yco252444-blip/gamja/none.md

# 미해결 항목 (2026-10-29 기준)

## 결정 필요
- [ ] 로드셀 5kg 유지 vs 10kg 교체 — 총 4.5~5.5kg 추정. 5kg 받으면 실제 무게 재서 4kg 넘으면 교체
- [ ] 디스플레이: TFT 3.5"(THL-CD08) vs OLED 0.96" — CAD 기본은 TFT, CLAUDE.md는 OLED. 3.5" 주문 여부 확인, 4" 교체 안 함 권장
- [ ] TFT 터치 사용 여부 — 안 쓰면 4선(SCK·MOSI·CS·DC)
- [ ] 아크릴 두께 3 vs 5 — 3t는 바닥 접시머리 M4 약함 → 5t 또는 냄비머리
- [ ] 케이스 뚜껑 여는 방식 (M3 8개 vs 자석)

## 주최측 문의
- [ ] 사전 제작 허용 범위 (makedot.edu@gmail.com)
- [ ] 외주 아크릴 레이저 제작물 사용 가능 여부, 예산
- [ ] 공구 대여: 글루건·실리콘, 납땜 인두·납, 열수축·스트리퍼, 멀티미터, 3D 프린터

## 구매·주문
- [ ] 아크릴 업체 견적·주문 (DXF `cad/dxf/` 6장, 11/1~2 주문 권장). 바닥판 접시머리는 따로 가공 요청
- [ ] 다이소 3L 밀폐용기 1개 추가 (같은 제품), 단열판, 방수판 PET 0.5
- [ ] 파파모미 PPR-123 (10/30 주문 예정)
- [ ] 추가 주문 예산 초과분 조정

## 실측 (미검증 값)
- [ ] 3L 통 높이(99), 바닥(240×170), 벽(3), 뚜껑(10)
- [ ] 로드셀 크기 80×12.7, 볼트 M4·간격 15 — 데이터시트 없음, 온도 범위 모름
- [ ] TFT 화면 세로 위치(가운데 가정), 유리 두께, 헤더 깊이
- [ ] 매트 케이블 선 개수·저항 (⑦⑧)
- [ ] 리락쿠마 배터리가 돼지머리 안에 들어가는지

## CAD 남은 일
- [ ] 실측 후 파라미터 수정
- [ ] 로드셀 스페이서 길이(30, 1/4보다 김), 격자판 3mm 강성 확인
- [ ] 회로 고정 위치: HX711, 전원 기판(MOSFET·퓨즈·WAGO), 서모스탯
- [ ] v02(옛 분해도)를 2b 방식으로 정리할지

## 문서
- [ ] CLAUDE.md #3 보드 표시창 항목을 디스플레이 결정 후 수정
- [ ] 배선도 Artifact 링크 삭제됨 — 필요하면 새로 올리기 (PDF는 최신)
