yco252444-blip/gamja/progress1028.md

# Oink 진행 정리 (2026-10-28)

제14회 Creative Space G AI&IoT 메이커톤 (본선 11/6~7), 오잉크팀 미생물 음식물 처리기.
"미검증" 표시는 실측·실물 확인 전인 값.

---

## 1. 부품 목록 / 구매

- 최신 소자 목록: `카카오톡 받은 파일/Oink_사용소자_목록_v11.xlsx` (합계 148,196원)
  - 전력 측정 부품 제거, 전 항목 링크 첨부 (행 밀림 오류 수정함)
- 황화수소 센서 **MQ-136으로 확정**
  - MQ-135(복합가스라 개별 가스 구분 불가), MQ-137(시험 시 잘 안 됨) 제외
  - 보드 포함 저가 모듈은 해외 배송뿐. 네이버 DONG 22,800원(색상 옵션 기본)도 해외 배송 7~9일
  - 국내 디바이스마트/엘레파츠는 소자 단품 52,250원 (보드 없이 부하저항 달아 사용 가능)
- 추가 주문서: `메이커톤-물품구매신청서_오잉크팀_추가주문.xlsx`
  - 추가: HX711 2,200 / 퓨즈 3A 198×2 / MQ136(디바이스마트) 52,250
  - 합계 352,166원 → **예산 초과**
  - 단가 주의: MH-Z19E 24,300 표기 → VAT 포함 26,730 / ANEX 드라이버 31,400 → 34,540
  - 디바이스마트 66,000원 이상 무료배송
- **아직 목록에 없음: 패드 스위칭용 MOSFET 모듈 또는 릴레이 모듈**

## 2. 스킬

- `mitsuhiko/agent-stuff/skills/openscad` → `.claude/skills/openscad` 설치 (Windows 경로 패치, 미커밋)

## 3. 외관 CAD (`cad/oink_exterior.scad`)

- OpenSCAD, `view=` 번호로 부품별 보기
  - 1 전체조립, 2 분해도, 3 앞판, 4 뒤판, 5 왼쪽판, 6 오른쪽판, 7 바닥판, 8 뚜껑, 9 브래킷16
  - 10 돼지머리 조립, 11 머리몸통, 12 돼지 뒤판(센서판), 13 코+귀, 14 칸막이, 15 뒤판 뗀 모습
  - 16 평면 치수도, 17 측면 치수도, 18 이음판 13개
- 치수
  - 육묘패드 220×150 → 챔버(락앤락 통) 230×160×350 (여유 2 + 벽 3, 높이 30~40cm 중 35)
  - 패드는 통 바닥에 깔고 그 위에 흙 바로
  - 케이스 바깥 246×220×391, 벽 두께 4, 챔버~벽 간격 4
  - 앞쪽 전장칸 40mm (칸막이로 분리: 보조배터리·LCD·회로)
  - 바닥 25mm는 로드셀 층
- 출력: 뱀부 P1S(베드 256) 기준. 벽판 높이 383 > 256이라 위/아래 2조각 + 이음판(M3) 13개
  - `half=1/2`로 조각별 STL, 모서리는 L 브래킷(M3)
- 돼지머리: 마인크래프트풍 둥근 네모(100×90×80), 속 빔
  - 뒤판 = 센서판 (M3로 모서리 보스에 체결), 코·세모 귀는 따로 출력해서 본드
  - 심부온도 탐침 구멍은 머리 밑
- LCD(THL-CD08) 치수: PCB 96×55, 구멍 Ø3.2 간격 90×49.5 (표시영역은 추정 74×50)
- 결과물: `cad/previews/` 미리보기 19장, `cad/stl/` STL 17개 (왼쪽판_위 누락 문제 해결함)
- 시제품 개념도(초기안, 돼지머리 이전): https://claude.ai/artifact/GmqkkYFcXGFWjeHJrM2cas

## 4. 전원·배선

배선도 페이지 (팀 구상 + 권장안 + 피드백 + 핀표 + 전력 예산):
https://claude.ai/artifact/RuXnQ4B4q9YJevh5LUJhgb (비공개, 팀 공유는 Share 메뉴에서)

### 팀 구상
| 위치 | 내용 | 전원 |
|---|---|---|
| 돼지머리 | XIAO #1 + MQ-136 + MH-Z19E + DS18B20 | 리락쿠마 보조배터리 (10000mAh, 22W, 고리형 케이블) |
| 락앤락 통 | 육묘패드 + 로드셀, 선은 통 밖으로 | 외부전원, **전용 XIAO #2**가 제어 |
| 케이스 | XIAO #2(패드·로드셀), XIAO #3 + OLED | 외부전원 선 1개 → 벅컨버터 → XIAO 2개 |

### 전력 예산 (데이터시트 기반 추정, 미검증)
- 외부 어댑터 쪽: 패드 1.7A + XIAO 2개 0.3A + 디스플레이 0.09A + HX711 → 평균 약 2.1A, 최대 약 2.5A
- 돼지머리 배터리 쪽: 평균 약 0.37A, 최대 약 0.66A → 10000mAh 기준 약 17시간
- 보조배터리 하나로 4보드+패드 전부는 불가 (5V 3A 이하, 패드 포함 시 약 2.5시간)

### 피드백
- 필수
  - 패드는 MOSFET/릴레이 경유, 신호핀 100kΩ 풀다운으로 부팅 시 OFF, 센서 실패 시 구동 거부
  - 패드 선에만 퓨즈 3A
  - 서모스탯 MS-1-60N 패드 전원선 직렬 + 방수 처리 (미검증)
  - MQ-136 AO는 10k/15k 분압 후 D0 (5V 출력이 ESP32 3.3V 초과)
  - DS18B20 DQ–3V3 사이 4.7kΩ 풀업
  - 케이스 쪽 GND 공통 (어댑터, XIAO #2·#3, HX711, MOSFET)
- 권장
  - 5V 4A 어댑터(보유) 쓰면 벅컨버터 불필요 → 단자대 분배. 12V면 XL4015급 5A 벅
  - MH-Z19E VIN 5V, UART는 3.3V라 직결 (TX↔RX 교차)
  - 로드셀 인출 구멍 그로밋/실리콘 실링, HX711은 케이스 쪽
  - XIAO 5V 핀 급전 중 USB 동시 연결 주의 (미검증)
  - GPIO3(D2)은 부팅 스트래핑 핀이라 출력에 쓰지 않음

### 핀 배치 (권장안)
- XIAO #1: D0←MQ AO(분압), D1↔DS18B20, D6 TX→MH-Z19E RX, D7 RX←MH-Z19E TX, 5V→MQ·CO₂, 3V3→DS18B20
- XIAO #2: D1→MOSFET, D4←HX711 DT, D5→HX711 SCK, 3V3→HX711
- XIAO #3: D4 SDA, D5 SCL (OLED) / TFT면 SCK D8, MOSI D10, CS D1, DC D0, RST D3

## 5. 팀이 정해야 할 것

- [ ] 외부 어댑터 전압 (5V 4A 보유분 쓸지, 12V 쓸지)
- [ ] 디스플레이 OLED vs TFT(THL-CD08) → 앞판 화면 구멍 치수 영향
- [ ] 보드 3개 확정 여부 (기존 4개 중 게이트웨이 제외?)
- [ ] 리락쿠마 배터리 크기가 돼지머리 안쪽(약 95×85×75) 들어가는지
- [ ] MOSFET 모듈 / 릴레이 모듈 구매
- [ ] 추가 주문 예산 초과분 조정

---

## 심야 (10/29 새벽)

### 주요 쟁점
1. **로드셀 5kg vs 10kg**
   - 위 3L·돼지머리까지 전부 로드셀 하나가 받침. 총 무게 4.5~5.5kg 추정(미검증) → 5kg는 한계 근접, 넘으면 값 틀어짐·변형 위험
   - 10kg면 약 2배 여유, 모양 같음(치수 미검증), 정밀도는 낮아지나 HX711로 수 g 단위 가능
   - 현재: 5kg(주문함) 유지, 문의 후 결정. 받으면 실제 무게 재서 4kg 넘으면 교체
2. **3D 프린트 베드 초과 → 외부 케이스 아크릴**
   - 현재 CAD(아크릴 3t): 바깥 264×237×254.2. 앞뒤판 264×248.2, 바닥·뚜껑 264×237 → P1S 256보다 가로 8 초과 (옆판 231×248.2만 들어감)
   - 가로 264 = 통 250 + 틈 4×2 + 벽 3×2 → 줄이기 어려움. 출력해도 판마다 수 시간
   - 결정: 외부 케이스 6장은 아크릴 레이저 주문제작(DXF), 3D 출력은 L 브래킷·TFT 거치부·로드셀 받침·스토퍼·격자판·돼지머리만
   - 확인: 아크릴 두께(3/5), 업체 견적·납기(11/1~2 주문 권장), 예산, 외주 제작물 허용 여부

### 챔버 구조 확정 (다이소 3L ×2, 바닥 25×18cm, 같은 제품)
- 아래부터: 케이스 바닥 → 로드셀(받침 포함) → 격자 거치판 → 단열판 5 → 육묘패드 → 방수판 PET 0.5 → 아래 3L(흙만) → 3L 뚜껑(가운데 탐침 구멍) → 돼지머리 → 위 3L 뒤집어 덮개 → 케이스 뚜껑
- 돼지머리는 위 3L 안에 들어감 (100×80, 높이 70, 귀 포함 93 — 높이 2cm 줄임)
- 4L 통·선반 안 씀. 패드 위에 방수판, 그 위에 통 바로 얹음 (트레이 벽·천장 없음)
- 물 빼는 구멍 없음: 톱밥·코코피트 혼합 + 패드 가열 + 뚜껑 환기, 로드셀 무게가 계속 늘면 펌웨어 경고
- 구멍: 뚜껑 가장자리 Ø3~5 ×6~10, 위 3L 옆면 Ø5, 아래 통 바닥·옆 아래쪽은 금지 (손 드릴/인두)

### 로드셀
- 디바이스마트 no=1360976, 5kg 4선식 알루미늄 막대, (주)우정하이텍, 최대 10V, 1000±10Ω. 데이터시트 없음, 온도 범위·구멍 크기 미검증
- 패드 열 차단 위해 단열판 필수 (보통 보상 온도 -10~40℃, 일반값 미검증). 열 받는 출력물은 PETG
- 구조: 로드셀 하나가 전체를 받침 (주방 저울 방식). 기둥은 없애고 아래 받침 3mm를 바닥판에 볼트, 위 받침 3mm는 반대쪽 끝에 격자판 고정. 로드셀 가운데는 위아래 3mm 이상 비움. 볼트 M4 (미검증)
- 격자판 가운데 = 로드셀 가운데. 바닥 네 구석에 기울어짐 스토퍼(판과 1.5mm 띄움)
- 받침 층 목표 약 30mm (받침 3 + 로드셀 12.7 + 받침 3 + 격자판 3 + 단열 5 + 패드 3 + 방수 0.5)
- **용량 문제:** 총 무게 4.5~5.5kg 추정 → 5kg는 한계 근접. 지금은 5kg 유지, 10kg 교체는 문의 후 결정

### 케이스
- 위 여유 30 → 10mm. 예상 높이 약 256mm (P1S 베드와 비슷, 미검증)
- 판이 베드(256) 초과 → **외부 케이스는 아크릴 레이저 주문제작** (판 6장 DXF, 두께 3 or 5 미정)
- 3D 출력은 모서리 L 브래킷(M3), TFT 거치부, 로드셀 받침, 격자판, 돼지머리만
- 주문 제작은 3~5일 걸릴 수 있어 11/1~2 주문 권장. 예산·외주 제작물 허용 여부 주최측 확인 필요

### 디스플레이: TFT THL-CD08 (디바이스마트 no=15454171, 판매처 도면 기준)
- PCB 55.1×96.18, 화면 48.96×73.44 (위아래 위치는 가운데로 가정, 미검증), 고정 구멍 Ø3.2 ×4 간격 49.5×90
- ILI9488 SPI, VCC 3.3~5V(보드에 3.3V 레귤레이터), 로직 3.3V, 90mA. 백라이트는 트랜지스터 경유라 PWM 가능. 터치 ADS7843(SPI 공유)
- XIAO #3 핀 (권장안, 미검증): SCK D8, MOSI D10, MISO D9, CS D1, DC D0, RST D3, LED D6, T_CS D7, T_IRQ D4 → GPIO 11개 중 9개
- 선이 많아서 **터치 빼고 SCK·MOSI·CS·DC 4선**(RST·LED는 3V3) 권장. OLED 대신 TFT 쓸지는 팀 확정 필요

### 재료표 PDF (`Oink_패드전원배선_재료표.pdf`)
- 순서: 배선도 → 번호별 부품 설명 → 전원 배선에 필요한 부품(+물 빼는 구멍 메모) → 3L+3L 적층 구조 → Oink 전체 재료. 부분마다 새 페이지
- 추가: 단열판, 방수판 PET 0.5mm, 로드셀 아래 틀 + 거치판(PETG), 다이소 3L 1개 추가 구매
- 신설 "주최측 문의": 글루건/실리콘, 납땜 인두·납, 열수축·스트리퍼, 멀티미터, 3D 프린터 사용
- 배선도 Artifact 링크는 삭제됨 (PDF만 최신)

### 작업 방식
- CAD는 `.claude/skills/openscad` 스킬로, 인수인계는 `cad/HANDOFF.md`
- 서브에이전트는 compact 불가 → 짧게 끊고 HANDOFF 파일로 새 에이전트에 넘김 (`.claude/skills/agent-handoff`)
- 배선도 도구 추천: WireViz + schemdraw. Context7는 펌웨어 단계에서. 토큰 절약: 작업 사이 /clear, 작은 수정은 가벼운 모델

### 질문·답 정리 (심야)
- **XIAO 핀이 9개?** → 아님. XIAO GPIO는 D0~D10 11개, TFT+터치를 다 쓰면 그중 9개 사용. 남는 핀 D2(스트래핑, 출력 금지)·D5
- **TFT 배선이 너무 많지 않나?** → 터치 빼면 6선, RST·LED를 3V3에 묶으면 4선(SCK·MOSI·CS·DC), OLED는 2선. 4선 권장
- **격자판·바닥 사이에 뭐 필요?** → 로드셀 양 끝 받침(볼트 고정) + 구석 기울어짐 스토퍼 4개 필요
- **로드셀 하나로 균형 잡히나?** → 잡힘. 주방 저울 구조(평행 빔이라 쏠림 보정). 조건: 판 가운데 = 로드셀 가운데, 받침은 막대 폭 전체. 좌우 비틀림에 약해 스토퍼 권장
- **로드셀 원래 비대칭?** → 맞음. Z자 고정: 한쪽 끝은 바닥, 반대쪽 끝은 판. 가운데(휘는 부분)는 위아래 비움. CAD에서 아래 받침이 가운데 쪽에 있어 수정 지시
- **무게 많이 나갈 텐데?** → 총 4.5~5.5kg 추정, 5kg 한계 근접. 10kg면 2배 여유. 일단 5kg 유지, 문의 후 결정
- **받침이 왜 더 높아짐(40.2→45.2)?** → 양 끝 받침 추가하면서 기존 기둥을 남겨서. 기둥 없애고 바닥판에 바로 볼트 → 약 30mm
- **베드 초과?** → 바닥·벽판 모두 256 초과. 케이스는 아크릴 주문제작, 3D 출력은 작은 부품만
- **디스플레이가 이리 작다고?** → 실제 크기(3.5", 화면 49×73). XIAO로 쉬운 건 4"(ST7796S)까지, 커지는 폭 작음. 더 큰 것 사지 말고 웹 대시보드(휴대폰·노트북) 병행 권장. 3.5" 미주문이면 4" 고려
- **CAD 문제 지적:** 뒤판 프리뷰(v04)가 작게 찍힘 → 화면 맞춤 재렌더 지시 / TFT가 앞판이 아니라 케이스 안에 떠 있음 → 앞판 구멍 뒤로 / 분해도에 부품명 없음 → v02b(번호+이름표) 추가 지시

### 남은 일
- [ ] CAD: 받침 낮추기·위 여유 10 반영 후 아크릴 판 DXF + TFT 거치부 (에이전트 진행 중)
- [ ] 로드셀 5kg/10kg 결정, 실물 치수·볼트 크기 재기
- [ ] 아크릴 두께 결정, 업체 견적·주문
- [ ] TFT vs OLED, 터치 사용 여부, 3.5"/4" 확정 (3.5" 주문 여부 확인)
- [ ] 주최측 문의: 사전 제작 허용 범위, 외주 아크릴, 공구
- [ ] 3L 통 높이 실측 (지금 99mm는 미검증)
