yco252444-blip/gamja/설계_1031/HANDOFF.md

# cad 인수인계 (oink_exterior.scad, 10/31 재설계)
## 10/31 변경 (렌더 미실행 = 미검증. 수치는 식으로 계산)
- 챔버: 3L 락앤락 → **12x12x12 통 2개** (chamber 120x120, box_bot 120x120 곧은 벽 가정, lock3_h 120, 뚜껑 10 유지)
- 받침: 단열판·육묘 패드(150x220) → **히팅패드 Ø90 (3) → 방열판 Ø90 (5)** → 방수 0.5. 층 높이 유지 → 받침층 **30.2** 그대로
  - 순서(패드 아래, 방열판 위)는 가정. 반대로 하려면 pad_z/hs_z 두 줄만 바꿈
- 격자판 250x180 → **120x120**. 멈춤 기둥 4개: 모서리 → **네 변 가운데** (바닥 L 브래킷과 겹침 방지)
- 돼지 머리 변경 없음 (100x80x70, 귀 93). 통 B 안 114x114x117 → 귀 여유 **24**
- 결과: 바깥 **134 x 160 x 296.2** (가로 x 깊이 x 높이), 여유 top_gap 10, 탐침 102, 흙 최대 117
- 이 폴더(`설계_1031/`)가 10/31 설계 전부. 이전(10/29) 설계·DXF·STL·previews 는 `cad/` 에 그대로 (아크릴 주문에 쓰지 말 것)
- DXF·격자판 STL·previews 는 이 폴더에서 `render_1031.bat` 실행해 생성 (dxf/, stl/, previews/ 로 나옴)
- `stl/` 7개(브래킷·TFT마운트·스페이서·멈춤기둥·돼지 3종)는 10/29 파일 복사본, 치수 변화 없음

## (이하 10/29 기록. 치수는 위 10/31 값이 우선)
## 구조 (아래→위) · 숫자는 ECHO 기준
바닥판(아크릴) → 아래 스페이서 3 → 로드셀 5kg 12.7 → 위 스페이서 3 → 격자 받침판 3 → 단열 5 → 패드 3 → 방수 0.5 (받침층 **30.2**)
→ 3L A(흙) 99 → 3L 뚜껑 10 → 돼지 머리(70, 귀 포함 93, 변경 금지) + 뒤집은 3L B 99 → top_gap **10** → 뚜껑
- 바깥 **264 x 220 x 254.2** / 흙 깊이 최대 96 (가정 50) / 귀 여유 **3** / 탐침 81
- 로드셀 Z 마운트: 아래 스페이서 = 한쪽 끝(바닥판 밑에서 접시머리 M4), 위 스페이서 = 반대 끝 → 격자판 고정부(칸 통째 채움, 접시는 윗면). 가운데(휨부) 위·아래 3/3. 격자판 중심 = 로드셀 중심
- 격자판 250x180 틈: 옆 4·앞판 30·뒤 4·로드셀 끝 3. 멈춤 기둥 4개(높이 17.2, 틈 1.5). 지지대·칸막이·방수 트레이 삭제
- 케이스 = 레이저 아크릴 6판(acryl_t 3) + 출력 L 브래킷 24개(세로 8·바닥 8·뚜껑 8, M3). 앞·뒤 264x248.2, 옆 214x248.2, 바닥·뚜껑 264x220. 분할 없음
- 앞판: TFT 마운트 구멍 57.36x81.84 + M3 4(간격 70.96x95.44) 하나뿐. 마운트(출력): 턱이 구멍에 끼워 앞면과 평평, 날개 80.96x105.44x3, TFT 보스 M3 4, 창 50.96x75.44
- 케이블: 왼쪽 판 Ø10(앞쪽, 로드셀~패드 높이). 오른쪽 판 USB-C+통풍. elec_gap 30 (최소 18.6 = 마운트 깊이 15.6+3)
## 주요 파라미터
lock3_h, box_bot, lid_t, soil_h, top_gap, elec_gap, acryl_t, kerf, loadcell_kg(5), lc_l/lc_w/lc_bolt/lc_pitch/lc_end, lc_sp, gp*, stop_gap, display("tft"/"oled"), tft_pcb/tft_screen/tft_hole/tft_win_dy/tft_glass_t (4.0" 교체 시 이 값만)
## view / 파일
1 조립 · 2 분해 · "2b" 층 분해(이름표 없음) · 3~8 아크릴 판(앞·뒤·왼·오른·바닥·뚜껑) · 9 L 브래킷 · 10~13,15 돼지 · 16 평면 · 17 측면 · 19 받침 조립 · 20 스페이서 · 21 격자판 · 22 멈춤 기둥 · 23 TFT 마운트 · 24 마운트 조립 · 25 로드셀 근접 옆 · 30~35 DXF (14 칸막이·18 이음판 없음)
- previews/ (v01~v25, v21b 고정부 근접), previews/hires/v02_분해도_hi.png · v02b_분해도_hi.png (3200x2560) · v02b_parts.txt (부품별 픽셀 중심, 카메라 투영·표식 렌더로 확인)
- dxf/ 6판 (관통 구멍만). stl/ 출력 부품 8개: TFT마운트, L브래킷_24개, 스페이서2개, 격자받침판_PETG, 멈춤기둥4개, 돼지 3종 (모두 25초 이내)
## 확정 (판매처 도면 기준)
TFT THL-CD08: 기판 55.1x96.18x1.6, 화면 48.96x73.44, 구멍 Ø3.2 49.5x90, 헤더 14핀(10.99부터 33.02)·4핀(24.48부터 7.62)
## 미검증
- 3L 통 높이 99·바닥 240x170·벽 3, 뚜껑 10, 흙 50, 패드 3, 단열 5, 방수 0.5
- 로드셀 80x12.7, 구멍 M4·간격 15·끝 7.5. **10kg 교체 검토 중 (총 4.5~5.5kg 추정, 미검증)**
- acryl_t 3 (두께 미정, 3 or 5), kerf 0.2, cut_max 600, M3 셀프탭 2.8
- TFT 유리 2.5, 화면 세로 위치(tft_win_dy=0 가운데 가정), 헤더 깊이 8.5
- OLED(선택) 값 전부: 기판 27.3x27.8, 유리 26x15(윗변 4.5), 보이는 영역 22x11, Ø2 23x23, 두께 4
## 남은 일
- 실측(통·뚜껑·로드셀·아크릴·TFT 유리) 후 파라미터 수정
- CLAUDE.md는 #3 표시를 OLED 0.96"로 적음 ↔ 지금 기본 display="tft" → 팀 확정 필요
- 3t 아크릴 바닥 접시머리 M4(깊이 2) 약함 → 5t 또는 냄비머리 검토. 접시 가공은 DXF 밖에서
- 스페이서 30(구멍 2개 덮느라 1/4보다 김), 격자판 3mm 강성, HX711·전원 기판 고정, 서모스탯 자리, 뚜껑 열기(M3 8개→자석?) 미정
- v02(view 2)는 예전 방식(벽 70 벌림, 브래킷 제자리). 필요하면 2b 방식으로 정리
