yco252444-blip/gamja/md_files/00_Oink_개선계획.md

# Oink 개선 계획 (조사·평가 통합본)

작성: 2026-09-21. 대상: 미생물 음식물 처리기 제어 솔루션 → 제14회 Creative Space G(2026-11-06~07, 신청 마감 10/16 17:00) 출품용 Oink.
팀: 5인(반도체과 3 = 원작자, 전자과 2 합류).
근거 문서는 같은 폴더 `01~07`. **표기: ✔ 직접 확인·재현 / △ 뒷받침 못 찾음 / ✘ 반증 / 가정 = 근거 없는 전제(확인 필요).** 이 문서에 시크릿 값은 쓰지 않는다.

## 0. 문서 지도
| 파일 | 내용 |
|---|---|
| `01_프로젝트_설명_최신.md` | ZIP 실물 기준 프로젝트 설명(정정 반영) |
| `02_적대적검증_종합.md` | 데이터·AI·제어코드·구조·현실성·부품·종합 판정 |
| `03_부품_속도_신뢰성.md` | 센서·INA219·릴레이·Modem-sleep 데이터시트 검증(에이전트) |
| `04_보드_전원_안전.md` | 보드 비교·Pi 신뢰성·전원 예산·히터 안전·열 시상수(에이전트) |
| `05_발표자료_전사_및_코드대조.md` | 슬라이드 14장 전사 + 주장별 코드 대조 |
| `06_대회적합성_보완계획.md` | 심사항목 자체평가·규정 리스크·P0~P3 일정·스위치 |
| `07_선행제품_조사.md` | 린클·스마트카라 등 선행제품·통계 |
| `재현검증/verify_model_baseline.py` | 모델 기준선 비교 재현 스크립트 |

## 1. Oink의 목표 재정의
- **MK1(발표자료)**: "온디바이스 AI가 히터를 예측 제어해 월 1,500원대 절전".
- **Oink**: "**측정으로 입증된 히터 듀티 감축 + 안전 3중 방어 + 냄새(가스) 기반 경보**". AI는 *기준선을 이겼을 때만* 전면에 내세운다. 못 이기면 "규칙 제어 + 급변(투입물) 감지"로 서사를 정직하게 낮춘다.
- 승부 지점(차별 후보, 07 조사): ①가스 센서 기반 폐루프 ②**실측 전력 A/B 비교** ③투입물 급변 대응. 상용품(린클 등)이 앱·활성도·에러알림은 이미 표방하므로 "센서+앱"으로는 창의성 방어가 안 된다.

## 2. 문제 → 개선 통합표

우선순위: **P0**(안 하면 신청·심사에서 탈락 사유) / **P1**(승부 요소) / **P2**(완성도) / **P3**(여유 시).

### 2-1. 신뢰·정직성 (발표·신청서)
| ID | 문제(근거) | 개선 | 우선 | 검증 기준 |
|---|---|---|---|---|
| T1 | "3개월 실측 75% 절감" — 실제 데이터는 07-30 약 7시간, 전력 데이터 0 (05, 02 ✔) | 문장 삭제. 실측 후 실제 수치로 대체 | P0 | 발표에 나오는 모든 수치에 로그 파일 근거 |
| T2 | 180→35mA "75%"는 산수 오류(80.6%), 180mA는 공식 근거 없음, 슬라이드 간 수치 불일치 (03 ✔) | 자체 전류 실측(전력계)으로 단일 수치 | P0 | 측정 절차·장비를 슬라이드에 명시 |
| T3 | "월 1,500원대 vs 월 5~8만 원" — 칩과 히터 포함 기기를 비교 (05, 03 ✔). 절감분 0.48W는 히터 100W의 0.48% | 비교 대상 정정: "히터 듀티 감축 Wh"만 절전 주장 | P0 | A/B 실험 결과(T-A/B) |
| T4 | "0.1초 Fail-Safe" — 센서 변환 ≥0.09초+MQTT 지연, 코드 상수는 15~20초 (03, 05 ✔) | "하드웨어 서모스탯 즉시 차단(측정 응답 시간 표기)"로 교체 | P0 | 서모스탯 동작 온도·응답 실측 |
| T5 | "온디바이스 AI" — 추론이 Pi에서 실행(01 ✔) | ESP32 로컬 실행으로 이전(A2)하거나 "엣지(Pi)"로 정정 | P0 | 실행 위치 코드로 확인 |
| T6 | 5개 모드 분류(CLASS 0~4), VOC·챔버 습도·모터 전류 — 코드·센서에 없음 (05 ✔) | 구현 전까지 삭제, 구현하면 실험으로 입증 | P0 | 라벨 데이터와 혼동행렬 |
| T7 | 시장 1조 원 차트 — 출처 불명 AI 이미지 (05 △) | 공식 통계로 교체(07의 정책브리핑 29% 등, 연도 명시) | P1 | 출처 URL |
| T8 | 원 대회 발표물 재활용 → 재출품·사전 제작물 규정 (06 ✔ 미확인) | 운영사 문의 메일(§6) + 신청서에 사전 준비물/현장 제작 표 분리 | P0 | 운영사 서면 답변 |

### 2-2. AI·데이터
| ID | 문제(근거) | 개선 | 우선 | 검증 기준 |
|---|---|---|---|---|
| D1 | 245샘플이 연속 구간 2개에서만, 검증 49개는 한 구간·정답 전부 25.5℃ (02 ✔ 재현) | 실운전 데이터 재수집: 목표 온도대·히터 ON/OFF·**뜨거운/찬 물 투입** 이벤트, 6시간+, 여러 날 | P1 | 훈련/검증을 **다른 날**로 분리 |
| D2 | 기준선(지금값 유지)이 RF보다 좋음 — 검증 0.000 vs 0.032, 구간 교차 0.00~0.18 vs 0.30~0.44 (02 ✔ 재현) | 기준선 3종(지금값, 선형 외삽, 히스테리시스만)과 RF·단순 ARX/뉴턴 냉각 모델 비교 | P1 | 기준선 대비 MAE·오버슈트·Wh 개선폭 표 |
| D3 | 예측 31℃ 클립, 목표 37℃ → 조기 OFF 분기 발동 불가 (01, 02 ✔) | 클립 제거·재학습, 목표 대역 데이터 포함 | P1 | 예측이 목표 −0.2℃에 실제 도달하는 로그 |
| D4 | DS18B20 9-bit → 0.5℃ 단위 (CSV ✔), 기울기 0.3K/분이 양자화에 묻힘 (04) | 12-bit + 비동기 읽기(750ms 변환), 변환 전 읽기 시 85.0 필터 유지 | P1 | 값 분포가 0.0625℃ 단위로 관측 |
| D5 | 열 시상수가 수십 분 단위일 가능성 → 60초 창/120초 예측은 정보량 적음 (04 근거 참조) | 창·예측 지평을 열 응답 실험으로 재설정(스텝 응답 측정 후 결정) | P1 | 스텝 응답 시상수 실측 |
| D6 | DHT11 유효 54%, 추론 성립 프레임 적음 | 추론 유효 조건에서 DHT11/MQ 의존 완화 또는 센서 교체(SHT3x 등, 미검증) | P2 | 유효 프레임 비율 ≥95% |

### 2-3. 센서·부품 (03)
| ID | 문제 | 개선 | 우선 | 검증 기준 |
|---|---|---|---|---|
| S1 | MQ-138은 톨루엔·아세톤·알코올·수소용, H2S·NH3·머캅탄 아님 → "VOC 폭증=혐기성" 근거 없음 | 가스 주장을 MQ-137(NH3) 추세 경보로 축소, 여력 있으면 MQ-136(H2S) 또는 전기화학 센서 | P1 | 실제 가스 노출 시험(암모니아수 증기 등, 안전 수칙 준수) |
| S2 | MQ 예열 매뉴얼 "Over 48 hours" | 발표 2일 전부터 상시 통전, 캘리브레이션 곡선은 사전 기록 | P1 | 통전 시간 로그 |
| S3 | 5V AO → ESP32 ADC (유효 0~2.9V, 입력 최대 3.6V) | 분압 저항 또는 레벨 조정 확인 후 사용(모듈 분압 여부는 **부품 모델 필요**) | P0 | 최대 출력 시 ADC 입력 ≤2.9V 측정 |
| S4 | DHT11 2초 주기 스펙 위반(1Hz 폴링), 고습·부식 환경 부적합 | 폴링 2초 이상, 챔버 내부 대신 외부 설치 또는 교체 | P2 | — |
| S5 | INA219는 DC 26V·3.2A 한도, AC 220V 직결 불가·위험 | **히터를 12V/24V DC 실리콘 패드로**, INA219 유지 | P0 | 12V 히터 전류·전력 실측값 vs 외부 전력계 오차 |
| S6 | 릴레이 전기 수명 10^5회: 30초 주기면 ~35일. 부팅 순간 ON 글리치 | 히터는 MOSFET/SSR, 최소 유지시간 수 분 이상, 부팅 시 게이트 풀다운 | P1 | 부팅 시 히터 출력 오실로/전력계로 무글리치 확인 |
| S7 | MQ 히터 각 150~180mA, 5V 최악 합계 ≈960mA | 5V 2A 이상 전원, 센서용 별도 레일 검토 | P1 | 부하 시 5V 전압 강하 측정 |

### 2-4. 안전 (04, 02)
| ID | 문제 | 개선 | 우선 | 검증 기준 |
|---|---|---|---|---|
| F1 | 독립 하드웨어 차단 없음, 과열 판정이 센서 1개에만 의존 | **12V 라인에 퓨즈 + KSD301 서모스탯 + 열퓨즈 직렬**(SW와 무관하게 차단) | P0 | 서모스탯 설정 온도에서 실제 차단(가열 시험, 사용자 승인 하에) |
| F2 | 하드웨어 워치독 없음(`esp_task_wdt` 미사용) | 워치독 추가, 행 시 히터 출력 OFF로 귀결 | P1 | 강제 행 시험에서 히터 OFF |
| F3 | 릴레이 융착 감지 없음 | INA219로 "OFF 명령인데 전류 있음" 감지 → 알람·차단 | P1 | 모의 융착 시 경보 |
| F4 | 명령 유효 20초 vs 추론 주기 10초: 2번 유실이면 OFF | 히터 결정을 ESP32 로컬로 이전(A2)해 서버 의존 제거 | P1 | Wi-Fi 차단 시에도 안전 제어 유지 |
| F5 | 연속 가열 300초 상한에 근거 없음 | 열 시상수 실험 후 상한 재설정(D5) | P2 | — |
| F6 | MQTT 익명 접속 + 0.0.0.0 (02 ✔) | 전용 AP·비밀번호 또는 인증 설정, 시연장 공용 Wi-Fi 금지 | P1 | 외부 단말 발행 시 거부 |
| F7 | 220V 전열기구를 시연장에서 쓸 수 있는지 미확인 | DC 히터로 우회(S5) + 운영사 문의에 포함 | P0 | 운영사 답변 |

### 2-5. 구조·구현
| ID | 문제 | 개선 | 우선 |
|---|---|---|---|
| A1 | 두 파이프라인 분리(센서↔앱 mock), 앱 소스 없음 | 앱은 mock 제거·게이트웨이 실데이터 연동, 앱 소스 저장소 편입 | P2 |
| A2 | 제어·추론이 Pi 서버 의존 (04: ESP32 단독으로 충분) | **v2: ESP32 로컬 제어(히스테리시스+급변 감지+안전 게이트), Pi/노트북은 로그·대시보드만** | P1 |
| A3 | 최신 설정에서 MQ·릴레이·INA219 비활성(07-31 복구 모드) | 복구 모드 해제 절차 문서화 후 하나씩 재활성 검증 | P1 |
| A4 | 인수인계 문서 3종 모순(COM6/COM8, D4/D5 vs D6/D7) | 실물 배선 사진 기준으로 단일 문서(`md_files/` 핀맵) 작성 | P1 |
| A5 | `predict_service.py` 수동 실행, 게이트웨이 상태 인메모리 | ESP32 로컬화로 필요성 감소. 로그는 파일 저장 | P2 |
| A6 | 시연 안정성 | 전용 소형 공유기(2.4GHz 고정), 백업 영상, 예비 XIAO 2개 이상(이전 GPIO5/6 손상 이력) | P1 |

## 3. 목표 아키텍처 (Oink v2, 제안)
```
[12/24V DC 어댑터] ─ 퓨즈 ─ 서모스탯(KSD301) ─ 열퓨즈 ─ [히터 패드] ─ INA219(션트) ─ MOSFET/SSR ─ GND
                                              ▲ 독립 하드웨어 차단(SW 무관)
[5V ≥2A] ─ XIAO ESP32S3 ─ DS18B20(12bit) / DHT11(외부) / MQ-137(분압) / (선택)MQ-136
   ESP32: 히스테리시스+급변 감지+안전 게이트(과열·센서무효·워치독) → 히터 출력  ← 서버 없이 동작
   ESP32 → MQTT(전용 AP) → 노트북/Pi 대시보드(로그·시각화·A/B 표시) [제어 경로 아님]
```
※ 부품 모델·전원 규격은 확인 전 **가정**. 실제 부품 정보를 받으면 핀맵·배선도를 이 구조에 맞춰 확정한다.

## 4. 실험 계획 (신청 후~11/5 사전 검증, 이 결과가 발표 수치가 된다)
| 실험 | 절차 | 산출 |
|---|---|---|
| E1 스텝 응답 | 챔버 모형(단열 용기+발열체+교반)에서 히터 ON/OFF 스텝, 온도 로깅(12-bit) | 열 시상수 → 창·지평·연속 가열 상한 결정 |
| E2 투입물 이벤트 | 뜨거운/찬 물 투입 5회+ 반복 | 급변 감지 규칙의 재현율·오탐 |
| E3 A/B 전력 | 동일 조건에서 (a)히스테리시스만 (b)AI/예측 보조 — 각 6시간+, 다른 날 반복 | Wh, 오버슈트, 목표대역 체류 시간 표 |
| E4 가스 | 안전 조건에서 암모니아 증기 노출·MQ 응답(예열 48h 후) | 응답 곡선, 경보 임계 |
| E5 안전 | 서모스탯·열퓨즈 동작, 센서 탈락·Wi-Fi 차단·행 시험 (사용자 승인 후) | 차단 시간 측정값 |

## 5. 역할 배분(제안)
| 그룹 | 담당 |
|---|---|
| 원작자 3(반도체) | 코드 소유자: 데이터 재수집·기준선 비교(D1~D3), ESP32 로컬 제어 이전(A2), 대시보드·발표·통계 |
| 전자 2 | 12V DC 히터·MOSFET·안전 3종(F1), 전원·분압·배선(S3, S5, S7), INA219 실측·융착 감지(F3), 챔버 모형 |
| 공통 | 인터뷰 1건, 신청서, 백업 영상, 운영사 문의, 핀맵 단일화(A4) |

## 6. 일정·스위치 (06과 동일 기준)
| 날짜 | 할 일 | 미충족 시 |
|---|---|---|
| 9/21~9/24 | 운영사 문의(사전 제작물·재출품·**전열기구·DC 전원 사용**·부품 제공·예선 여부), 민감정보 정리(키 재발급, 시크릿 폴더 분리), 부품 모델·히터 사양 확정 | — |
| 10/2 | 운영사 답변 확보 | 이 프로젝트 제외, 06 Top3로 |
| 10/9 | 선행제품 대비 차별 한 줄 + 인터뷰 1건 + 신청서 초안(사전 준비물/현장 제작 표) | Top3 신청서로 전환 |
| 10/12 | 신청서 문장이 모두 사실로 뒷받침(T1~T6 반영) | "AI"·"절전" 표현 축소 |
| 10/13~10/15 | 팀원 5명 전원 개별 신청·제출 확인 캡처 | — |
| 10/16 17:00 | 신청 마감 | — |
| 10/17~11/5 | E1~E5 사전 검증, 부품 발주(국내 재고 우선), 백업 영상 | — |
| 11/6~7 | 현장 20h: 통합·A/B 시연·발표 | — |

## 7. 아직 모르는 것 (사용자 입력 필요)
1. 릴레이·MQ·INA219 **부품 모델/판매 링크**(보드별 회로가 다름)
2. 히터 종류(AC/DC), 정격 W, 어댑터 규격
3. **실물 배선 사진**(문서 3종 모순 해소)
4. 운영사 답변(사전 제작물·전열기구·예선)
5. 시크릿 정리 방식(ZIP 사본에 API 키·Wi-Fi 정보 포함 → 재발급 후 폴더 분리)

## 8. 이 계획의 한계
- 열 시상수·서모스탯 사양 등 일부는 에이전트 조사의 2차 출처·가정이며 실험 전 수치로 쓰면 안 된다.
- 12V 히터·MOSFET·서모스탯 조합의 구체 부품 번호는 미확정(부품 정보 수령 후 제안).
- 예측 AI가 기준선을 이길지는 **미지**(현재 근거로는 못 이김). 실험 E3 결과에 따라 서사를 바꾼다.
- 대회 심사 배점·14회 예선 여부는 미확인.
