yco252444-blip/gamja/md_files/01_프로젝트_설명_최신.md

# AI 절전형 스마트홈 / 온디바이스 AI 기반 미생물 음식물 처리기 제어 솔루션 (AI Energy Smarthome)

> **문서 기준일: 2026-09-21 (최신화).** 근거 = `AI_energy_smarthome.zip` 스냅샷을 직접 열람·계산한 결과(마지막 커밋 2026-07-30, 인수인계 문서 2026-07-31).
> 상태 표기: **[구현 완료]** 코드+실측 확인 · **[부분구현/테스트중]** 코드는 있으나 검증 미완/일부 비활성 · **[설계 완료, 구현 예정]** 코드 없음 · **[제외 결정]** 검토 후 사용 안 함 · **[미확인]** ZIP에서 확인 못 함.
> 표기 규칙: "직접 확인" = ZIP 안 코드·CSV·문서를 읽거나 계산 / "문서 기재" = 프로젝트 문서의 주장(실기 재검증 안 함).

## 0. 이번 최신화에서 바뀐 것 (정정 목록)

| 항목 | 이전 문서 | 최신(ZIP 직접 확인) |
|---|---|---|
| AI 추론 | Dummy 엔진뿐, 학습 모델 없음 | **RandomForest 모델이 학습·내보내기 되어 있음**(`ai-training/`). 추론은 ESP32가 아니라 **Pi(`predict_service.py`)에서 실행**하도록 이전됨. 단 §9.4의 한계 있음 |
| 히터 제어 | 제어 로직 없음 | **Pi의 제어 판정 함수 + ESP32의 안전 재검증·릴레이 구동 코드가 존재**. 단 최신 `SensorConfig.h`에서 `ENABLE_RELAY_CONTROL=false` |
| 슬라이딩 윈도우 | 자료구조만 있고 미연결 | ESP32 쪽 윈도우·추론 엔진은 제거되고 Pi 서비스가 60프레임 윈도우를 자체 유지 |
| DS18B20 핀 | GPIO27 | 인수인계 문서 기준 **D2/GPIO3** (기존 GPIO27 기재는 구버전) |
| INA219 | 설계만 | 문서 간 모순(§6). 최신 설정은 `ENABLE_INA219=false` |
| 프로젝트명 | AI 절전형 스마트홈 | 발표자료 제목: "온디바이스 AI 기반 미생물 음식물 처리기 제어 솔루션". 단 "온디바이스"는 현재 구조(Pi 서버측 추론)와 어긋남 → §9.4 |
| 앱 | `C:\Users\eunsu\Documents\microbe-app` | **앱 소스는 ZIP에 없음**(`microbe-server/server.py` mock 서버만 포함). 앱 상태는 문서 기재 |

## 1. 한 줄 소개

XIAO ESP32S3 센서 노드가 온도·습도·가스 데이터를 MQTT로 보내고, 라즈베리파이가 이를 중계·저장하면서 **RandomForest 회귀 모델로 120초 뒤 심부온도를 예측**해 미생물 처리기의 히터 제어 판정(정상/저전력 모드)을 내리고, ESP32가 안전 조건을 다시 검증한 뒤 릴레이를 구동하는 구조를 목표로 한 프로젝트. 사용자 앱(microbe-app)은 상태를 미생물 캐릭터의 건강도로 시각화한다.

## 2. 문제 정의 — 기존 방식의 한계

가정용 스마트 플러그/온습도계 대부분은 "지금 값이 기준선을 넘었는가"만 보는 임계값 방식이다.
- 기준을 넘은 **뒤**에야 반응한다(이미 과열·낭비 시작).
- 순간값만 봐서 서서히 오르는 추세와 튀는 노이즈를 구분하지 못한다.
- 여러 센서(온도·습도·가스·전력) 간 관계를 종합하지 못한다.

## 3. 핵심 아이디어 — 예측형 제어

- 입력: 최근 60초(1Hz)의 센서 시계열에서 뽑은 특징(현재값·표준편차·기울기).
- 출력: **120초 뒤 심부온도**(회귀).
- 활용: 예측이 목표온도에 도달할 것 같으면 히터를 **미리 끄는** "저전력 모드"(예측 조기 OFF), 투입물로 인한 급변(뜨거운/찬 물체 투입) 감지.
- **현재 상태(중요)**: 모델·판정 코드·단위 테스트는 있으나 §9.4의 한계로 "AI가 절전에 기여한다"는 주장은 **아직 실측으로 뒷받침되지 않음**.

## 4. 시스템 구조 개요

```
[A. 실제 하드웨어 경로]
XIAO ESP32S3 --MQTT sensors(1Hz)--> Raspberry Pi
                                      ├─ mosquitto 브로커
                                      ├─ gateway(Node.js, Express+Socket.IO): 대시보드·REST API·inference 토픽 수신 표시
                                      ├─ training-data-logger: hardware 프레임만 CSV 저장
                                      └─ predict_service.py (수동 실행): 60프레임 윈도우 → RF 예측 → 히터 판정
                                           └─ smarthome/<id>/inference (heater_command 등) ──> ESP32
ESP32: heater_command 수신 → 자체 안전 재검증(과열·연속가열·명령 stale·MQTT 재연결·센서 무효) → 릴레이

[B. 앱 경로, 부분구현]
microbe-app (Expo/React Native, 소스 ZIP 미포함) --HTTP--> microbe-server (FastAPI, 하드코딩 mock)
```

- **A와 B는 여전히 연결되지 않음**. `microbe-server/server.py`는 온도 24.5, 습도 52.0, CO2 730, NH3 1.2, 목표온도 24.0 등 **고정 상수**를 반환한다(직접 확인).
- `predict_service.py`는 Pi 배포 자동화(`bootstrap.sh`, systemd 유닛 2개: gateway·data-logger)에 **포함되어 있지 않음**(직접 확인: 배포 스크립트에 predict 언급 없음) → 수동 실행.

## 5. 센서·액추에이터 구성 (ESP32S3 노드)

| 대상 | 핀 | 상태 |
|---|---|---|
| DS18B20 (심부온도) | D2/GPIO3 (OneWire), 9-bit | **[구현 완료]** 운영 코드 통합, 실측. 학습 CSV에서 07-30 기준 유효 |
| DHT11 (공기온도/습도) | D3/GPIO4 | **[구현 완료, 유효율 낮음]** 학습 CSV 기준 유효 1,049/1,947행(54%). 2초 주기라 프레임마다 유효/무효 교차(설계상 정상이라고 문서화) |
| MQ-137 / MQ-138 (가스, ADC raw) | D0/GPIO1, D1/GPIO2 (5V 전원) | **[부분구현]** 운영 코드에 통합·실측됐으나 **최신 `SensorConfig.h`는 `ENABLE_MQ137=false`, `ENABLE_MQ138=false`**("새 보드 발표 복구 모드"). ppm 환산 미확정, MQ-138은 재배선 후 원값 10~18로 낮아 open circuit 의심(문서 기재) |
| CM1106 (CO2) | — | **[제외 결정]** 센서 물리적 제거, `ENABLE_CO2_SENSOR=false`. `co2_ppm:null` 고정 |
| INA219 (전압/전류/전력) | I2C 0x40 (D4/D5 또는 D6/D7) | **[미확정]** §6 |
| 릴레이 (히터) | D8/GPIO7, active-high 가정 | **[부분구현]** 부팅 시 강제 OFF는 로그로 확인. **ON 극성(클릭)은 실기 미검증**. 최신 설정 `ENABLE_RELAY_CONTROL=false` |
| 터치(T1/T2)+LED | — | **[구현 완료]** 별도 데모 스케치 |

**주의**: 최신 설정에서 MQ-137이 꺼져 있는데 Pi 서비스의 윈도우 유효 판정(`required_valid`)은 **core_temperature·dht11·mq137이 모두 유효**해야 하므로, 이 설정 그대로면 추론이 `inferable=false`로 남을 가능성이 높다(코드 판독 기반 추정, 실기 재현은 안 함).

## 6. 전력 측정 — INA219

- 목적: 실제 소비전력 실측 → 절감 효과 검증 기준값.
- **문서 간 모순**(ZIP 내 3개 인수인계 문서):
  - `센서_하드웨어_인수인계`: 보드 교체 후 D4/D5에서 I2C 0x40 ACK 정상(주소 응답만 확인, 전압·전류 실측은 안 함).
  - `펌웨어_INA219_릴레이_통합_인수인계`: 다른 보드에서 D4/D5, D6/D7 모두 무응답, 통합 코드는 작성했으나 값은 null.
  - 최신 `SensorConfig.h`: `ENABLE_INA219=false`.
- **결론**: 소비전력 실측 데이터는 **0건**. "절전형"의 정량 근거가 없음.

## 7. 통신 구조 — ESP32 → MQTT → 게이트웨이

### 7.1 기본 흐름 **[구현 완료]**
- `smarthome/<device_id>/sensors` 1Hz JSON: `device_id`, `sequence`, `data_source`(hardware/mock), `sensors`, `valid`, `actuators`.
- 신규: `smarthome/<id>/inference` 토픽(예측 온도·제어 권고·`heater_command`·`control_mode`·`model_version`)을 게이트웨이가 수신·표시(직접 확인: `server.js`가 inference 필드를 파싱).

### 7.2 MQTT 헬스체크 / 좀비 연결 복구 **[구현 완료 — 센서 노드 측]**
- 5초 간격 nonce publish/echo로 RTT 확인, 15초 무응답 시 stale 판정 → 강제 재연결. keepAlive 10초, 소켓 타임아웃 2초.
- 게이트웨이의 30초 오프라인 감지는 별개 로직. 게이트웨이 쪽 healthcheck RTT 처리 코드는 이 문서 작성 시 재확인하지 않음([미확인]).
- 실측 로그(07-31 문서 기재): 7분 캡처, 순단 1회 후 68ms 재연결, 재부팅·Guru Meditation 0건.

## 8. 게이트웨이 서버 (Raspberry Pi) **[구현 완료]**
- Node.js(Express+Socket.IO). REST: `GET /api/devices`, `/api/devices/:id`. Socket.IO: `devices:init`, `device:update`, `led:set`.
- 상태는 인메모리(재시작 시 소실). 학습 CSV는 `training-data-logger.js`가 hardware 프레임만 저장.
- 배포: `bootstrap.sh`(mosquitto·Node·systemd 유닛), `smarthome-gateway.service`, `smarthome-data-logger.service`(`Restart=on-failure`).

## 9. AI 추론·제어 구조

### 9.1 학습 (`ai-training/build_dataset_and_train.py`) — 직접 확인
- 입력 특징 13개: {심부온도·공기온도·습도·MQ-137} × {현재값, 60초 표준편차, 60초 기울기} + (심부−공기 온도차).
- 타깃: **120초 뒤 심부온도**. 60초 윈도우, 2초 stride.
- 모델: 초기 Ridge는 검증 MAE 약 15억 ℃로 폭주해 폐기(`extrapolation blowup`), **RandomForest 채택**. 트리를 C 배열(`CoreTempModel.h`)과 JSON(`core_temp_model.json`)으로 내보냄.
- `model_version = mvp-temp-regression-1.0`.

### 9.2 학습 데이터 — 직접 확인 (`ai-training/raw-csv/`, CSV 3개)
| 항목 | 값 |
|---|---|
| 수집 | 2026-07-30 하루 약 7시간(UTC 03~10시), 원본 1,947행 → 정제 1,750행 |
| 샘플 | 245개(학습 196 / 검증 49), 연속 구간 209개 |
| 심부온도 | 중앙값 25.5℃, 범위 23.5~25.5℃(1행 85℃ 잡음). **실온** |
| 히터/팬/모터 | `heater_pwm_percent`·`fan_pwm_percent`·`motor_state` **전 행 NaN**, `heater_valid` 전 행 False |
| CO2 | `co2_valid` 전 행 False |
| DHT11 유효 | 1,049 / 1,947 (54%) |
| 소비전력 | 없음(INA219 제외) |

### 9.3 제어 판정 (`predict_service.py`) — 직접 확인
- 상수: 목표 **37.0℃**, 정상모드 ON 1.0℃ 아래·OFF 목표 도달, 저전력 모드 예측 조기 OFF 마진 0.2℃, 안전한계 42℃, 센서 stale 15초.
- 모드: `normal`(히스테리시스) / `low_power`(예측이 목표−0.2℃에 닿으면 조기 OFF, 예측 미준비 시 normal로 폴백).
- 급변 감지: 10초 창에서 ±2℃ 변화가 2회 확인되면 뜨거운/찬 투입으로 판정(쿨다운 20초). **dry-run 전용**, 릴레이에 적용 안 함.
- 안전 우선순위: 센서 무효/NaN·stale·과열이 항상 최우선.
- ESP32 측 재검증 상수: `MAX_SAFE_TEMPERATURE_C=42`, `MAX_CONTINUOUS_HEATING_SEC=300`, `MIN_RELAY_HOLD_SEC=10`, `COMMAND_STALE_SEC=20`. Pi 값과 수동 동기화 필요(코드 주석).
- 단위 테스트 3종(`test_heater_control.py`, `test_predict_service.py`, `test_rapid_change.py`): 예측값을 손으로 넣은 로직 테스트이며 **실제 하드웨어·모델 성능 검증이 아님**.

### 9.4 검증된 한계 (이 문서에서 가장 중요한 부분) — 2026-09-21 검증
1. **학습 분포와 제어 목표 불일치**: 학습은 실온(약 25℃), 제어 목표는 37℃. 히터 ON 데이터·음식물·미생물 투입 데이터가 0.
2. **예측 상한 31℃ 클립**: `pred_clip_high = 31.0`(학습 최대+2℃)이 `predict_service.py:181`에서 적용되어 **예측이 목표 37℃ −0.2℃에 도달할 수 없음** → 저전력 모드의 "예측 조기 OFF" 분기가 구조적으로 발동 불가.
3. **검증 수치의 의미(2026-09-21 재실행 검증)**: 검증 MAE 0.032℃는 재현되지만, 245개 샘플이 연속 구간 2개에서만 나왔고 검증 49개는 한 구간·정답 전부 25.5℃(표준편차 0)였다. "2분 뒤 = 지금 값" 기준선 MAE가 검증셋에서 0.000으로 **RF보다 좋다.** 구간 교차검증에서도 RF 0.30~0.44℃ vs 기준선 0.00~0.18℃로 **기준선이 항상 우세**. DS18B20이 9-bit라 0.5℃ 단위 출력(정답이 25.5·26.0 두 값뿐). **현 모델은 지금값 유지보다 나은 예측력이 없다.**
4. **레거시 권고 경로**: `control_recommendation`의 기준은 학습 데이터 중앙값(25.5℃)이라 실제 처리기와 무관한 데모 임계값.
5. **"온디바이스"와 구조 불일치**: 추론이 Pi에서 실행된다(ESP32 아님). 정확한 표현은 "엣지(Pi) 추론".
6. 최신 스냅샷 설정(MQ-137·릴레이 비활성)에서는 추론·제어 체인이 실제로 돌지 않을 가능성이 있음(§5 주의).

## 10. 모바일 앱 — microbe-app (Expo / React Native)  [소스 ZIP 미포함 — 아래는 이전 문서 기재, 재검증 안 함]

| 화면 | 상태 |
|---|---|
| 홈 | **[구현 완료]** mock 서버 5초 폴링. 캐릭터 카드·센서 카드·목표온도/절전모드 |
| 센서 상세 | **[부분구현]** 막대그래프, "LLM 진단" 카드 |
| 성과 | **[설계 완료 UI]** `SAVED_WH = 14200` 등 **하드코딩 상수** — 실제 절감 실적 아님 |
| 마이 | **[부분구현]** "TODO: 서버 fetch" 주석, 로컬 상태만 |
| 알림 | **[설계 완료]** placeholder |

- 캐릭터 4단계(happy/normal/sick/dead)는 센서별 구간 등급의 최악값을 쓰는 **규칙 기반**이며 AI와 미연결.
- 앱의 CO2·암모니아 수치는 **목업**(CO2는 하드웨어 제외, MQ는 raw ADC).
- 목표온도 설정 범위: mock 서버 기준 10~35℃ → 제어 목표 37℃와도 어긋남(직접 확인: `microbe-server/server.py`의 `ge=10, le=35`).

## 11. 시연 흐름 (현재 실제로 보여줄 수 있는 것)

1. ESP32 전원 → Wi-Fi → MQTT 1초 발행. 게이트웨이 대시보드 실시간 갱신·온라인/오프라인.
2. MQTT 단절 시 헬스체크 로그(nonce RTT, stale 감지, 재연결).
3. Pi에서 `predict_service.py`를 **수동 실행**하면 inference 토픽으로 예측·`heater_command`(dry-run) 확인 가능 — 단 §9.4 한계 명시 필수.
4. 앱은 별도 트랙(mock). 두 트랙 미연결.

## 12. 기대 효과
- **정량적 절감률은 실측되지 않았다.** 앱의 "이달 절감 14,200Wh"는 상수. 실측 전력 데이터 0건.
- 정성적: 추세를 읽어 과열·낭비를 사전 예방하는 구조, 비전문가용 캐릭터 UI.

## 13. 향후 계획 (우선순위 재정렬)
1. **실운전 데이터 수집**: 실제 목표 온도 대역(약 37℃)에서 히터 ON/OFF·뜨거운/찬 투입 데이터 6시간+, **다른 날 검증셋 분리**.
2. **기준선 비교**: 지금값 유지 / 히스테리시스만 / RF — 오버슈트와 소비전력 기준.
3. `pred_clip_high` 제거·재학습 후 예측이 목표 온도에 닿는지 확인.
4. **소비전력 실측**: INA219 정리 또는 USB/스마트플러그형 전력계로 대체, Wh 기록.
5. 릴레이 ON 극성 검증, 챔버(단열 용기+발열체+교반) 제작(`3d-model/` 폴더는 비어 있음).
6. MQ-137/138 재활성화·ppm 환산 또는 추세 경고로 한정, DHT11 유효율 개선.
7. `predict_service`를 systemd 유닛으로 배포에 편입, 게이트웨이 healthcheck 처리.
8. 앱 소스를 저장소에 포함하고 mock 서버를 게이트웨이 데이터로 교체, 성과·마이·알림 화면 서버 연동.
9. 민감정보 정리(`.env`의 Edge Impulse API 키 재발급, `secrets.h`).

## 14. 관련 문서
- 검증·보완 계획: `../08_project_adversarial.md`
- 선행제품 조사: `../08_prior_art_food_waste.md`
