yco252444-blip/gamja/md_files/03_부품_속도_신뢰성.md

# 검증: 부품 속도·신뢰성 (적대적 검토)

작성일 2026-09-21 / 대상: 미생물 음식물 처리기 센서 노드 (XIAO ESP32S3 + DS18B20 + DHT11 + MQ-137/138 + INA219 + 5V 릴레이 + Wi-Fi modem sleep)

## 0. 읽는 법

- **[직접]** = 원문 PDF/HTML을 내려받아 텍스트를 직접 추출해 확인한 값. 파일 열람 후 인용.
- **[2차]** = 검색결과 요약, 미러 사이트, 커뮤니티 글로만 확인. 원문 미열람.
- **[계산]** = 위 값으로 내가 계산한 값 (제조사 값 아님).
- **[미확인]** = 이번 조사에서 근거를 못 찾음.
- Reddit/X 커뮤니티: 크롤러 차단 이력이 있어 이번에는 조사하지 못함 [미확인]. 대신 Random Nerd Tutorials, Adafruit/Arduino 포럼, GitHub 이슈 등 검색요약만 [2차]로 사용.
- 검색 횟수: WebSearch 약 20회 + 원문 열람(WebFetch/curl) 약 20회. 검색은 25회 이내였고, 열람까지 합치면 초과. 소요 약 15분.

## 1. 발표 주장 4개 — 한눈에 판정

| 주장 | 판정 | 핵심 근거 |
|---|---|---|
| 히터 전류 수집 (INA219) | **DC 저전력 히터일 때만 성립. 히터가 AC 220V면 불가·위험** | INA219 핀 허용 -0.3~26V, 션트 ±320mV(0.1Ω → 3.2A) [직접] |
| VOC로 혐기성 부패 감지 (MQ-138) | **근거 부족** | MQ-138 대상가스는 톨루엔·아세톤·알코올·수소 [직접]. 부패 대표가스(H2S, 메틸머캅탄, NH3)는 대상 아님 |
| 0.1초 Fail-Safe | **센서 경로로는 성립 불가** | DS18B20 9bit 변환만 93.75 ms, DHT11 2초 주기, MQ는 초~분 단위 응답 [직접/일부 미확인]. Wi-Fi 경로는 DTIM 지연 |
| Modem-Sleep으로 180→35mA (75%) | **35mA 수준은 공식 표와 근접, 180mA는 근거 없음, 75%는 산수 오류** | Espressif 표: Modem-sleep 38~40 mA [직접]. (180-35)/180 = 80.6% [계산] |

## 2. DS18B20 (핵심온도)

출처 [직접]: Maxim/ADI DS18B20 데이터시트 REV 042208 (Adafruit 미러) https://cdn-shop.adafruit.com/datasheets/DS18B20.pdf (ADI 원본 URL은 다운로드 실패)

| 분해능 | 최대 변환시간 | 온도 단위 |
|---|---|---|
| 9-bit | 93.75 ms | 0.5 °C |
| 10-bit | 187.5 ms | 0.25 °C |
| 11-bit | 375 ms | 0.125 °C |
| 12-bit (전원 투입 기본값) | 750 ms | 0.0625 °C |

| 항목 | 내용 | 근거 |
|---|---|---|
| 동작속도 | Table 2 위 표. 변환 명령 후 최대시간 대기 필요. 외부전원 모드는 읽기 슬롯으로 완료 확인 가능, 기생전원은 불가(강한 풀업 필요) | [직접] |
| 정확도 | tERR ±0.5 °C(-10~+85 °C), ±2 °C(-55~+125 °C). 분해능별 정확도 구분은 표에 없음 | [직접] Electrical Char. |
| 9-bit 사용의 문제 | 9-bit면 온도 레지스터 bit 2,1,0이 "undefined" -> 0.5 °C 계단. 정확도 ±0.5 °C 스펙 위에 계단 양자화 최대 0.5 °C가 겹치므로 최악 편차 약 1 °C까지 가능 [계산/해석]. 히스테리시스 제어 폭을 0.5 °C 이하로 잡으면 의미 없음 | [직접]+[계산] |
| 85 °C 함정 | 온도 레지스터 전원 투입값이 +85 °C. 변환 완료 전에 읽으면 85.0이 나옴 -> 가열 제어에서 오검출(과열 오판/제어 오동작) | [직접] "power-on reset value ... +85°C" |
| 수명·열화 | 데이터시트 드리프트 각주: 125 °C, 5.5 V로 1000시간 스트레스 시험 기준 [직접]. 수치는 표 본문에서 확인 못 함 [미확인]. 절대최대 핀전압 -0.5~+6 V |
| 방수 프로브 신뢰성 | 데이터시트는 칩 기준. 프로브 케이블/실링(에폭시·수축튜브) 수명과 장기 습열·부패가스 내구성은 제조사별 상이 [미확인]. 위조/저가 칩 이슈 [미확인] |
| 이 프로젝트 문제점 | (1) 1 Hz 폴링 + 동기식(setWaitForConversion true) 시 9-bit도 93.75 ms, 12-bit면 750 ms를 루프가 막음(12-bit는 1초의 75%). DallasTemperature 라이브러리는 setWaitForConversion(false)로 비동기 가능하나 대기시간은 개발자 몫 [2차] https://github.com/Gbertaz/NonBlockingDallas 등. (2) 0.1초 Fail-Safe를 온도 읽기로 구현하는 것은 변환시간만으로도 사실상 불가(9-bit 93.75 ms는 이미 0.1초 근처). (3) 프로브 열 시정수(초~수십 초)는 미확인이나 핵심온도 응답이 0.1초 단위일 수 없음 |

## 3. DHT11 (공기 온습도)

출처 [직접]: Aosong DHT11 영문 데이터시트 (미러) https://www.electronicoscaldas.com/datasheet/DHT11_Aosong.pdf, components101 미러 https://components101.com/sites/default/files/component_datasheet/DHT11-Temperature-Sensor.pdf. Mouser 번역본은 접근 차단으로 미열람. Aosong 중문본은 텍스트가 깨져 일부만 확인.

| 항목 | 내용 | 근거 |
|---|---|---|
| 동작 범위 | 습도 20~90 %RH, 온도 0~50 °C | [직접] |
| 정확도 | 습도 ±5 %RH, 온도 ±2 °C. 분해능 1 %RH/1 °C. 반복성 ±2 %RH/±1 °C. 이력 ±1 %RH | [직접] |
| 최소 샘플 주기 | 영문본: 수집 주기 2초, "전체 과정 간격은 2초 초과". 즉 1 Hz 폴링은 스펙 위반. (일부 판본/판매처는 1 Hz라 적음 - 원문 확인 안 됨) | [직접] 영문본 |
| 응답시간 | components101 판본 습도 1/e(63%) 6~15 s (25 °C, 1 m/s), 판본에 따라 6~10 s | [직접, 판본차 있음] |
| 장기 안정성 | 영문본 ±1 %RH/년. components101 판본은 <±0.5 %RH/년 (판본 불일치) | [직접] |
| 수명·열화 | 범위 밖 사용 후 회복 가능하나 노화 가속. 화학물질 증기가 감도 저하. 결로(dew) 사용 회피. 부식성·산·알칼리 공기에 의한 손상은 보증 제외. 회복 절차: 50~60 °C, <10 %RH 2시간 후 20~30 °C, >70 %RH 5시간 | [직접] |
| ESP32 read 실패 | 흔한 원인: 2초 미만 폴링, 풀업 부재, 안테나 근처 배선의 RF 노이즈로 체크섬 오류, 핀 선택, 타이밍 위반 (NaN/timeout) | [2차] https://randomnerdtutorials.com/solved-dht11-dht22-failed-to-read-from-dht-sensor/ 및 https://zbotic.in/arduino-dht11-troubleshooting-fix-nan-and-timeout-errors/ |
| 이 프로젝트 문제점 | (1) 처리기 내부는 가열 + 고습 + 결로 + 암모니아(알칼리)/황화물 환경 -> 0~50 °C, 20~90 %RH, 결로·부식성 공기 회피 조건 모두와 충돌. (2) 1 Hz 폴링은 스펙(2 s) 위반이라 실패율 상승. (3) 정확도 ±5 %RH는 90 %RH 근처 포화 영역에서 의미 약함. (4) 응답 6~15 s라 "0.1초" 계열과 무관 |

## 4. MQ-137 / MQ-138 (그리고 대안)

출처 [직접] Winsen 매뉴얼:
- MQ-137 v1.6 https://www.winsen-sensor.com/d/files/mq137-(ver1_6)---manual.pdf
- MQ-138 v1.4 https://www.winsen-sensor.com/d/files/PDF/Semiconductor%20Gas%20Sensor/MQ138%20(Ver1.4)%20-%20Manual.pdf
- MQ-136 v1.6 https://www.winsen-sensor.com/d/files/mq136-(ver1_6)---manual.pdf

| 항목 | MQ-137 | MQ-138 | MQ-136 (참고) |
|---|---|---|---|
| 감지 대상 | NH3 (유기아민 트리메틸아민·콜라민도 감지 가능 명시) | 톨루엔, 아세톤, 알코올, 수소 (메탄올 및 기타 유기증기도 "감시 가능"). 벤젠·포름알데히드는 대상가스 목록에 없음(이 판본 기준) | H2S (황 유기증기도 "감시 가능") |
| 감지 범위 | 5~500 ppm | 5~500 ppm | 1~200 ppm |
| 히터 전압 | 5.0±0.1 V (AC/DC) | 5.0±0.1 V | 5.0±0.1 V |
| 히터 저항 / 소비전력 | 30±3 Ω / <=950 mW (약 190 mA @5V [계산]) | 29±3 Ω / <=900 mW (약 180 mA @5V [계산]) | 30±3 Ω / <=950 mW |
| 예열(Preheat) | **"Over 48 hours"** (표준 시험조건 행에 명시) | **"Over 48 hours"** | Over 48 hours |
| 장기 보관 후 재에이징 | 보관 <1개월 >=48 h, 1~6개월 >=72 h, >6개월 >=168 h (Caution 2.3) | 동일 | 동일 |
| 표준 시험조건 | 20 °C, 55 %RH, Vc 5 V, VH 5 V | 동일 | 동일 |
| 온습도 영향 | Fig.4에 온도(-10~50 °C)·습도(20~85 %RH)별 Rs/Rs0 곡선. 축 눈금상 0.6~1.8배 스윙(그래프 눈금 기반 근사) [직접, 근사] | Fig.4 동일 성격 | 동일 |
| 교차감도 | 정량 표 없음 [미확인] | 정량 표 없음. 그림상 알코올·아세톤·톨루엔 곡선만 | 정량 표 없음 |
| 응답/회복 시간 | Fig.6 곡선만, 수치 표기 없음 [미확인] | 동일 | 동일 |
| 수명 | "long lifespan"이라 하나 수치 없음 [미확인] | 동일 | 동일 |
| 금지 조건 | 유기실리콘 증기(영구 감도 상실), 고농도 부식성 가스(**H2S, SOx, Cl2, HCl**)로 부식·감도저하, 알칼리·염분·할로겐, 물 접촉·결로, 결빙, 고농도 장기 노출 | 동일 | 동일 |

MQ 예열 결론:
- 제조사 문서는 **48시간 이상**을 요구. 커뮤니티의 "24시간"은 제조사 기준이 아님.
- 신품 또는 장기 보관 모듈은 최대 168시간 에이징 권고.
- 시제품 발표 전 시간 확보 없이 켜자마자 ppm 판독은 근거 없음.
- 매뉴얼은 Rs/R0 상대 판독 구조. 절대 ppm 보증 없음.
- 일반 MQ 계열의 선택성 부족·온습도·노화 민감성은 2차 자료도 동일 [2차] (요약 검색 결과, 원문 미열람).

### '혐기성 부패 = VOC 급증' 성립 여부 (MQ-138)

- 음식물 혐기 부패의 대표 악취: NH3, H2S, 메틸머캅탄, 디메틸설파이드/디설파이드 등 [2차]. 검색요약 출처 https://www.tandfonline.com/doi/full/10.1080/10962247.2013.807318 (직접 접근 403). 보조: https://www.sciencedirect.com/science/article/abs/pii/S0959652624009715
- MQ-138의 대상은 톨루엔·아세톤·알코올·수소. **H2S·머캅탄·NH3는 대상 아님.** 에탄올·아세톤 같은 발효 부산물에는 반응하겠지만 "혐기 vs 호기" 구분 능력 근거는 없음. 세척제·알코올·조리 증기에도 교차반응.
- 따라서 "MQ-138 VOC 급증 = 혐기성 부패"는 **직접 근거 없음.** 표현을 "휘발성 유기증기 상대지표(비특이적)" 수준으로 낮추는 것이 안전.
- 더 논리적인 조합: NH3는 MQ-137(또는 전기화학 NH3), 황화물은 MQ-136(또는 전기화학 H2S). 단, MQ-137/136도 교차감도 정량 자료가 없음.

### 대안 센서 비교

| 센서 | 대상 | 범위 | 분해능 | T90 | 수명 | 근거 |
|---|---|---|---|---|---|---|
| ME3-NH3 (전기화학) | NH3 | 0~100 ppm (최대 200) | 0.5 ppm | <=60 s | 2년 (2 ppm NH3 기준) | [직접] https://www.winsen-sensor.com/d/files/me3-nh3-0-100ppm(ver1_3)-manual.pdf |
| ME3-H2S (전기화학) | H2S | 0~100 ppm (최대 500) | 0.1 ppm | <30 s | 2년 (공기 중) | [직접] https://www.winsen-sensor.com/d/files/PDF/Electrochemical%20Gas%20Sensor/4-series%20Electrochemical/ME3-H2S%200-100ppm(ver1.2)%20Manual.pdf |

- ME3-NH3는 H2S 50 ppm에 NH3 환산 25 ppm 반응(교차) [직접]. ME3-H2S는 NH3 50 ppm에 -0.3 ppm [직접].
- 보관 온도 -20~50 °C, 습도 15~90 %RH [직접]. 고온 배기에는 샘플링 배관/냉각 필요 [해석].
- 전기화학 센서는 MQ와 달리 히터 불필요(전력·예열 이점). 다만 출력이 nA~uA급이라 별도 TIA/전용 AFE 필요 [해석]. 표준 소형 AFE 부품 자료는 이번에 미조사 [미확인].

### 5V AO -> 3.3V ADC 직결 위험

- ESP32-S3 입력 High 최대 VDD+0.3 V (3.3 V 기준 3.6 V), 절대 최대 입력 전압 0.3~3.6 V [직접] ESP32-S3 Datasheet v2.2 Table 5-1, 5-4 https://www.espressif.com/sites/default/files/documentation/esp32-s3_datasheet_en.pdf
- MQ 모듈 AO는 Vc(5 V) 근처까지 상승 가능 [해석]. 직결 시 ESD 다이오드 통전 -> 핀·ADC 손상 위험. 분압(예: 상단 10k/하단 12k, 최대 약 2.7 V) + 100 nF 필터 권장 [계산].
- ADC 11 dB 감쇠의 유효 범위가 0~2.9 V이므로 (아래 5절) 분압비는 이 값 이하로.
- 히터 5 V 2개(MQ-137+MQ-138) 합계 최대 약 1.85 W, 370 mA [계산: 950+900 mW]. 아래 8절 비교 참고.

## 5. ESP32-S3 ADC / XIAO ESP32S3 핀

출처 [직접]: ESP32-S3 Datasheet v2.2 Table 5-5, 5-6; ESP-IDF ADC 문서 https://docs.espressif.com/projects/esp-idf/en/latest/esp32s3/api-reference/peripherals/adc/adc_oneshot.html ; 교정 문서 https://docs.espressif.com/projects/esp-idf/en/latest/esp32s3/api-reference/peripherals/adc/adc_calibration.html ; Seeed 위키 https://wiki.seeedstudio.com/xiao_esp32s3_getting_started/

| 항목 | 내용 | 근거 |
|---|---|---|
| 비선형 | DNL ±4 LSB, INL ±8 LSB (12-bit), 최대 100 kSPS. 측정조건: 100 nF 외장 커패시터, **Wi-Fi 비활성**, 25 °C. 각주: 다중 샘플 평균 권장 | [직접] |
| 감쇠별 유효 범위·교정 후 총오차 | ATTEN0 0~850 mV ±5 mV, ATTEN1 0~1100 mV ±6 mV, ATTEN2 0~1600 mV ±10 mV, **ATTEN3(11~12 dB) 0~2900 mV ±50 mV** | [직접] Table 5-6 |
| 기준전압 | 1100 mV (칩마다 1000~1200 mV) | [직접] ESP-IDF 교정 문서 |
| 노이즈 | Wi-Fi 동작 중 노이즈는 데이터시트 측정조건에서 제외됨. 정량 값 [미확인] | [직접, 부재 확인] |
| ADC2 + Wi-Fi | "ADC2 is also used by Wi-Fi", adc_oneshot_read()가 충돌을 보호(공유 시 대기/실패 가능) | [직접] ESP-IDF |
| XIAO 핀 매핑 | D0~D3 = GPIO1~4(아날로그), D4=GPIO5(SDA), D5=GPIO6(SCL), D6=GPIO43(TX), D7=GPIO44(RX), D8~D10=GPIO7~9(SPI). GPIO41/42는 A11/A12로 표기되나 ADC 미지원. 스트래핑 핀 GPIO0/45/46 주의. 3.3 V 로직 | [직접] Seeed 위키 |
| ADC1/ADC2 구분 | S3에서 GPIO1~10=ADC1, GPIO11~20=ADC2로 알고 있으나 이번에 원문 확인 못 함 [미확인, TRM 확인 필요]. 이 경우 D0~D5, D8~D10은 ADC1이라 Wi-Fi 충돌 없음(추정) | [미확인] |
| 이 프로젝트 문제점 | (1) 11 dB 구간 ±50 mV 오차는 MQ AO 상대지표엔 충분하나 ppm 절대판독엔 부족. (2) D4/D5는 I2C(INA219)로 쓰이므로 MQ 2개는 D0~D3에서 선택. (3) ADC2 핀(GPIO11~20)은 XIAO 헤더에 없어 Wi-Fi 충돌은 피하기 쉬움(단, 미확인 사항 위) |

## 6. INA219

출처 [직접]: TI INA219 SBOS448G https://www.ti.com/lit/ds/symlink/ina219.pdf ; Adafruit 브레이크아웃 설명 [2차] https://learn.adafruit.com/adafruit-ina219-current-sensor-breakout/overview

| 항목 | 내용 | 근거 |
|---|---|---|
| 버스 전압 | 핀 전압 -0.3~26 V 초과 금지. BRNG=1(32 V 범위)도 각주에 "In no event should more than 26 V be applied" | [직접] |
| 션트 풀스케일 | PGA /1 ±40, /2 ±80, /4 ±160, /8 ±320 mV | [직접] |
| 최대 전류 (0.1 Ω) | 320 mV / 0.1 Ω = **3.2 A** [계산]. 제조사 브레이크아웃도 ±3.2 A 표기 [2차]. 션트 발열 3.2² x 0.1 = 약 1.0 W [계산] | 일치 |
| 분해능 | 12-bit, 션트 10 uV/LSB, 버스 4 mV/LSB. 0.1 Ω 3.2 A 범위에서 약 0.8 mA/LSB [2차] | [직접]/[2차] |
| 정확도 | 전류 측정 오차 ±0.2 %(typ), ±0.5 %(max, 25 °C), 전 온도 ±1 %(INA219A) | [직접] Electrical Char. |
| 변환 시간 | 12-bit 532 us. 평균 128회 68.10 ms | [직접] Table 5 |
| AC 측정 | 핀 허용 -0.3~26 V, 단방향 DC 버스 전압 측정 구조 [해석]. **AC 220 V 라인(실효 220 V, 피크 약 311 V)에는 직접 연결 불가.** 절연도 없음 -> 감전·소손 위험 | [직접]+[해석] |
| 이 프로젝트 문제점 | (1) 히터가 AC 220 V면 INA219로 "히터 전류 수집" 주장 자체가 성립 안 함. (2) DC 히터라도 최대 3.2 A: 24 V이면 약 77 W, 12 V이면 약 38 W가 한계 [계산]. "수십~수백 W" 히터는 대부분 초과. (3) 1 Hz 샘플이 SSR 위상제어/PWM이면 앨리어싱 [해석] |

### AC 220 V 히터 전류/전력 측정 대안

| 방식 | 정확도·특성 | 안전·주의 | 근거 |
|---|---|---|---|
| PZEM-004T v3 | 전압 80~260 V, 전류 0~10 A(내장 션트) 또는 0~100 A(외부 CT), 전력 0~2.3 kW/23 kW, 정확도 0.5 %, 전류 분해능 1 mA, 시동 전류 10 mA(10A형)/20 mA(100A형) | UART(TTL)이나 모듈 출력 절연 여부 설명은 이번 문서에서 확인 못 함 [미확인]. 10A형은 라인에 직렬 결선 필요 | [직접] https://innovatorsguru.com/wp-content/uploads/2019/06/PZEM-004T-V3.0-Datasheet-User-Manual.pdf |
| HLW8012 / BL0937 | CF(전력) 0.2 %@1000:1, CF1(전류/전압 RMS) 0.5 %@500:1, 5 V 공급, <3 mA. 교정 필요 | Sonoff POW 등 일부 기기는 디지털 GND가 **메인 전위**라 GPIO에 감전 위험 | [2차] https://esphome.io/components/sensor/hlw8012/ , https://tinkerman.cat/post/hlw8012-ic-new-sonoff-pow/ |
| CSE7766 | HLW8012 후속(UART, 스마트플러그 S31/POW R2 사용) | 동일하게 비절연 구조 주의 | [2차] https://itead.cc/sonoff/product-tutorials/sonoff-s31-a-world-apart/ |
| ACS712 (Allegro) | 총 출력 오차 ±1.5 % (25 °C), 대역폭 80 kHz, 절연 2.4 kVrms, 5 V 공급, 감도 66~185 mV/A(5A형 185 mV/A). AC/DC 겸용 | 5A형 185 mV/A에서 ESP32 ATTEN3 오차 ±50 mV는 약 ±0.27 A에 해당 [계산]. 출력 중점 2.5 V로 5 A형 ±0.93 V 스윙 = 1.6~3.4 V이며 ADC 유효 2.9 V 초과 -> 분압 필요. 기본 절연 작동전압 297 Vrms | [직접] https://www.allegromicro.com/-/media/files/datasheets/acs712-datasheet.pdf |
| CT 센서(비침투) | 라인 무접촉, 절연 좋음 | 부담저항·바이어스 회로 필요. 이번에 정량 미조사 | [미확인] |

정리: AC 220 V 히터라면 **절연 + 인증품(PZEM 등 모듈 또는 CT)** 이 시제품 최소선. HLW8012/CSE7766를 스마트플러그 회로 그대로 쓰려면 비절연 구조를 이해해야 함.

## 7. 5V 릴레이 모듈 (SRD-05VDC-SL-C 계열)

출처 [직접]: Songle SRD 데이터시트 (circuitbasics 미러) https://www.circuitbasics.com/wp-content/uploads/2015/11/SRD-05VDC-SL-C-Datasheet.pdf

| 항목 | 내용 | 근거 |
|---|---|---|
| 코일 | 5 VDC 감도형: 71.4 mA, 70 Ω, 약 0.36 W. 풀인 <=75 %, 드롭아웃 >=10 % | [직접] |
| 동작/복귀 시간 | 동작 10 ms max, 복귀 5 ms max | [직접] |
| 접점 정격 | Form C 열: 7 A 28 VDC, 10 A 125 VAC, 7 A 240 VAC(저항성). 유도부하 Form C 3 A 120 VAC/28 VDC. 접점재 AgCdO. Form A 열은 10 A 240 VAC. 모듈 실크의 "10A 250VAC"는 Form A 값으로 보이므로 SL-C(Form C)는 더 낮게 볼 것 | [직접] |
| 수명 | 기계 10^7회(무부하), **전기 10^5회(정격부하)** | [직접] |
| 수명 계산 | 히터 온/오프를 30초마다 하면 하루 2880회 -> 10^5회까지 약 35일 [계산]. 5분마다 하면 약 347일 [계산] | [계산] |
| 3.3 V 로직 구동 | 옵토커플러 모듈은 3.3 V로 대부분 구동 가능하나, active-low 모듈은 **부팅 중 GPIO 글리치로 릴레이가 순간 ON** 되는 사례 다수. 스트래핑 핀 사용 회피, 모듈 VCC와 JD-VCC 분리 [2차] https://www.universal-solder.ca/troubleshooting-esp32-relay-problems/ , https://randomnerdtutorials.com/esp32-relay-module-ac-web-server/ | [2차] |
| 이 프로젝트 문제점 | (1) 부팅·리셋·Wi-Fi 끊김 시 히터가 ON으로 남거나 튀는 Fail-Safe 상태 미정의. (2) 히터 부하 유도성/램프 돌입전류·접점 용착(용착 시 릴레이가 OFF 안 됨) -> 소프트웨어 Fail-Safe로는 못 끔. (3) 릴레이 코일 71 mA x 5 V = 0.36 W를 5 V 레일에서 추가 소모 |

### 220 V 히터에는 SSR(영전압 스위칭) 권장 근거

- 영전압(zero-cross) SSR은 저항성 히터에서 돌입·EMI가 적고 접점 마모가 없음. 단, 오프 상태 누설(예: Omron G3NA 10 mA로 요약 보도) 및 방열판·디레이팅(30 %) 필요 [2차] https://assets.omron.com/m/453bbd7a38a218b5/original/G3NA-Series-Solid-State-Relay-Datasheet.pdf (원문 미열람, 검색요약).
- SSR 단락 고장(ON 고착)도 가능하므로 과열차단(바이메탈/써멀퓨즈)은 별도 독립 하드웨어로.

### 안전 규정 한 줄

- 전기용품 및 생활용품 안전관리법상 안전인증·안전확인·공급자적합성확인(KC)이 있으며 연구개발·시험용은 면제 근거가 있으나 판매·설치·전시 이외 사용 시 인증 검토 필요 [2차] https://www.kats.go.kr/content.do?cmsid=44 , https://www.kats.go.kr/content.do?cmsid=45 (검색요약, 면제 세부요건 원문 미열람).

## 8. ESP32 Wi-Fi modem sleep 전류 검증

출처 [직접]: ESP32-S3 Datasheet v2.2 Table 5-7, 5-9, 5-10; ESP-IDF 저전력 가이드 https://docs.espressif.com/projects/esp-idf/en/latest/esp32s3/api-guides/low-power-mode/low-power-mode-wifi.html (raw HTML의 표를 직접 확인; MIN/MAX_MODEM 설명 문장은 WebFetch 요약 [2차]); ESP-IDF esp_wifi 문서 https://docs.espressif.com/projects/esp-idf/en/latest/esp32s3/api-reference/network/esp_wifi.html ("Default power save type is WIFI_PS_MIN_MODEM")

### 공식 값

| 조건 | 전류 | 근거 |
|---|---|---|
| Wi-Fi 활성 TX (802.11b 1 Mbps @21 dBm) | 피크 340 mA | Table 5-7 [직접] |
| TX 802.11g 54 Mbps @19 dBm ~ n HT40 | 피크 283~291 mA | Table 5-7 [직접] |
| RX(수신 대기) 802.11b/g/n HT20 / HT40 | 88 / 91 mA | Table 5-7 [직접] |
| Modem-sleep, CPU 상태별 (40~240 MHz, 주변장치 클럭 끔/켬) | 13.2~107.9 mA (240 MHz 이중코어 128-bit 실행 최대) | Table 5-9 [직접] |
| 가이드 표 평균, Modem-sleep(DFS 없음) DTIM1/3/10 | 40.1 / 38.7 / 38.2 mA | 저전력 가이드 표 [직접] |
| Modem-sleep + DFS DTIM1/3/10 | 20.7 / 19.9 / 19.5 mA | 동일 [직접] |
| Auto Light-sleep DTIM1/3/10 | 2.45 / 1.33 / 0.93 mA | 동일 [직접] |
| Deep-sleep | 6.8 uA (가이드) / 7 uA (데이터시트) | 동일 [직접] |

가이드 표는 "평균 전류, 차폐 박스 측정". 해당 측정 개발보드/조건 상세는 미확인. 

### 발표 수치 대조

| 발표 수치 | 판정 |
|---|---|
| 180 -> 35 mA | 35 mA는 공식 Modem-sleep 평균(38~40 mA, DFS 없음)과 근접. **180 mA에 해당하는 공식 평균값은 없음**(RX 88 mA, TX 피크 283~340 mA). 180은 개발보드+주변장치 합 또는 ps 끈 실측일 수 있으나 근거 미확인. ESP-IDF는 **기본이 이미 WIFI_PS_MIN_MODEM** [직접]이라 "modem sleep을 켜서 개선"이라는 서술은 기본값 대비로는 성립하지 않을 수 있음(Arduino 기본값 미확인) |
| (75%) 절감 | (180-35)/180 = **80.6 %** [계산]. 35/180 = 19.4 %. 75 %는 산수 불일치. 75 %가 맞으려면 140 -> 35 mA |
| 100~240 -> 15~30 mA | 15~30 mA는 Modem-sleep(+DFS) 19.5~20.7, 저전력 CPU 상태 13~28 mA 대역과 부합. 100~240 mA "전"은 Wi-Fi 상시 활성 TX 피크 340/RX 88 사이이므로 조건 명시 필요. 절감률: 100->15 = 85 %, 240->30 = 87.5 % [계산] |
| 1 Hz MQTT 전송 시 | 초당 TX 버스트(수십 ms, 200~340 mA급) 때문에 평균은 idle modem-sleep 값보다 높음 [해석, 실측 필요] |

### DTIM과 MQTT 제어 명령 지연

- Modem-sleep은 비콘/DTIM 주기로 깨어나 수신 [2차, WebFetch 요약]. MIN_MODEM은 AP의 DTIM 주기를 따름, MAX_MODEM은 더 긴 listen interval 사용, 대가로 지연 증가 [2차]. "DTIM 10이면 대략 1초 지연" [2차, 비콘 100 TU 가정].
- 즉 서버 -> 노드 명령(MQTT 구독 수신)은 DTIM 주기만큼 큐잉될 수 있음. 히터 OFF 명령이 0.1초 안에 도달한다는 보장은 없음 [해석]. 0.1초 Fail-Safe는 **원격 명령 경로로 구현 불가**, 노드 내부 로컬 하드웨어/펌웨어 인터록(과열 임계 시 즉시 릴레이 OFF, 워치독, 통신 두절 시 OFF)로만 성립.
- 노드가 1 Hz로 MQTT publish(송신)하는 것은 지연이 문제되지 않으나, 수신 명령은 지연됨.

### 절감이 히터 대비 몇 %인가

가정: ESP32 0.5 W(발표 기준) 중 modem-sleep 절감분 = (180-35) mA x 3.3 V = 0.48 W [계산]. 

| 히터 전력 | 절감분 0.48 W / 히터 |
|---|---|
| 50 W | 0.96 % |
| 100 W | 0.48 % |
| 300 W | 0.16 % |
| 500 W | 0.10 % |

- 참고: MQ-137 + MQ-138 히터만 최대 약 1.85 W(950+900 mW)로 modem-sleep 절감(0.48 W)의 약 3.9배 [계산]. 릴레이 코일 0.36 W, 미터링·센서 별도. 노드 전체 소비전력 대비로도 Wi-Fi 절감의 비중은 작고, 전체 전력 최적화는 MQ 히터 듀티(예: 간헐 가열)가 훨씬 큼 [해석]. 단, MQ는 예열 48 h 요구와 상충하므로 듀티 사이클링 시 안정성 재검증 필요.
- 결론: "75 % 절감"은 ESP32 칩 단독 기준이고 처리기 시스템 전력으로는 1 % 미만. 발표에서 "배터리/저전력"이 아닌 "AC 전원 처리기"라면 이 절감을 강점으로 내세우기 어려움.

## 9. 상충·미확인 목록 (교차확인 필요)

1. DHT11 최소 주기: 영문 Aosong 본은 2 s [직접]. 일부 판본/판매처 1 Hz 표기 확인 못 함. Mouser 번역본은 접근 차단으로 미열람.
2. DHT11 장기 안정성 판본 불일치 (±1 vs <±0.5 %RH/년).
3. DS18B20 드리프트 수치, 방수 프로브 실링 신뢰성, 위조 칩 비율.
4. MQ 계열 응답/회복 시간(초·분), 교차감도 표, 수명 수치: 매뉴얼에 도표만 있고 수치 없음.
5. ESP32-S3 GPIO1~10 = ADC1 여부 (TRM 미열람).
6. Wi-Fi 동작 중 ADC 노이즈 정량값.
7. Arduino-ESP32의 기본 Wi-Fi 절전 설정, 180 mA의 측정 조건.
8. 릴레이 SL-C의 정확한 Form C 접점 정격 재확인 필요 (미러 PDF의 표 레이아웃이 뒤섞임).
9. HLW8012/CSE7766/Omron G3NA는 검색요약만, 원문 데이터시트 미열람.
10. KC 면제 요건 세부.
11. Reddit/X 커뮤니티 여론 [미확인].

## 10. 발표용 권고 문구 (수정안)

- "히터 전류 수집" -> "DC 라인 전류(INA219, 최대 3.2 A)를 측정. AC 히터는 절연형 계측 모듈로 대체 예정".
- "VOC로 혐기성 부패 감지" -> "MQ-138은 알코올·톨루엔·아세톤 등 비특이적 지표. NH3(MQ-137)와 함께 상대 변화만 사용. H2S 센서 추가 검토".
- "0.1초 Fail-Safe" -> "노드 내부 로컬 인터록으로 임계 초과 시 즉시 차단. 원격 명령은 DTIM 지연 있음".
- "Modem-Sleep 180->35mA(75%)" -> "modem-sleep 평균 약 40 mA(Espressif 표), ESP32 칩 기준. 처리기 히터 대비 1 % 미만".
