yco252444-blip/gamja/md_files/04_보드_전원_안전.md

# 검증: 보드 · 전원 · 안전 설계 (미생물 음식물 처리기 시제품)

작성 2026-09-21. 검색 25회 이내. git 금지 디렉터리.

**출처 표기 규칙**
- [직접] = 이 세션에서 원문(PDF/웹페이지)을 열어 텍스트로 확인
- [2차] = 검색 결과 요약/스니펫만 봄(원문 미열람). 숫자는 참고용, 발표 전 재확인 필요
- [코드] = 프로젝트 소스 직접 열람
- [가정] = 근거 없이 설계상 놓은 값
- 미확인 = 이번에 근거를 못 찾음

---

## 0. 핵심 결론 (먼저 읽기)

1. **Pi는 안전 제어에 필요 없다. ESP32 단독 온디바이스 제어로 충분하다.** 근거: (a) 이미 `CoreTempModel.h`(12 tree, 노드 약 17개/트리)와 `CoreTempRegressionEngine.cpp`가 ESP32 펌웨어 폴더에 있다 [코드]. (b) 13특징 RF 추론은 1Hz 데이터에서 10초마다 한 번 돌리는 수준이라 ESP32-S3에 부담이 없다 [코드: SLIDING_INFERENCE_STRIDE=10]. (c) ESP32는 이미 Pi 명령을 믿지 않고 자체 재검증한다 [코드]. Pi는 "대시보드/로그/설정값 제공자"로 격하시키고, 끊겨도 제어 판정은 ESP32가 계속하게 만드는 것을 권고한다.
2. **현재 구조의 실제 위험은 "네트워크 끊김 때 위험해짐"이 아니라 "네트워크 끊김 때 기능이 죽음 + MCU 자체가 멈출 때 릴레이가 켜진 채 남을 수 있음"이다.** 코드는 fail-safe 방향(끊기면 OFF)으로 잘 되어 있다. 대신 (i) 하드웨어 워치독이 없고(`esp_task_wdt` grep 0건) (ii) 독립 하드웨어 과온 차단이 없다. 이 둘이 안전 측면의 진짜 구멍이다.
3. **히터는 AC 220V 직결보다 12V DC 실리콘 히터 패드(수십 W) + 열퓨즈/바이메탈이 20시간 제작·전시장 반입 모두에 유리하다.** 전시장은 전열기구를 제한하고 사전 허가·안전 스위치를 요구하는 사례가 있다(KES 사례 [2차], GIST 규정은 미확인).
4. **RF 예측(60초 창 -> 120초 뒤)은 지금 학습 조건에서는 "제어에 기여한다"고 주장하기 어렵다.** 학습 데이터가 실온 7시간·245샘플이고 예측값을 22~31°C로 clip한다 [코드]. 히터를 켜는 실제 구간(목표 37°C)은 학습 분포 밖이라 RF는 외삽하지 못한다(트리는 학습 때 본 leaf 값만 낸다 — 코드 주석 자체가 이 점을 언급 [코드]). 발표에서는 "예측 기반 조기 OFF"를 데모 가능한 실온 시나리오(목표 25.5°C)로 한정하거나, 지속(persistence)/선형 외삽 기준선과의 비교를 같이 제시해야 방어된다.
5. **시연은 전용 공유기(2.4GHz 고정 채널, 오프라인 LAN) + ESP32 단독 제어 + 사전 녹화 영상 + 예비 보드**로 이중화한다. 프로젝트 코드 주석에 phone hotspot·modem-sleep에서 MQTT stale이 재현됐다고 이미 적혀 있다 [코드].

---

## 1. 보드 선택 비교

### 1-1. 워크로드 정의 (프로젝트 소스 근거) [코드]
센서 DS18B20 / DHT11 / MQ-137 / MQ-138 / INA219(운영 코드 미통합), 릴레이 1개(D8/GPIO7), 샘플 1Hz, 창 60 샘플, 추론 10초 간격, 13특징 RF(12 tree). CO2 센서는 제외됨. 모터/팬 제어는 헤더에 "implemented=false" 상태.

### 1-2. 비교표

| 후보 | 가격 (국내 가능하면) | 소비전력 | 실시간성 | 부팅·복구 | 개발 난이도 | 20h 제작 적합성 | 판정 |
|---|---|---|---|---|---|---|---|
| **XIAO ESP32S3 단독** | 해외 소매 약 EUR 7.96 [2차 eBay 스니펫]; 디바이스마트 상품 페이지 존재(가격 미확인) https://www.devicemart.co.kr/goods/view?no=14981265 | Wi-Fi TX 피크 340mA(802.11b 21dBm), 802.11n MCS7 283mA, RX 88~91mA [직접, 칩 단위 3.3V] https://documentation.espressif.com/esp32-s3_datasheet_en.pdf | 베어메탈 루프/FreeRTOS, 릴레이 판정 지연 ms 수준 [가정] | 전원 인가 후 수 초 내 setup() 진입, OS 없음, 파일시스템 손상 위험 낮음 [가정] | 이미 구현됨 [코드] | **최고**(이미 동작 코드 보유) | **채택 권고(제어 주체)** |
| ESP32-S3 + Pi 4 | Pi 4 가격 미확인 | Pi 4 정격 5V/3A [직접] https://www.raspberrypi.com/documentation/computers/raspberry-pi.html ; 유휴 약 275mA, 부하 약 1.3A(주변기기 포함) [2차] https://raspberry.tips/en/raspberrypi-tutorials/raspberry-pi-power-consumption-update-2026-all-models-compared | Linux 비실시간(제어에는 부적합, 관찰용) | SD카드 손상 위험, 부팅 30초~수 분 [가정] | 중(mosquitto+Node+Python 3개 서비스 운영) | 이미 만들어져 있어 "유지 비용"만 발생 | 게이트웨이/대시보드 용도로만 |
| ESP32-S3 + Pi 5 | 국내 4GB 스니펫 98,450~198,000원으로 상이 [2차] https://www.icbanq.com/P015956549 (가격은 직접 확인 필요) | 정격 5V/5A(25W) 또는 5V/3A + 주변기기 600mA 제한 [직접] 위 공식문서; 유휴 약 500mA, 부하 약 2.15A [2차] | 동일 | 동일 | 동일 | 과잉 사양. 전원 요건만 커짐 | **비권고**(이 워크로드엔 과잉) |
| ESP32-S3 + Pi Zero 2 W | 미확인 | 공식 12.5W 마이크로USB PSU 권장 [직접] https://www.raspberrypi.com/products/raspberry-pi-zero-2-w/ ; 소비전력 수치 미확인 | Linux 비실시간 | SD카드 | 중 | RAM 512MB로 mosquitto+Node는 가능하나 여유 적음 [가정] | Pi가 필요하다면 대체 후보 |
| **Arduino UNO Q** | 국내 4GB 92,000원 [2차] https://www.icbanq.com/P017086271 ; 유럽 EUR 39는 리뷰 언급(엔트리) [2차] https://www.tomshardware.com/raspberry-pi/arduino-uno-q-review | 미확인(공식 문서에 명시 없음 [직접]) https://docs.arduino.cc/hardware/uno-q | STM32U585 Cortex-M33 160MHz가 Zephyr로 실시간 처리 [직접] | MPU는 Debian Linux(eMMC 16GB [2차]); 공식 문서에 안전 종료 지침 없음 [직접] | 높음(App Lab, MPU-MCU Bridge 학습 필요) [가정] | 신규 플랫폼. 20시간 내 학습 비용 리스크 | 흥미로우나 **비권고**(위험 대비 이득 없음) |
| **Arduino UNO R4 WiFi** | 미확인 | VIN 6~24V, RA4M1 5V/ESP32-S3 3.3V [2차] https://docs.arduino.cc/resources/datasheets/ABX00087-datasheet.pdf | RA4M1 48MHz Cortex-M4 | Arduino 계열, OS 없음 | 낮음 | ESP32-S3가 Wi-Fi 전용이라 현 코드를 이식해야 함 | 이식 비용만 발생 |
| **Pico 2 W** | $7 [2차] https://www.raspberrypi.com/news/raspberry-pi-pico-2-w-on-sale-now/ | Wi-Fi 송신 시 150mA 초과 스파이크 [2차] | RP2350 듀얼코어 | OS 없음 | 낮음 | 현 코드(ESP32) 전체 이식 필요, ADC/센서 라이브러리 재검증 | 비권고 |
| **Jetson Orin Nano Super** | $249 [2차] https://jetsonhacks.com/2024/12/17/jetson-orin-nano-super-developer-kit/ | 15W/25W 모드 [2차]; 7W는 미확인 | Linux 비실시간 | 부팅 느림 | 높음 | 12 tree RF에는 과잉 | **명백히 부적합** |

메모: 국내 가격은 모두 검색 스니펫 수준이라 발표 전 실제 결제 페이지에서 재확인해야 한다. 디바이스마트 상품 페이지는 WebFetch로 가격이 추출되지 않았다(미확인).

### 1-3. "Pi가 필요한가?" 결론
- 필요하지 않다. 온디바이스로 옮기는 데 남은 작업은 (1) 추론 결과를 ESP32 내부에서 바로 `determineSafeHeaterOn()`에 연결하고 (2) 히스테리시스+예측 조기 OFF 규칙을 C++로 옮기는 것뿐이다. 판정 규칙은 임계값 비교 몇 개라서 소스 몇십 줄 수준이다 [가정].
- Pi를 남기는 정당한 이유는 "대시보드/로그/시각화/발표용 백엔드"뿐이다. 이 경우 Pi가 죽어도 ESP32는 자체 판정으로 계속 동작(또는 안전 OFF 유지)하도록 역할을 분리한다.
- 대안: 대시보드는 팀원 노트북에서 mosquitto+Node를 돌려도 된다(Pi의 SD 카드·전원·언더볼트 리스크 제거). 이 경우 Pi 섹션(2장)의 리스크가 통째로 사라진다.

### 1-4. 안전 제어를 네트워크 너머에 두는 구조의 위험 (현 구조 적대적 분석)

| # | 위험 | 현 코드 상태 [코드] | 평가 |
|---|---|---|---|
| a | Wi-Fi 끊김/AP 재시작 | `!mqttClient.connected() \|\| mqttRecoveryInProgress` -> OFF | fail-safe 방향 맞음. 대신 데모 중 히터가 꺼져 기능이 죽음 |
| b | 명령 stale | COMMAND_STALE_SEC=20, 추론 주기 10초 | 1개 손실은 견디나 연속 2개(QoS0에서 흔함) 손실이면 OFF. 히터 ON/OFF가 요동칠 수 있음 |
| c | 메시지 지연(신선도 오판) | `lastInferenceRxMs`로 수신 시각만 봄 | 메시지 내용의 생성 시각이 아니라 수신 시각이라, 브로커에 쌓였다가 몰려오는 옛 명령을 신선하다고 오판할 수 있음(확인 필요) |
| d | Pi 서비스 크래시 | 20초 stale로 OFF | 안전 OK |
| e | ESP32 자체 hang(무한루프/WDT 없음) | `esp_task_wdt` 0건 | **위험**: 릴레이가 마지막 상태를 유지하면 가열 지속 |
| f | 센서 탈락/오독 | `core_temperature_valid`, NaN 검사 | DS18B20의 전원 인가 직후 기본값 85°C, 오류값 -127°C 처리 여부는 코드에서 확인하지 못함(데이터시트 미열람이라 [가정]) |
| g | 릴레이 접점 융착 | 감지 수단 없음. INA219 운영 코드 미통합 [코드] | **위험**: SW OFF여도 히터 켜진 채 |
| h | 연속 가열 제한 | MAX_CONTINUOUS_HEATING_SEC=300 | 좋은 방어. 다만 5분 OFF 후 재기동이 또 5분이면 무한 반복되므로 "누적 에너지 한도"가 더 안전 |
| i | modem-sleep | `USE_WIFI_MODEM_SLEEP=1`, WIFI_PS_NONE는 부팅 크래시 이력 | 대회 프로필 자체가 MQTT stale 리스크와 맞물려 있음(코드 주석) |

원칙: **네트워크 쪽은 "가용성"의 문제이고, 안전은 로컬 하드웨어에서 닫혀야 한다.** SW 판정은 정상 동작 시의 제어, HW 차단은 SW가 틀렸을 때의 보험이다(4장).

---

## 2. Raspberry Pi 신뢰성 (Pi를 유지할 경우)

| 주제 | 사실 | 출처 |
|---|---|---|
| 전원 차단과 SD 손상 | 쓰는 중 전원이 끊기면 SD의 내부 컨트롤러가 매핑을 잃어 파일시스템 손상·부팅 불가가 발생한 사례 다수. UPS 권장 | https://forums.raspberrypi.com/viewtopic.php?t=219032 , https://forums.raspberrypi.com/viewtopic.php?t=240106 [2차] |
| 고내구 SD가 "crash-proof"는 아님 | 산업용 SD는 동작온도 범위(-40~+80°C 대 -25~+60°C) 차이와 pSLC 옵션이 있으나, 고내구 카드가 더 잘 견딘다는 보장은 없다는 지적 | 위 포럼 스레드 묶음 [2차] |
| read-only rootfs / overlayfs | `raspi-config` -> Performance Options -> Overlay File System. 루트를 읽기 전용으로 두고 쓰기를 RAM 오버레이로. 부트 파티션 보호 여부는 별도 선택 | https://forums.raspberrypi.com/viewtopic.php?t=173063 , https://ohyaan.github.io/tips/overlayfs_-_layer-based_filesystems_for_raspberry_pi/ [2차]. 공식 문서 configuration 페이지 원문 확인은 실패(WebFetch에서 해당 절 미노출) |
| 설정 변경 | overlay를 끄고 재부팅 -> 변경 -> 다시 켜고 재부팅(2회 재부팅) | 위 [2차] |
| 하드웨어 워치독 | bcm2835_wdt 최대 15초. `RuntimeWatchdogSec` 15 초과 시 조용히 무시됨(EINVAL). 커널이 주기적으로 갱신 | https://forums.raspberrypi.com/viewtopic.php?t=250022 , https://github.com/systemd/systemd/issues/27427 [2차] |
| 전원 요구 | Pi 4: 5V/3A. Pi 5: 5V/5A(25W) 또는 5V/3A + 주변기기 600mA 제한 | https://www.raspberrypi.com/documentation/computers/raspberry-pi.html [직접] |
| 언더볼티지 | 저전압 감지는 4.65V 미만 트랜지언트를 검출. 케이블 전압강하·전류 부족이 원인. 공식 PSU는 18AWG 케이블 사용 | https://forums.raspberrypi.com/viewtopic.php?t=357470 , https://community.element14.com/products/raspberry-pi/f/forum/11052/raspberry-pi-4-model-b---under-voltage-detection [2차, 스니펫과 개별 URL 대응이 불확실] |
| Pi 5 3A 어댑터 | 5A PD를 못 잡으면 USB 전류를 600mA로 제한 | 공식문서 [직접] |
| SSD 부팅 | 이번 세션에서 근거 못 찾음 | 미확인 |

권고(Pi를 남기는 경우, 근거가 [가정]인 부분 포함):
1. 공식 PSU 사용, ESP32 5V 레일과 절대 공유하지 않는다(MQ 히터 350mA가 언더볼트를 유발).
2. overlayfs 활성화(시연 전날 최종 이미지 고정) + mosquitto persistence/journald 로그를 tmpfs 또는 최소화. 시연 종료 후 셧다운 절차를 지킨다.
3. systemd watchdog 켜기(`RuntimeWatchdogSec=10`).
4. 부팅 시 3개 서비스가 자동 기동하도록 systemd unit 작성. 20시간 제작 중 가장 자주 잊히는 부분.
5. 예비 SD카드(복제본)를 부스에 둔다.
6. **Pi가 죽어도 ESP32가 안전하게 계속/정지하도록 이미 코드가 되어 있으므로, Pi는 "죽어도 되는 부품"으로 격하**하는 것이 가장 강력한 신뢰성 대책이다.

---

## 3. 전원 설계 (전력망)

### 3-1. 근거 있는 수치
| 부품 | 값 | 출처 |
|---|---|---|
| ESP32-S3 Wi-Fi TX 피크 | 340mA (802.11b 1Mbps @21dBm), 283~286mA (802.11n) | https://documentation.espressif.com/esp32-s3_datasheet_en.pdf Table 5-7 [직접] |
| ESP32-S3 단일 전원 권장 | "recommended output current is 500 mA or more" | 위 datasheet 각주 4 [직접] |
| ESP32-S3 GPIO 입력 최대 | VIH max = VDD + 0.3V (5V 직결 금지) | 위 datasheet [직접] |
| MQ-137 히터 | VH 5.0V±0.1V, 히터 소비 900mW 이하 표기(표 열이 깨져 있어 재확인 권고), 검출 범위 5~500ppm NH3(표기 "5500ppm"은 5~500의 깨짐으로 추정) | https://cdn.sparkfun.com/assets/b/6/7/5/8/MQ137_datasheet.pdf [직접, 표 일부 판독 불확실] |
| MQ-135 히터 (참고) | VH 5V, RH 33Ω±5%, PH 800mW 미만 (5/33 = 약 152mA) | https://www.olimex.com/Products/Components/Sensors/Gas/SNS-MQ135/resources/SNS-MQ135.pdf [직접] |
| MQ-138 | 히터 사양 미확인. MQ-137과 동급으로 가정 | 미확인 |
| 사용자 가정 "각 수십~150mA" | MQ-135 기준 약 150mA, MQ-137은 900mW 이하 = 최대 180mA. **"수십 mA"는 맞지 않음** — 약 150~180mA로 잡을 것 | 위 두 datasheet |
| Pi 4 / Pi 5 | 5V 3A / 5V 5A | 공식문서 [직접] |
| INA219 | 버스 전압 0~26V, 션트 최대 320mV | https://www.ti.com/lit/ds/symlink/ina219.pdf [2차] |

부가 사실: MQ-137 datasheet는 실리콘 계열(silicone 접착제/퍼티 등) 증기에 노출되면 감도가 영구히 회복되지 않는다고 경고한다 [직접]. 제작 현장에서 실리콘 실란트로 센서 근처를 밀봉하면 안 된다. 물이 튀면 감도가 떨어지고(1.4), H2S/SOx/Cl2 등 부식성 가스에서는 구조 손상과 감도 감쇠(1.2)가 있다고 되어 있다 [직접].

### 3-2. 예산 계산표

레일 구분 권고: **(A) 5V 로직·센서 레일**(ESP32+MQ 히터 2개+릴레이 코일+저전류 센서) / **(B) 모터·팬·히터 레일**(별도 어댑터 또는 별도 DC-DC) / **(C) Pi 전용 PSU**.

| 레일 | 부품 | 값(mA) | 근거 구분 |
|---|---|---|---|
| A | XIAO ESP32S3 (Wi-Fi TX 피크, 3.3V 측 340~500mA를 LDO 경유 가정하여 5V측 동일 전류로 계산) | 500 | 340은 [직접], 500은 권장 용량 [직접]. 온보드 레귤레이터 정격은 미확인 |
| A | MQ-137 히터 | 180 | 900mW/5V [직접, 표기 불확실] |
| A | MQ-138 히터 | 180 | [가정] MQ-137과 동급 |
| A | 릴레이 모듈 코일+LED (5V 소형 모듈 통상) | 90 | [가정] |
| A | DS18B20 + DHT11 + INA219 | 10 | [가정] 각 수 mA 이하 |
| **A 합계(최악)** | | **960** | |
| A | 어댑터 5V 2A 사용 시 부하율 | 48% (여유 52%) | 계산 |
| A | 여유율 30% 기준 필요 용량 | 960 x 1.3 = 약 1250 | 계산 -> **5V 2A 이상 권고** |
| B | 12V 실리콘 히터 패드 30W | 2,500 | 30W/12V 계산. 패드 선정에 따라 변동 |
| B | 교반 모터 | 미확인 | [가정] 기동 시 정격의 3~5배 |
| B | 탈취 팬 | 미확인 | [가정] |
| C | Pi 4 | 정격 3A PSU, 부하 실측 약 1.3A(주변기기 포함) [2차] | https://raspberry.tips/en/raspberrypi-tutorials/raspberry-pi-power-consumption-update-2026-all-models-compared |
| C | Pi 5 | 정격 5A, 부하 실측 약 2.15A [2차] | 위와 동일 |

히터 패드 참고 계산(전부 [가정]): 24V 30W = 1.25A, 12V 30W = 2.5A. INA219 션트 0.1Ω 기준 12V/2.5A에서 션트 손실 = 2.5^2 x 0.1 = 0.625W, 측정 한계 3.2A(320mV/0.1Ω). 24V 계열은 무부하 전압이 26V 한계에 가까워질 수 있으므로 **12V를 권고**한다.

### 3-3. 브라운아웃·노이즈·접지·디커플링
- ESP32는 Wi-Fi 송신 순간 피크가 크다. 어댑터 용량 부족·긴 배선 전압강하가 브라운아웃 리셋의 주된 원인이다. 벌크 캐패시터를 5V 입력 근처에 두고(예: 470~1000uF, [가정]), 0.1uF를 각 모듈 전원 핀 옆에 둔다. Espressif 하드웨어 가이드는 전원 핀 근처 0.1uF 디커플링을 권고한다 [2차] https://docs.espressif.com/projects/esp-hardware-design-guidelines/en/latest/esp32s3/esp-hardware-design-guidelines-en-master-esp32s3.pdf
- ESP32-S3 datasheet에서 브라운아웃 임계값 수치는 텍스트 검색으로 찾지 못했다(미확인).
- **MQ 센서 아날로그 출력**: 5V 모듈의 AO가 3.3V ADC 핀에 그대로 들어가면 VIH max(VDD+0.3V)와 절대최대(입력 전원핀 3.6V)를 위반할 수 있다 [직접]. 분압(예: 10k/20k [가정]) 또는 모듈 AO 출력 범위 실측 필요. 코드 인수인계 문서는 "5V VCC, median-of-21"만 언급하고 분압 여부는 확인되지 않았다 [코드].
- **ADC 노이즈**: 릴레이 코일·모터·히터 스위칭이 5V 레일에 리플을 만든다. 릴레이 코일 전원을 ESP32 전원과 분리하거나 각각 벌크 캐패시터 추가. 모터는 별도 레일 + 플라이백 다이오드 + 0.1uF 세라믹 [일반 설계 원칙, 미인용].
- **공통 접지**: 모든 레일의 GND를 한 점(스타)으로 묶되, 히터/모터 대전류 복귀선은 센서 GND와 분리한 굵은 별도 경로로 한 점에서 합류. MQ 히터 전류(약 360mA)가 ADC 기준선에 IR 강하를 만들지 않도록 MQ GND 복귀를 ADC 기준에 가깝게 [일반 설계 원칙, 미인용].
- MQ 예열: 제품 문서상 예열 시간이 필요 [MQ-135 검색 스니펫 30초~수 분, 2차]. 시연 시작 최소 수 분 전에 전원 인가.
- 프로젝트 이력: 이전 보드 GPIO5/6 핀 자체가 손상된 사례가 있었다 [코드]. **예비 XIAO 보드 2개 이상 지참**.

---

## 4. 히터 전력 · 안전

### 4-1. AC 220V 히터 + 릴레이의 위험
- 감전·화재·접점 융착·접지 누락. 학생 시제품은 절연 거리(creepage/clearance), 접지 연속성, 퓨즈, 커버가 갖춰지기 어렵다 [일반 원칙, 미인용].
- 국내 법적 프레임: 전기용품 및 생활용품 안전관리법(KC 인증 대상 판단) https://elaw.klri.re.kr/kor_service/lawView.do?hseq=37548&lang=KOR [2차]. 시제품이 판매/공중 사용 대상이 아니면 적용이 다르겠지만 판단은 미확인.
- 전시장: 전시회 운영규정 예시(KES)는 전기·전열기기 사용을 제한하고 "위험물 반입 허가 신청서"로 주최 측 승인을 받아야 하며 안전 스위치가 있는 제품만 가능하다고 안내한다 [2차] https://www.kes.org/bbs/down.asp?id=kor_etc&no=1889 (KES 2025). **GIST 메이커톤 현장 규정은 미확인 — 사전 문의 필요.**

### 4-2. 권고 대안: 12V DC 실리콘 히터 패드(수십 W) + MOSFET 또는 DC SSR
- 12V 30W(2.5A)면 전선/커넥터/퓨즈가 감전 위험 없는 저전압. INA219(26V) 그대로 사용 가능 [3장 계산].
- 스위칭: 로직레벨 N-MOSFET 로우사이드(게이트 풀다운 저항 필수, 부팅 중 플로팅 방지) 또는 DC 출력 SSR. AC용 SSR을 DC 부하에 쓰면 OFF가 안 될 수 있으니 부하 종류를 반드시 확인 [일반 원칙, 미인용].
- 기계식 릴레이를 유지하려면 DC 12V 3A 이상의 접점 정격 확인 + 접점 융착 감지(INA219로 OFF 명령 중 전류 0 확인)를 추가.
- 가격/판매처 미확인(이번 세션에서 확인 못 함).

### 4-3. 소프트웨어와 독립인 하드웨어 안전장치 (필수)
SW가 "정상일 때"의 제어이고 HW가 "SW가 틀렸을 때"의 보험이다.

| 계층 | 부품 예 | 특성 | 출처 |
|---|---|---|---|
| 1차 제어 | ESP32 + MOSFET/릴레이 | 히스테리시스+예측 조기 OFF | [코드] |
| 2차: 자동 복귀 과온 차단 | KSD301 바이메탈 서모스탯 (NC, 250V 10A, 40~130°C 등 온도 옵션, 자동/수동 복귀 선택) | 히터 전원선에 직렬. 설정값을 42°C보다 조금 높게(예: 50~60°C 옵션, [가정]) | https://www.calcoelectric.com/images/pdfs_thermostats/calco_ksd301series.pdf [2차], Amazon 상품 다수 [2차] |
| 3차: 1회성 열퓨즈(Thermal cutoff) | MICROTEMP 등 열퓨즈. 회복 불가라 서모스탯이 융착돼도 차단 | 서모스탯 뒤에 직렬 | https://www.sensience.com/wp-content/uploads/2022/12/Microtemp_Catalog.pdf [2차] |
| 표준 관점 | 열퓨즈는 IEC/UL 60691, 바이메탈 서모스탯은 IEC/UL 60730 범주로 서로 다른 표준. 자동복귀 서모스탯 + 뒤쪽 1회성 퓨즈의 조합이 흔한 최후 방어선이라는 설명 | https://thermalsensorcable.com/blog/thermal-cutoff-cable-vs-thermal-fuse-vs-bimetallic-thermostat.html [2차] |
| MCU hang 대비 | ESP32 태스크 워치독 + (권고) 하드웨어 dead-man: 릴레이/MOSFET 구동 전원을 "MCU가 주기적으로 토글하는 신호로만 유지되는" 회로(RC + 정류 또는 외부 워치독 IC)로 만들기 | [가정, 일반 설계 패턴, 미인용] |
| 전류 검증 | INA219로 "ON 명령 시 예상 전류 범위 / OFF 명령 시 ~0" 감시. 벗어나면 즉시 OFF + 알림 | INA219 운영 코드 미통합 [코드] |

- 서모스탯/열퓨즈 장착 위치: 히터 패드 표면 또는 챔버 내 열이 가장 높은 지점에 열적으로 접촉시킨다. 센서 위치와 다르므로 검출 온도 오프셋을 실측해야 한다 [가정].
- 퓨즈: 12V 라인에 정격 3~5A 자동차용 블레이드/글라스 퓨즈 [가정]. AC 220V 유지 시 접지 연결, 절연 트랜스/커버, 누전차단기 필요 [일반 원칙].

---

## 5. 미생물 처리기 공학 근거

### 5-1. 열 시상수 대비 60초 창·120초 예측의 의미
아래는 **모두 [가정]** 값을 두고 한 자릿수 크기 추정이다. 실제 챔버로 실측해야 한다.
- 챔버 내용물 3kg, 비열 3kJ/kgK, 용기 1kg x 0.5kJ/kgK -> 열용량 C 약 10kJ/K.
- 히터 50W면 승온 속도 = 50/10,000 = 0.005K/s = **0.3K/분**. 10K 올리려면 약 33분.
- 열손실 계수 1~2W/K를 가정하면 시상수 tau = C/G = 약 1.5~3시간.
- 결론: 순수 열용량 관점에서 120초 뒤 온도는 현재 온도에서 최대 약 0.6K 벗어날 뿐이다. **"120초 예측"이 의미 있게 작동하는 유일한 물리는 히터 표면과 온도센서 사이의 열 전달 지연(overshoot 보정)**이다. 이 지연은 배치에 따라 수십 초~분 단위일 수 있다 [가정]. 60초 창은 그 지연을 보기엔 너무 짧지 않지만, 센서 분해능이 문제다.
- 센서 분해능 문제: 프로젝트는 DS18B20을 9-bit로 사용한다 [코드]. DS18B20 9-bit 분해능은 0.5°C 단계다(데이터시트 미열람, 일반 지식 [가정]). 60초 창에서 기울기를 0.3K/분으로 추정하려면 0.5°C 단계보다 작은 신호를 다뤄야 해서, 기울기 특징이 양자화 잡음에 묻힌다. 12-bit(0.0625°C, 변환 750ms [가정])로 올리는 것이 1Hz 샘플링과도 맞다.
- 학습 데이터 한계 [코드]: 원본 1947행/422분, 유효 샘플 245(train 196/val 49), RF val MAE 0.032°C, 예측 clip 22~31°C, 데모 목표 25.5°C, 안전 28.5°C. 실온 유지 상태의 데이터라 target 변화가 거의 없다. MAE 0.032°C는 (i) 시계열 인접 샘플이 훈련/검증에 섞였을 가능성, (ii) 정지 상태에서는 "현재 온도 = 미래 온도"가 거의 정답이라는 점 때문에 **낙관적일 가능성이 높다**. 방어하려면 (1) 시간 순서로 분할한 검증, (2) 지속 예측(T(t+120)=T(t)) 및 선형 외삽 기준선과의 MAE 비교를 제시해야 한다.
- Python 판정 서비스의 목표 37°C, 최대 안전 42°C [코드]는 데모 학습 범위(22~31°C)와 다르다. RF 예측은 학습 때 본 값 범위 안에서만 나오므로 37°C 근처 조기 OFF 규칙은 사실상 작동하지 않는다(트리 leaf 값이 그 범위로 제한).

### 5-2. 미생물 운전 온도 범위
- 퇴비화 문헌: 열발생(thermogenic) 단계 50~80°C에서 고온성 미생물이 관여 [2차] https://link.springer.com/article/10.1186/s40538-023-00381-z (원문 열람은 리다이렉트로 실패, 검색 스니펫만).
- 첨가 균주 예: Bacillus coagulans(고온성) 40~60°C, Bacillus subtilis(중온성) 30~50°C에서 생존 [2차] 특허 https://image-ppubs.uspto.gov/dirsearch-public/print/downloadPdf/10017730
- **린클 등 상용 제품의 목표 온도는 공식 문서에서 확인하지 못했다(미확인).** 프로젝트가 잡은 37°C 목표의 근거는 이번 검증에서 확인되지 않았으므로 "가정"으로 명시하거나 사용 균제 제조사 사양을 확인해야 한다.

### 5-3. 상용 제품 스펙 (린클)
| 항목 | 값 | 출처 |
|---|---|---|
| 린클 프라임 소비전력 | 평균 52W, 최대 130W (120V/60Hz 미국판 페이지) | https://reencle.co/pages/reencle-prime-kr [직접] |
| 용량 / 일 처리량 | 14L, 최적 약 0.7kg, 최대 약 1kg | 위와 동일 [직접] |
| 히터 W / 모터 W 별도 | **공식 페이지에 미기재** | 위와 동일 [직접, 미확인] |
| 그래비티W | 최대 90W, 평균 47W | https://cookpick.kr/reencle-food-waste-disposer-recommendation-top3/ [2차, 블로그성] |
- 시사점: 제품 전체 최대 130W이므로 히터는 그 이하다. 시제품의 12V 30W 히터는 상용 대비 규모가 작지만 데모용으로 타당하다 [가정].

### 5-4. 교반 모터 전류 감지로 과부하 판단
- 방식: INA219(또는 별도 전류센서)를 모터 전원선에 삽입하고 (1) 정상 교반 전류 기준선을 실측, (2) 기동 돌입 구간(약 0.5~1초)은 무시, (3) 기준선의 1.5~2배를 일정 시간(수 초) 초과하면 정지 후 역회전 시도, 재실패 시 알림 [가정, 일반 설계 원칙, 미인용].
- 현 코드에서 INA219는 운영 코드에 통합되지 않았고 `ina219_valid=false` 하드코딩이다 [코드]. 히터 전류 검증까지 같은 채널이 필요하다면 INA219를 2개(I2C 주소 변경)로 분리하는 것을 고려.
- 모터 노이즈가 5V 로직 레일과 I2C에 유입되므로 모터 전원 분리(3장)가 선행되어야 한다.

### 5-5. 부식성 환경 (암모니아, 습기)
- 암모니아는 구리 및 구리합금에 부식성이며, 침투량·수분량·온도 변화가 심할수록 심하다. 대책으로 컨포멀 코팅, 금/주석 도금 커넥터 [2차] https://www.eng-tips.com/threads/amonia-gas-corrosion-on-electronics.260029/ , https://resources.altium.com/p/circuit-design-tips-pcb-moisture-protection-humid-environments
- 센서 자체: MQ-137 datasheet는 물 튐과 고농도 부식성 가스에서 감도 저하를 경고 [직접] https://cdn.sparkfun.com/assets/b/6/7/5/8/MQ137_datasheet.pdf
- 설계 권고: 전자부는 챔버 밖 격벽 뒤에 두고 센서 프로브만 챔버 내 통기 구멍에 위치. 컨포멀 코팅 시 MQ 센서 개구부는 마스킹. 실리콘 계열 코팅/실란트는 MQ 센서에 금지 [직접, 위 datasheet 1.1]. 릴레이 접점은 밀폐형 사용 권고 [가정].
- DHT11은 상대습도 최대 95% 근처 응결 환경에 취약할 것으로 예상되나 이번에 datasheet를 열람하지 않아 미확인.

---

## 6. 시연 신뢰성

1. **스마트폰 핫스팟 -> 전용 공유기**: 핫스팟은 유휴 타이머, 재연결 실패("UNSPECIFIED"), 앱 절전 등 문제 사례가 다수 보고됨 [2차] https://www.esp32.com/viewtopic.php?t=8769 , https://github.com/espressif/arduino-esp32/issues/2110 . 프로젝트 코드에도 stale 재현 이력이 있다 [코드].
   - 전용 공유기: 2.4GHz 고정 채널(1/6/11 중 주변 AP가 가장 적은 채널) [가정], SSID 숨김/암호 고정, 인터넷 불필요(오프라인 LAN), DHCP 예약 또는 고정 IP. ESP32-S3는 2.4GHz 전용이므로 5GHz 전용 SSID는 사용 불가 [직접: 데이터시트 제목 "2.4 GHz Wi-Fi + Bluetooth LE"].
   - 현장(대회장)의 2.4GHz 혼잡은 [가정]. 공유기를 부스 안에 두고 안테나가 가까운 거리에 있게 한다.
2. **MQTT QoS/재연결**:
   - PubSubClient는 QoS 0 발행만 가능, 구독은 QoS 0/1, 기본 최대 메시지 256B, keepalive 기본 15초 [직접] https://raw.githubusercontent.com/knolleary/pubsubclient/master/README.md . 따라서 "QoS1로 안전 명령 전달"은 이 라이브러리에서는 불가. 명령 손실은 20초 stale 규칙으로 흡수해야 한다.
   - LWT: 브로커가 keepalive 내 통신 실패·비정상 종료 시 미리 등록된 메시지를 발행. LWT QoS는 일반 메시지와 독립 [직접] https://www.hivemq.com/blog/mqtt-essentials-part-9-last-will-and-testament/ . ESP32 노드 상태를 LWT로 표시하면 대시보드가 "노드 오프라인"을 즉시 표시할 수 있다.
   - 권고: 추론 주기(10초)와 stale 한도(20초)의 비율을 완화(예: 5초 발행/20초 stale) + retained 메시지 + 메시지에 생성 시각/시퀀스 번호를 넣어 오래된 명령 배제 [가정].
3. **발표 중 실패 대비**:
   - ESP32 단독 제어 모드 스위치(Pi/Wi-Fi 없이도 시연 가능): `USE_MOCK_SENSOR_PROVIDER` 같은 시뮬레이션 경로가 이미 존재 [코드].
   - 사전 녹화 영상(핵심 동작 60~90초), 예비 XIAO 보드 2개, 예비 어댑터/케이블, 대시보드 스크린샷 백업, 로컬 CSV 로그(ESP32 시리얼 또는 노트북).
   - 시연 순서: 부팅 -> 센서 예열(수 분 전 미리) -> 정상 -> 고온 주입(과온 차단 시연: 안전 규칙 발동 화면) -> 통신 끊기 시연(Wi-Fi 차단해서 히터 OFF 유지 확인 = "fail-safe" 자랑 포인트).
   - 큰 시연 실패 요인 3개: Wi-Fi, 전원(어댑터/케이블), 센서 예열. 이 3개를 체크리스트로 관리.

---

## 7. 20시간 제작 우선순위 (권고)

| 순위 | 작업 | 사유 |
|---|---|---|
| 1 | 히터를 12V 패드 + MOSFET으로 교체, 12V 라인에 퓨즈 + KSD301 + 열퓨즈 직렬 | 가장 큰 리스크 제거 |
| 2 | ESP32 태스크 워치독 + MOSFET 게이트 풀다운 | MCU hang 대비 |
| 3 | 5V 2A 로직 레일 분리, 벌크 캐패시터, MQ AO 분압 확인 | 브라운아웃/ADC 손상 방지 |
| 4 | INA219를 히터 채널에 통합(융착/미가열 감지) | HW 검증 |
| 5 | 판정 로직을 ESP32 내부로 이식(Pi 없이도 동작) | 네트워크 독립 |
| 6 | 전용 공유기 + 녹화 영상 + 예비 보드 | 시연 신뢰성 |
| 7 | (선택) 교반 모터 전류 감시 | 여유 있으면 |

---

## 8. 미확인 / 후속 확인 필요 목록
- GIST 메이커톤 현장 전열기구 규정, 전원 콘센트 종류/용량
- 국내 실제 결제가 (Pi 4/5/Zero 2 W, XIAO ESP32S3, UNO R4 WiFi, 히터 패드, 열퓨즈, KSD301)
- MQ-138 히터 사양, MQ-137 히터 소비전력 표 수치(표 깨짐)
- DS18B20/DHT11/INA219 데이터시트 수치(전류, 분해능, 변환시간, 습도 한계)
- XIAO ESP32S3 온보드 레귤레이터 정격, ESP32-S3 브라운아웃 임계값
- UNO Q 소비전력, Pi Zero 2 W 소비전력, Jetson 7W 모드
- 린클 히터 W/모터 W 및 운전 목표 온도, 사용 균제의 최적 온도
- Pi SSD 부팅 지원 근거
- 프로젝트 코드에서 DS18B20 85°C/-127°C 처리 여부, MQTT 메시지 내 생성시각 사용 여부

---

## 9. 출처 정리

**직접 열람(원문 텍스트 추출/페이지 열람)**
- ESP32-S3 datasheet v2.2 https://documentation.espressif.com/esp32-s3_datasheet_en.pdf
- MQ-135 datasheet (Olimex) https://www.olimex.com/Products/Components/Sensors/Gas/SNS-MQ135/resources/SNS-MQ135.pdf
- MQ-137 datasheet v1.4 (Winsen, SparkFun 호스팅) https://cdn.sparkfun.com/assets/b/6/7/5/8/MQ137_datasheet.pdf
- Raspberry Pi 공식 문서 https://www.raspberrypi.com/documentation/computers/raspberry-pi.html
- Raspberry Pi Zero 2 W 제품 페이지 https://www.raspberrypi.com/products/raspberry-pi-zero-2-w/
- Arduino UNO Q 문서 https://docs.arduino.cc/hardware/uno-q
- 린클 프라임 https://reencle.co/pages/reencle-prime-kr
- PubSubClient README https://raw.githubusercontent.com/knolleary/pubsubclient/master/README.md
- HiveMQ LWT https://www.hivemq.com/blog/mqtt-essentials-part-9-last-will-and-testament/
- 프로젝트 소스: `AI_energy_smarthome/communication-module/sensor-node-esp32s3/ai-sensor-node/{SensorConfig.h, ai-sensor-node.ino, CoreTempModel.h}`, `ai-training/{predict_service.py, training_report.json}`, `communication-module/docs/센서_하드웨어_인수인계.md`

**2차(검색 스니펫)**
- Pi 전원/언더볼트: https://forums.raspberrypi.com/viewtopic.php?t=357470 , https://community.element14.com/products/raspberry-pi/f/forum/11052/raspberry-pi-4-model-b---under-voltage-detection , https://support.thepihut.com/hc/en-us/articles/13852538984221-Which-power-supply-do-I-need-for-my-Raspberry-Pi-5
- Pi SD/overlay/watchdog: https://forums.raspberrypi.com/viewtopic.php?t=219032 , https://forums.raspberrypi.com/viewtopic.php?t=173063 , https://forums.raspberrypi.com/viewtopic.php?t=250022 , https://github.com/systemd/systemd/issues/27427
- 전력 실측: https://raspberry.tips/en/raspberrypi-tutorials/raspberry-pi-power-consumption-update-2026-all-models-compared
- 보드/가격: https://www.icbanq.com/P017086271 , https://www.icbanq.com/P015956549 , https://www.tomshardware.com/raspberry-pi/arduino-uno-q-review , https://www.raspberrypi.com/news/raspberry-pi-pico-2-w-on-sale-now/ , https://docs.arduino.cc/resources/datasheets/ABX00087-datasheet.pdf , https://jetsonhacks.com/2024/12/17/jetson-orin-nano-super-developer-kit/ , https://www.devicemart.co.kr/goods/view?no=14981265
- 히터 안전: https://www.calcoelectric.com/images/pdfs_thermostats/calco_ksd301series.pdf , https://www.sensience.com/wp-content/uploads/2022/12/Microtemp_Catalog.pdf , https://thermalsensorcable.com/blog/thermal-cutoff-cable-vs-thermal-fuse-vs-bimetallic-thermostat.html , https://www.ti.com/lit/ds/symlink/ina219.pdf
- 전시/법규: https://www.kes.org/bbs/down.asp?id=kor_etc&no=1889 , https://elaw.klri.re.kr/kor_service/lawView.do?hseq=37548&lang=KOR
- 미생물/부식: https://link.springer.com/article/10.1186/s40538-023-00381-z , https://image-ppubs.uspto.gov/dirsearch-public/print/downloadPdf/10017730 , https://www.eng-tips.com/threads/amonia-gas-corrosion-on-electronics.260029/ , https://resources.altium.com/p/circuit-design-tips-pcb-moisture-protection-humid-environments
- 핫스팟: https://www.esp32.com/viewtopic.php?t=8769 , https://github.com/espressif/arduino-esp32/issues/2110
- 린클 그래비티W: https://cookpick.kr/reencle-food-waste-disposer-recommendation-top3/
