yco252444-blip/gamja/md_files/05_발표자료_전사_및_코드대조.md

# 발표자료(14슬라이드) 전사 + 코드·데이터 대조

작성: 2026-09-21. 원본: `AI_energy_smarthome_발표자료.html` (슬라이드 14장 전부 JPEG 이미지, 텍스트 레이어 없음 → 이미지를 `발표자료_슬라이드/slide_01~14.jpg`로 추출해 직접 열람).
대조 근거: ZIP 안 코드·CSV·인수인계 문서(`../08_project_adversarial.md`, 설명 md §9.4 참고). **✔ = 코드/데이터로 뒷받침됨, ✘ = 반대 증거, △ = 뒷받침 못 찾음.**

## 1. 슬라이드 전사

| # | 제목 | 내용 요약 |
|---|---|---|
| 1 | 표지 | "혁신 기술 / AI 미생물 처리기" |
| 2 | $10 ESP32-S3와 AI의 월 1,500원대 처리기 | 음식물 처리기 시장 약 1조 원(차트 출처 "시장조사기관 리포트(2024)"), 기기값 150만~300만 원·전기세 월 5만~8만 원이 진입장벽. 당근마켓 "린클 미생물이 다 망가져서 구해봅니다" 글 캡처. 우리 솔루션: ESP32-S3(약 $10)+온디바이스 AI로 **월 1,500원대 운영비**, 'Zero-Care' |
| 3 | 숨어있는 문제: 기존 단순 제어의 비효율 | 타이머·단순 릴레이·1차 함수 제어의 한계 / 에너지 낭비(월 5만~8만 원 청구서 이미지) / 과열로 미생물 손상 |
| 4 | 해결책: AI 머신러닝 기반 적응형 제어 | ①온도·히터 전류·가스 다변량 시계열 상관 분석 ②심부온도 기울기(d/dt)+가스 패턴으로 미생물 활동 진단 ③**0.1초 Fail-Safe** 즉시 차단 |
| 5 | 뜨거운 음식물 감지 → 저전력 모드 | 심부온도 급상승+가스 정상 → '외부 열원 투입'으로 인식 → 히터 차단, Modem-Sleep으로 **180mA→35mA(75% 절감)**, 앱 알림 |
| 6 | 차가운 음식물 감지 → 저전력 모드 해제 | 온도 완만 하강 → 저전력 해제·히터 정상 가동 (본문 박스가 검게 렌더링된 상태) |
| 6′ | (제목 중복) BEFOER/AFTER | 단순 타이머/서모스탯 vs **AI 복합 센서 선제 제어**. CLASS 3(혐기성) 감지 시 히터 즉시 0%, 교반 정/역방향 정밀 교반, 탈취 팬 최대. "악취 유출 0%" |
| 7 | AI 추론 접목 (표) | **5개 모드**: CLASS 0 예열 / 1 분해 완료 / 2 자가발열(오버슈트) / 3 혐기성 부패 / 4 모터 과부하. 입력: 심부-공기 온도차 ΔT, VOCs, 습도(90%↑·85%↑), 모터 전류. 출력: 히터(PID 70~80%/0%), 배기 팬(20/0/100/50%), 교반 모터(정상/정·역방향/역회전 3초 후 정회전) |
| 8 | 미생물 부패 감지 및 사용자 알림 | 가스·온습도 다변량 패턴 → 부패 의심 즉시 알림 → 관리 가이드 자동 표시 (앱 목업 이미지) |
| 9 | 저전력 모드와 일반 모드 전력 비교 | 일반 180mA / 저전력 35mA / **"3개월 이상 실제 가정 환경에서 운영한 데이터로 75% 절감 확인"** / 월 운영비 1,500원대 / 가구당 연 6만~8만 원 절감 |
| 10 | AI 추론 기반 사용자 행동 유도 및 대시보드 연동 | 1Hz 수집(심부온도·**히터 전류**·가스) → 60초 원형 버퍼 → ML 다변량 분석 → 0.1초 이내 Fail-Safe 차단·앱 알림 |
| 11 | B2B2C 및 B2B 비즈니스 모델 | B2C/크라우드펀딩: 울트라 얼리버드 279,000원, 슈퍼 얼리버드 309,000원(1년 풀케어), B2B 평가용 개발자 Kit 150,000원, 목표 1,000만 원. B2B: AI 모듈 OEM/ODM, IP 라이선싱, OTA SaaS |
| 12 | 지속 가능성: ESG | 1,000가구 기준 연 6,000만~8,000만 원 전기료 절감·**약 200톤 탄소 감축** / 소모품 정기구독 / B2B 모듈 / 지자체 보조금 |
| 13 | MODEM Sleep | Wi-Fi 유지하며 ESP32-S3 소비 전력 **80% 이상 절감(평균 100~240mA → 15~30mA)**. Deep Sleep 대비 60초 링버퍼·슬라이딩 윈도우 유지, 대시보드 즉시 송신 |

※ 슬라이드 번호가 06·10이 두 번씩 나옴, "BEFOER" 오탈자, 슬라이드 6 본문 검은 박스, 슬라이드 6′ 표가 잘림 → 편집 미완성 상태의 자료.

## 2. 발표 주장 vs 코드·데이터 대조

| # | 발표 주장 | 대조 결과 | 판정 |
|---|---|---|---|
| 1 | **"3개월 이상 실제 가정 환경 운영 데이터로 75% 절감 확인"** (슬라이드 9) | 커밋 기간 2026-07-28~30, 학습 CSV는 07-30 하루 약 7시간. 소비전력 데이터 0건(INA219 미확정). 프로젝트 문서 스스로 "정량 절감 미실측" 명시 | ✘ **근거 없음 — 가장 위험한 문장.** 심사에서 질문 1개로 무너지고 신뢰 전체를 잃을 수 있음. 반드시 삭제 또는 실측으로 교체 |
| 2 | 저전력 180mA→35mA, 75%(슬라이드 5·9) vs 100~240→15~30mA, 80%+(슬라이드 13) | 두 슬라이드의 숫자가 서로 다름. 코드는 `WIFI_PS_MIN_MODEM` 설정(커밋 07-29 확인)만 있고 전류 측정 로그 없음. 또 이것은 **ESP32 칩 전류**이지 처리기 히터 전력이 아님 | △ 미측정 + 내부 불일치 |
| 3 | "월 1,500원대 운영비"를 기존 처리기 월 5~8만 원 전기세와 비교(슬라이드 2·3·9) | 1,500원은 ESP32 칩 수준의 값. 5~8만 원은 히터 포함 기기 전체. **비교 대상이 다름**. 히터 절감량은 측정 없음. 조사 결과 린클 프라임 공식 평균 52W(월 약 37kWh 계산) — 5~8만 원 주장은 출처 미확인 | ✘ 논리 비약 |
| 4 | 1,000가구 연 6~8천만 원·200톤 탄소(슬라이드 12) | 위 3번의 가구당 6~8만 원을 곱한 값. 탄소 계수·산식 없음 | △ 파생 추정 |
| 5 | **5개 모드 분류(CLASS 0~4)**, VOCs·습도 90%·모터 전류 입력(슬라이드 7) | 코드에는 **회귀 모델 1개(120초 뒤 심부온도)**만 있음. 분류기 없음. 센서는 DS18B20·DHT11(공기 습도)·MQ-137/138(원값). VOC 센서·교반 모터 전류·챔버 내부 습도 센서 없음. 팬·모터 액추에이터 `null` | ✘ 미구현 |
| 6 | "히터 전류"를 수집(슬라이드 4·10) | INA219 실측 미확정, 최신 설정 `ENABLE_INA219=false`. 학습 CSV에 전류 컬럼 없음 | ✘ |
| 7 | **0.1초 Fail-Safe**(슬라이드 4·10) | 코드의 안전 상수: 센서 stale 15초, 명령 stale 20초, 최소 릴레이 유지 10초, 연속 가열 300초. 0.1초 근거 없음. MQTT 1Hz 구조라 0.1초 응답이 구조적으로 불가 | ✘ |
| 8 | 온디바이스 AI / "슬라이딩 윈도우 ESP32 백그라운드"(슬라이드 2·13) | 추론은 Pi 서버(`predict_service.py`)로 이전됨. ESP32의 슬라이딩 윈도우는 제거됨(코드 주석) | ✘ 표현 불일치 |
| 9 | 뜨거운/차가운 음식물 투입 감지→저전력 모드(슬라이드 5·6) | 급변 감지(±2℃/10초)는 있으나 **dry-run 전용, 릴레이 미적용**. 차가운 투입은 "완만한 하강"이라 급변 규칙과도 다름. 학습 데이터에 투입 이벤트 0건 | △ 코드 존재, 검증 0 |
| 10 | 미생물 부패 감지·알림·관리 가이드(슬라이드 8) | 앱 소스 ZIP 미포함. 앱 값은 mock. 부패 라벨 데이터 없음 | △ |
| 11 | 시장 약 1조 원(슬라이드 2) | 차트는 AI 생성 이미지로 보이며 출처 표기 "시장조사기관 리포트(2024)"만 있음 | △ 출처 확인 불가 |
| 12 | 크라우드펀딩 279,000원 등(슬라이드 11) | 시제품 BOM·양산 근거 없음. 처리기 본체(챔버·교반·히터) 설계 없음 | △ |
| 13 | 당근마켓 게시글 "린클 미생물이 다 망가져서 구해봅니다" | 실제 캡처로 보임(조회 130). 문제 근거로는 1건 | ✔ 약한 근거 |

## 3. 발표 자료를 그대로 재사용하면 안 되는 이유 (요약)
- 슬라이드 9의 "3개월 실측"은 코드·데이터와 정면 충돌하는 문장이라, 14회 심사·멘토링에서 **공정성·정직성 문제**로 번질 수 있다.
- 슬라이드 7의 5모드 분류·VOC·모터 전류는 현재 시스템에 없는 것을 있는 것처럼 보이게 한다.
- Oink(개선판)에서는 위 ✘ 항목을 (a) 삭제하거나 (b) 실측으로 채운 뒤에만 다시 넣는다.
