yco252444-blip/gamja/md_files/08_보유부품_목록.md

# SES팀 보유 부품 목록 (Oink 관점 정리)

작성: 2026-09-26. 출처: 팀이 공유한 소자 목록(원본 52행). 모델명만 확인했고 **실물 사양(정격 W, 모듈 회로)은 미검증**.

## 1. Oink에 직접 쓰는 것
| 역할 | 부품 | 수량 | 비고 |
|---|---|---|---|
| 메인 컨트롤러 | XIAO ESP32S3 | 4 | 예비 보드 확보 조건(A6) 충족 |
| 카메라(선택) | XIAO ESP32S3 Sense | 1 | 현재 계획에는 불필요 |
| 히터 | 캡톤 필름 히터 | 1 | 납땜됨. 판매처 표기 24V 14W, 41.1Ω(→ 약 0.58A), 권장 50℃·최대 180℃. 실측 저항 미검증 |
| 히터 전원 | 24V DC 어댑터 | 1 | 납땜됨. 판매처 표기 24V 1A(히터 0.58A 대비 여유 있음) |
| 히터 방열·균열 | 알루미늄 방열판 | 1 | |
| 히터 스위칭 | IRLZ44NPBF (N-MOSFET) | 1 | 로직레벨이지만 Rds(on)은 Vgs 4~5V 기준 규격. **3.3V 게이트 구동 시 발열 미검증** |
| 심부 온도 | DS18B20 | 2 | 1개 납땜됨. 2개면 이중화(과열 판정 1센서 의존 해소, F1) 가능 |
| 히터 전력 | INA219 | 1 | 26V·3.2A 한도. 히터 약 0.58A라서 한도 안(S5, 표기값 기준) |
| 암모니아 | MQ-137 | 1 | 5V AO → 분압 필요(S3) |
| 가스 | MQ-138 | 1 | ⚠ 목록에는 "황화수소"라고 적혀 있지만 MQ-138은 톨루엔·아세톤·알코올용이다(03, S1). 황화수소용은 MQ-136 |
| CO2 | CM1106S4 | 3 | 새로 확인된 부품. 미생물 활성도 지표 후보(미검증). 데이터시트 기준: 전원 5V(3.5~5.5V), UART 또는 I²C(R/T 핀으로 선택), PWM 출력도 있음. TX는 3.3V 레벨 |
| 온습도 | DHT11 / BME280 | 1 / 1 | BME280이 DHT11보다 정확하다(D6/S4 대안) |
| 상태 표시(선택) | OLED 0.96", 부저, WS2812B | 다수 | 현장 시연용 |
| AC 전력(선택) | PZEM-004T v3 | 1 | AC 히터 경로는 폐기했으므로 필요성 낮음 |
| 로그 허브(선택) | 라즈베리파이 4/5 | 각 1 | 제어 경로가 아닌 대시보드·로그 전용 |
| 챔버 제작 | 엔더3 V3 SE 3D 프린터 | 1 | 챔버·센서 마운트 출력 |

릴레이 1채널·4채널 모듈이 있지만 히터에는 쓰지 않는다(S6: 수명·부팅 글리치). 히터는 MOSFET으로 스위칭한다.

## 2. 없는 것 (구매 필요)
| 부품 | 이유 | 우선 |
|---|---|---|
| 퓨즈 + 홀더 (24V 라인) | 안전 3종(F1). 정격은 히터 전류와 INA219 3.2A 한도에 맞춰 결정 | P0 |
| KSD301 등 서모스탯 (NC) | 안전 3종(F1). SW와 무관한 하드웨어 차단 | P0 |
| 열퓨즈 | 안전 3종(F1) | P0 |
| MOSFET 게이트 풀다운 저항(10k)·게이트 저항 | 부팅 시 OFF 보장(S6) | P0 (기초 부품키트에 있을 수 있음) |
| MQ AO 분압 저항 | ADC 보호(S3) | P0 (위와 같음) |
| (선택) MQ-136 | 황화수소 경보를 주장하려면 필요 | P2 |
| (선택) 3.3V용 게이트 드라이버 또는 Vgs(th)가 낮은 MOSFET | IRLZ44N을 3.3V로 구동했을 때 발열이 크면 필요 | P1 (실측 후 판단) |

## 3. 확인해야 할 것
1. ~~캡톤 히터 정격~~ → 표기 14W/41.1Ω. 멀티미터로 저항만 실측하면 된다.
2. ~~24V 어댑터 정격 전류~~ → 표기 1A.
3. ~~CM1106S4 인터페이스와 공급 전압~~ → UART/I²C/PWM, 5V 전원(데이터시트 4쪽). 실물이 S4 변형과 같은지는 미검증.
4. MQ 모듈 보드의 분압 여부(모듈 사진 필요).

## 4. 데이터시트
`datasheets/` 폴더: IRLZ44N, INA219, BME280, DHT11, DS18B20, MQ-137, MQ-138, ESP32-S3, XIAO ESP32S3 회로도. CM1106S는 제조사 공개 PDF가 없어 directindustry 카탈로그 페이지 이미지(18쪽)를 합쳐 만들었다(텍스트 검색 불가).
