yco252444-blip/gamja/md_files/06_대회적합성_보완계획.md

# 08. 기존 프로젝트(미생물 음식물 처리기 제어 솔루션) 적대적 검증 + 보완 계획

작성: 2026-09-21. 대상: `AI_energy_smarthome.zip`(+ 설명 md, 발표자료 html). 목적: 이 프로젝트를 제14회 Creative Space G에 내는 것이 타당한지 검증하고, 낼 경우의 보완 계획 수립.
**확인 방법 구분**: ✔직접 열람/계산 = ZIP 내부 파일을 내가 직접 읽거나 CSV로 계산 / ◐문서 기재 = 프로젝트 문서의 주장(실기 재검증 안 함) / ✘미확인.
선행제품 조사는 별도 에이전트가 `08_prior_art_food_waste.md`에 저장(완료 시 §6에 요약 반영).

---

## 1. ZIP 실체 (✔직접 열람)

| 항목 | 내용 |
|---|---|
| 규모 | 6,605 엔트리. 이 중 실제 프로젝트 코드·문서·로그는 약 230개, 나머지는 `node_modules`(gateway 2벌), `.git`, Claude 스킬(`.agents/`, `.claude/skills` 각 131), 백업 2벌 |
| 타임라인 | 커밋 9개, 전부 작성자 1명(`eunsu`), 2026-07-28~30. 인수인계 문서에 "발표 하루 전"(07-31) 문구 → **이미 다른 대회(절전형 스마트홈 메이커톤 추정)를 위해 만든 것**. 이 추정은 카카오톡 폴더의 동의서 PDF 제목과 문서 문구에서 나온 것이고, 대회명·결과는 미확인 |
| 구성 | ESP32S3 펌웨어(센서 5종+릴레이+MQTT), Pi 게이트웨이(Node.js), 학습 데이터 로거, `ai-training/`(학습·예측 서비스), `microbe-server/server.py`(앱용 mock), 진단 스케치 다수 |
| **없는 것** | `3d-model/`, `docs/`, `esp32/` 폴더는 **비어 있음**. **Expo 앱 소스는 ZIP에 없음**(mock 서버만 있음). 실제 처리기 본체(챔버·교반 모터·히터)의 설계·사진 없음 |
| 민감정보 | `communication-module/.env`(Edge Impulse API 키), `secrets.h`(Wi-Fi 정보 포함 가능), `.mcp.json`(Supabase MCP URL)이 **ZIP에 그대로 들어 있음**. 커밋 `security: remove plaintext credentials`가 있어도 ZIP 사본에는 남아 있음 → **외부 공유 전 삭제·키 재발급 필요** |

## 2. 설명 md와 ZIP 실물의 불일치 (설명 md는 오래된 상태)

| 항목 | 설명 md(내가 앞서 읽은 것) | ZIP 실물 ✔ | 내 앞선 답변에 미친 영향 |
|---|---|---|---|
| 예측 AI | "Dummy 엔진뿐, 미구현" | **RandomForest 모델이 실제로 학습·내보내기 되어 있음**(`core_temp_model.json`, 펌웨어용 `CoreTempModel.h`, Pi용 `predict_service.py`). 모델명 `mvp-temp-regression-1.0` | **정정**: "핵심 AI 미구현"은 틀림. 다만 아래 §3처럼 검증이 없음 |
| 히터/릴레이 | "제어 로직 없음" | 릴레이 제어 코드 + Pi 측 제어 판정 함수(`decide_heater_command`)와 단위 테스트 있음 | 정정. 단 릴레이 ON 극성은 실기 미검증(07-31 문서) |
| **최신 펌웨어 설정** | (설명 md에 없음) | `SensorConfig.h`는 "새 보드 발표 복구 모드(07-31)"로 **MQ-137·MQ-138·INA219·릴레이 제어가 모두 false**. Pi의 추론은 mq137 유효를 요구하므로 이 설정에서는 추론·제어 체인이 안 돌 가능성(코드 판독 추정) | 발표 당시 시연 가능 범위는 센서(DS18B20·DHT11)+대시보드 수준이었을 가능성 |
| INA219 | 문서 간 모순 | 07-30 문서: 새 보드 D4/D5 정상. 07-31 문서: **다른 보드에서 D4/D5·D6/D7 모두 무응답** | 전력 실측은 **확정된 게 없음** |

## 3. 적대적 검증 (반박 → 근거 → 판정)

| # | 반박(심사위원·경쟁팀이 할 공격) | 근거 | 판정 |
|---|---|---|---|
| A1 | **"AI가 실제로 무엇을 하나?"** — 예측 대상이 실온의 핵심온도 | ✔ 학습 CSV 3개, 07-30 하루 약 7시간(1,947행, 정제 후 1,750행). 핵심온도 중앙값 25.5℃, 범위 23.5~25.5℃(잡음 1행 85℃). `heater_pwm_percent`·`fan_pwm_percent`·`motor_state` 전 행 NaN, `co2_valid` 전 행 False. **히터 ON 데이터·음식물·미생물 투입 데이터가 0** | **치명적**. 학습된 것은 "방 안 온도가 2분 뒤 얼마일까"이고 처리기 운전 데이터가 아님 |
| A2 | **"검증 수치가 믿을 만한가?"** | ✔ **직접 재실행으로 확인(2026-09-21)**: 학습 스크립트를 재실행해 검증 MAE 0.032℃ 재현. 그러나 ①245개 샘플이 **연속 구간 단 2개**(187개+58개, 각 약 10분 안팎)에서만 나옴 ②검증 49개는 **한 구간(07-30 09:06~09:08 UTC)** 이고 정답이 전부 25.5℃(표준편차 0) ③따라서 "2분 뒤=지금값" 기준선 MAE가 검증셋에서 **0.0000**, RF는 0.032(원 스크립트)~0.077(시드 변경) → **RF가 기준선보다 나쁨** ④구간 단위 교차검증(한 구간을 빼고 학습 후 그 구간 예측): RF MAE 0.30~0.44℃ vs 기준선 0.00~0.18℃ → **모든 경우에 기준선이 우세** ⑤DS18B20이 9-bit라 **0.5℃ 단위로만 출력**(학습 정답이 25.5·26.0 두 값뿐) ⑥Ridge는 검증 MAE 15억℃ 폭주로 폐기 | **치명적**. 검증 수치 0.032는 "정답이 안 변한 구간에서 안 변한다고 맞힘"일 뿐 학습 성과가 아님. 모델은 아직 지금값 유지보다 못함 |
| A3 | **"목표온도와 모델이 안 맞는다"** | ✔ `predict_service.py`의 제어 목표 `TARGET_TEMPERATURE_C = 37.0`, 안전한계 42℃. 그러나 모델 예측은 `pred_clip_high = 31.0`으로 잘림(`predict_service.py:181`, 학습 최대값+2℃). 예측이 31℃를 넘을 수 없으므로 "예측 온도가 목표 −0.2℃ 도달 → 조기 OFF"(`predicted_target_reached`) 분기가 **구조적으로 발동 불가** | **치명적 결함**. "AI 예측 기반 저전력 제어"의 핵심 분기가 죽어 있음. 테스트(`test_heater_control.py`)는 예측값을 손으로 넣어 통과시킨 것 |
| A4 | **"절전 효과는 얼마인가?"** | ✔ 문서가 스스로 "정량 절감률 미실측, 앱의 14,200Wh는 목업 상수"라고 명시. INA219 실측 미확정, 소비전력 데이터 0 | **치명적**. 프로젝트 이름이 "절전형"인데 절전량 근거가 0 |
| A5 | **"처리기 자체는 어디 있나?"** | ✔ 3d-model 폴더 비어 있음. 문서에도 챔버·교반·히터 설계 없음. 센서는 DS18B20(핵심온도)·DHT11·MQ-137/138(원값 ADC, ppm 환산 미확정)·릴레이 1개 | **심각**. 데모 가능한 것은 "센서+릴레이+대시보드"이고 음식물이 분해되는 장면은 없음. 미생물 분해는 시간 단위라 2분 발표에서 못 보임 |
| A6 | **"센서 품질"** | ✔ DHT11 유효 1,049/1,947(54%), MQ-138 원값이 재배선 뒤 10~18로 낮아 "open circuit 의심"(문서), CO2 센서 제거, 암모니아는 앱 목업 | **중간**. 20시간 안에 개선 가능하나 암모니아 정량 주장은 못 함 |
| A7 | **"두 파이프라인이 안 이어져 있다"** | ◐ 설명 md: 센서→MQTT→Pi 대시보드 트랙과 앱(mock) 트랙이 미연결. ✔ ZIP에 앱 소스 없음 | **중간**. 통합은 현장 20시간 과제로 적합 |
| A8 | **"이미 다른 대회에 낸 것 아닌가 / 현장 제작 대회에 완제품을 들고 오나"** | ✔ 07-31 발표 하루 전 문구, ✔ 14회는 "아이디어 시제품 제작 경진대회" + 현장 ~20h 제작 일정(00_brief). 사전 제작물 허용 여부는 **공고에 없음(미확인)** | **규정 리스크 최상위**. 운영사 서면 확인 전에는 진행 금물 |
| A9 | **"소유·저작"** | ✔ 커밋 작성자 1명. 사용자는 이 파일을 카카오톡으로 받음(경로상). 5인 팀과 이 프로젝트 팀의 관계 미확인 | **해소(2026-09-21 사용자 확인)**: 원작자 = 반도체과 3명, 여기에 전자과 2명이 합류해 5인 팀으로 이 아이디어를 살려 출품. 원작자가 팀원이므로 동의 문제 없음. 남은 것은 팀원 전원 개별 신청 |
| A10 | **"신규성"** | ✘ 선행제품 조사 진행 중(§6). 국내에 미생물 음식물 처리기 상용품이 다수 있을 가능성이 크다는 것은 가설 | 조사 결과로 확정 |
| A11 | **"공익성·서사"** | 과거 입상작은 접근성·돌봄(01·07 확인 8팀). 음식물쓰레기·악취·전력은 공익 소재이긴 하나 "당사자"가 약함 | 서사 보강 필요(§5) |

## 4. 5개 심사항목 자체평가 (주관, 각 5점 만점. 11회 항목명만 확인, 배점 미확인)

| 항목 | 현 상태(그대로 제출) | 보완 후 목표 | 이유 |
|---|---|---|---|
| 창의성 | 2 | 3 | 센서+제어 조합은 흔함. "온도 예측으로 히터 조기 차단 + 투입물 감지" 정도가 차별점 |
| 기술성 | 2 | 4 | 지금은 검증 없는 RF. 기준선 대비 이득·에너지 측정이 있으면 4 |
| 실용성 | 3 | 3~4 | 가정용 처리기는 실제 수요 있음. 단 상용품과의 차이가 조사 전이라 미정 |
| 공익성 | 2 | 3 | 음식물쓰레기 감량·악취·전력. 통계 인용으로 보강 가능 |
| 완성도 | 2 | 3~4 | 본체(챔버) 부재, 통합 미완. 20h 안에 "챔버 모형+실측 비교 실험"까지 가능하면 상승 |
| **합계(20 만점 환산)** | **약 11** | **약 16~18** | 06 Top3의 자체평가와 같은 척도가 아니므로 **직접 비교 금지**. 방향만 참고 |

**종합 판정**
- **그대로 제출: 비권장**. A1·A3·A4·A8이 각각 단독으로 탈락 사유가 될 수 있음.
- **보완 후 '재구성 제출': 조건부 가능**. 조건 = ①운영사 서면 허용 ②§5 P0·P1 완료 ③선행제품 대비 차별 문장 확보 (원작자 동의는 팀원이라 해소).
- **06 Top3 대비 우선순위**: 인터뷰 근거·사회적 서사 면에서는 06의 내소리·소리길·온마을이 앞섬. 이 프로젝트의 강점은 **하드웨어·MQTT·Pi 인프라가 이미 검증되어 있어 팀의 역량 증명이 쉽다**는 점 하나. 따라서 **"공통 코어로 재사용 + 본 아이디어 후보 중 하나"** 로 두는 것을 권고.

## 5. 보완 계획

### P0 — 다른 모든 것보다 먼저 (9/21~9/24)
1. **운영사 문의 메일**(makedot.edu@gmail.com, 070-4046-6253). 질문 4개: ①현장 제작 전 사전 제작·기존 프로젝트를 확장한 출품이 가능한가 ②가능하다면 사전 제작 부분의 공개·구분 방식 ③다른 메이커톤 출품 이력 제한이 있는가 ④부품·장비 제공 범위. **답변 전에는 이 프로젝트를 확정하지 않는다.**
2. ~~소유·동의 확인~~ **해소**(원작자 3명이 팀원). 다만 원 대회 주최 측의 재출품 제한이 있는지는 운영사 문의 ③으로 확인.
3. **민감정보 정리**: Edge Impulse API 키 재발급, `.env`·`secrets.h` 제외 후에만 팀 내 공유.

### P1 — 신청서 통과용 (9/24~10/9), 이 프로젝트를 쓴다면
1. **재프레이밍**: "절전형 스마트홈"(원 대회 주제)이 아니라 **"음식물 처리기의 악취·전력·관리 부담"** 의 공익 서사로. 통계는 `08_prior_art_food_waste.md`의 공식 출처만 사용.
2. **선행제품 대비 한 줄 차별점** 확보(§6 결과 반영). 없으면 이 프로젝트는 창의성에서 승부 불가 → Top3로 전환.
3. **당사자 근거 1건**: 미생물 처리기 실사용자 또는 아파트 관리 담당 1명 인터뷰(06의 10/12 스위치와 같은 방식).
4. 신청서에는 **"사전 준비물"과 "현장 제작 범위"를 표로 분리**해 적는다(A8 대응). 사전 준비물은 인프라(센서 노드·MQTT·Pi)로 한정하고 현장에서 만들 신규 가치를 명확히.

### P2 — 사전 검증 실험 (10/17 선발 후 ~ 11/5, 학습/연습 목적. 제출물이 아니라 현장 준비)
| 작업 | 통과 기준 | 실패 시 |
|---|---|---|
| 실제 목표 온도 대역(37℃ 부근)에서 **히터 ON/OFF·뜨거운/찬 물 투입** 데이터 6시간+ 수집, **다른 날** 별도 검증셋 | 검증셋이 학습과 다른 날 | 같은 날뿐이면 결과 주장 금지 |
| 기준선 3종 비교: 지금값 유지 / 히스테리시스만 / RF | RF가 **오버슈트·시간당 소비전력**에서 기준선보다 나음 | 못 이기면 "AI" 주장을 접고 물리모델(뉴턴 냉각)+규칙으로 서사 전환 |
| `pred_clip_high` 제거·재학습으로 A3 해소, 예측이 목표 온도에 닿는지 확인 | 조기 OFF 분기가 실제 발동 | 미발동이면 그 분기는 발표에서 빼기 |
| 소비전력 실측: INA219가 안 되면 **USB/스마트플러그형 전력계**로 대체(Wh 기록) | 규칙 제어 대비 절감률을 실측 숫자로 제시 | 절감이 없으면 "절전" 표현 삭제 |
| 챔버 모형(단열 용기+발열체+교반) 제작·측정 | 동일 조건 반복 3회 | — |

### P3 — 현장 20시간 (11/6~7)에 새로 만들 것(사전 완성분과 구분)
- 센서→Pi→앱을 **하나의 파이프라인으로 통합**(현재 분리)하고 앱 값의 mock 제거.
- 투입물 감지(급변) → 히터 조기 차단/팬·교반 제어 → 소비전력 실시간 표시.
- **A/B 시연**: 같은 조건에서 규칙 제어 vs AI 보조 제어의 Wh·오버슈트를 2분 안에 비교(사전 계측 결과는 백업 영상).
- 실패 대비: 암모니아는 "MQ 원값 추세 경고"로만, ppm 정량 주장 금지.

### 완료 판정 스위치
| 날짜 | 조건 | 미충족 시 |
|---|---|---|
| 10/2 | 운영사 답변(사전 제작물·재출품 허용) | 이 프로젝트 제외, 06 Top3로 |
| 10/9 | 선행제품 대비 차별 한 줄 + 인터뷰 1건 | 06 Top3 신청서로 전환 |
| 10/12 | 신청서 초안에서 A1·A3·A4 대응 문장이 사실로 뒷받침됨 | "AI"·"절전" 표현을 빼고 다른 서사로 |

### 팀 역할 배분안 (원작자 반도체 3 + 전자 2, 사용자 확인 2026-09-21)
| 사람 | 맡길 일 | 이유 |
|---|---|---|
| 원작자 3(반도체) | 기존 코드 소유자 → ①AI 재학습·기준선 비교(P2) ②Pi 서비스·앱 통합 ③발표·서사·통계 | 코드를 아는 사람이 데이터·통합을 맡아야 20h가 절약됨 |
| 전자 2 | ①**챔버 모형+히터·팬·교반 하드웨어**(빈 `3d-model` 대체) ②센서 결함(MQ-138 저값, DHT11 54%, INA219 무응답) 해결·**전력 실측 회로** ③릴레이 극성 검증·안전(과열 차단) | 하드웨어 결함이 A4·A5·A6의 근본 원인이므로 신규 인력의 강점과 일치 |
| 공통 | 인터뷰 1건, 신청서, 백업 영상 | — |
- 신규 2인이 **실제로 새로 만드는 것**(챔버·전력 측정·안전 회로)을 신청서의 "현장 제작 범위"로 적으면 A8(완제품 재출품 인상)에 대한 답이 된다.
- 반대 위험: 원작자 3 vs 신규 2의 정보 격차. 인수인계 문서(`docs/`)가 3종으로 서로 모순되므로(§2) **10/1까지 코드 1회 함께 빌드**해 보는 것을 권장.

## 6. 선행제품·통계 조사 결과 (요약, 상세·출처는 `08_prior_art_food_waste.md`)
※ 대부분 검색 요약·2차 출처. "못 찾음"은 "없음"이 아님.
| 항목 | 결과 |
|---|---|
| 신규성 판정 | **개념 신규성 낮음~중간**. 핵심 조합(앱 원격제어+무게+미생물 활성도+에러알림)이 **린클 그래비티W**에 이미 표방됨(2차 출처만, 공식 스펙·센서 종류 미확인) |
| 건조·분쇄식 AI 처리기 | 스마트카라 블레이드X AI, 풀무원, 헤이홈 등이 온도·무게·습도 센서+앱 보유(미생물식 아님) |
| 소비자 불만(클리앙 직접 열람) | 앱이 하루 뒤 오프라인, 월 약 50kWh 소비, 채소류 분해 불량, 교반봉 휘어짐, 미생물 기능 저하로 1~2주 사용 불가. 다나와·쿠팡·맘카페 후기는 못 봄 |
| 전력 | 린클 프라임 평균 52W·최대 130W(공식 영문몰). 52W 상시 30일 ≈ 37kWh/월(계산). 판매처 "월 몇천 원" 주장과 사용자 체감(약 50kWh)이 충돌 → **자체 실측이 곧 차별점 후보** |
| 운전 온도 | 우리 목표 37℃의 근거 못 찾음. 린클 블로그는 미생물 최적 40~50℃, 균주 특허는 생육 30~60℃·최적 45~50℃ → **37℃ 목표 재검토 필요** |
| 수상작·논문 | 미생물 처리기+IoT 수상작·국내 학생 논문·Creative Space G 역대 수상작 미확인. 해외에 센서+ML 퇴비 성숙도 예측 논문, 학생 IoT 퇴비 모니터링(온습도+SMS, 가스센서 없음) 존재 |
| 차별화 후보 4 | ①가스 센서 기반 폐루프 제어 ②투입물 기반 미생물 스트레스 경보 ③전력 최적화(실측 포함) ④오프라인에 강한 로컬 우선 UI. 상용품이 이미 하는지는 **미확정** |
| 공익성 통계 | 음식물쓰레기 ≈ 생활쓰레기 29%(정책브리핑 2022 인용). 하루 발생량·온실가스는 2010년 자료(오래됨). 악취민원 2017년 22,851건(음식물만의 수치 아님). **에너지 공식 통계 못 찾음** |
| 14회 예선 | 13회에는 예선(2025-10-25)이 있었음. 14회 여부 미확인 → 운영사 문의에 추가 |

**A10 판정 갱신**: 상용 미생물 처리기가 앱·에러알림·활성도까지 표방하므로, "센서+앱" 수준으로는 창의성 방어 불가. 방어 가능한 지점은 **①가스 폐루프(냄새) ②실측 전력·A/B 비교 ③투입물 급변 감지 후 조기 제어** 정도이며, 이 셋은 모두 P2의 실측 실험이 없으면 주장 못 함.

## 7. 이 문서의 한계
- ZIP의 `gateway-pi4`(Node.js) 소스, 펌웨어 `.ino` 전체, 발표자료 html은 슬라이드가 전부 이미지라 추출·열람 후 별도 문서(`SES_project/발표자료_전사_및_코드대조.md`)로 대조. 결론은 학습·예측·제어 코드와 CSV, 인수인계 문서 기준.
- 기준선 MAE 0.18℃는 내가 CSV로 단순 계산한 참고치(85℃ 잡음 1행 포함, 구간 정렬 방식 근사). RF의 0.032와 **동일 조건 비교가 아님**.
- 자체평가 점수는 주관.
- 07-31 "발표"의 대회명·결과, 팀 구성원은 ZIP에서 확인할 수 없음.
