yco252444-blip/gamja/md_files/07_선행제품_조사.md

# 08. 선행제품·선행사례 조사: 미생물 음식물처리기 + IoT/AI 온도·가스 제어 (최종본)

작성일 2026-09-21 / 목적: 제14회 Creative Space G AI&IoT 메이커톤(GIST, 2026-11-06~07) 출품 아이디어 차별성 적대적 검증
조사 범위: WebSearch 약 24회, WebFetch 다수. Reddit 제외. 시간 내 완료.

표기 규칙
- [직접] = WebFetch로 해당 페이지를 열어 확인(단, WebFetch는 소형 모델 요약을 거치므로 원문 그대로가 아닐 수 있음)
- [검색] = WebSearch 결과 요약만 확인, 페이지 미열람
- [광고성] = 블로그가 유료광고를 자인
- [미확인] = 못 찾음 / 차단(403) / 검색한도. "미확인"은 "없다"가 아니라 "이번 조사에서 확인 못 함"
- [계산] = 조사자가 출처 수치로 단순 계산한 값(별도 표기)
- [판단] = 조사자 의견(사실 아님)

---

## 0. 결론 요약 (먼저 읽기)

1. **핵심 조합 "미생물 처리기 + 앱/Wi-Fi + 미생물 상태 모니터링"은 이미 상용화됨.** 린클 그래비티W(RC-GT500W)가 Wi-Fi, 원격제어, 무게, 미생물 활성도, 에러 알림, 제습 기능을 표방(2차 출처). 심사위원이 검색 한 번으로 찾을 수 있는 수준.
2. "AI/IoT 음식물처리기"라는 마케팅은 스마트카라·풀무원·헤이홈이 2025년 이미 시행. 단 이들은 건조·분쇄식(미생물 아님).
3. 학술/학생 수준에서 "센서(온도·습도·NH3·CO2) + ML 퇴비 성숙도 예측"은 논문이 다수 존재(원문 열람 못 함). 학생 IoT 퇴비 모니터링(온습도+알림)도 흔함.
4. **못 찾은 것(공백 후보)**: (a) 미생물 처리기가 암모니아/가스 센서로 온도·교반·투입을 폐루프 제어한다는 상용/공개 자료, (b) 국내 대학생 대회 수상작. 둘 다 "미확인"이며 "부재의 증거 아님".
5. [판단] 개념 신규성은 낮음~중간. 차별화하려면 "앱 붙였다"가 아니라 상용품의 실제 불만(오프라인 끊김, 미생물 사망/저하, 전력, 냄새)을 정량 데이터로 해결하는 쪽이어야 함.

---

## 1. 국내 상용제품 IoT·앱·AI 현황

### 1-1. 미생물 발효 방식: 린클(한미프렉시블/비앤테크; 영문명 Reencle)이 사실상 대표
| 제품 | 스마트 기능 | 가격(출처 간 상이) | 출처 |
|---|---|---|---|
| 린클 프라임 RC-Prime300 | 공식 영문몰에 앱/Wi-Fi/온도센서 언급 없음. 평균 52W/최대 130W, 28dB, 1일 최적 약 0.7kg~최대 1kg(1.5~2.2lb), 14L, 3중 필터 | 약 568,000원(gola4u 2026) / 55~60만원대(cookpick) / 클리앙 사용자 약 55만원에 구매 | https://reencle.co/products/reencle-prime-kr [직접], https://gola4u.com/best-food-waste-disposer/ [직접], https://www.clien.net/service/board/use/18997145 [직접] |
| 린클 그래비티W RC-GT500W | Wi-Fi 스마트폰 제어(라인업 중 W만). 2차 출처 요약: 음식물 무게, 미생물 활성도, 에러 알림을 외부 확인, 작동 시작/종료 원격제어, 자동문 열림, 제습, 뚜껑열림/에러 알림, "미생물 사망 위험 사전 감지에 도움" | 80~85만원대, 보조금 후 50만원대라고 주장(보조금 조건 미검증). LG헬로렌탈 월 18,900원(36/48/60개월) | https://cookpick.kr/reencle-food-waste-disposer-recommendation-top3/ [직접], https://rental.lghellovision.net/product/detail?seq=4479 [직접, "와이파이 연결 가능"만 확인], https://itreview.kr/rinkle-gravityw-microbial-food-waste-review/ [직접, 광고성: 앱으로 원격 전원제어와 탄소절감 추적] |
| 바리미 GL-005LB, 이롭 더 그레블 | 앱/IoT 여부 미확인(nosearch 요약에 언급 없음) | 37~44만원 / 66~79만원 | https://nosearch.com/recommendation/pick/kitchen/garbage_disposer/%EB%AF%B8%EC%83%9D%EB%AC%BC%EB%B0%9C%ED%9A%A8 [직접] |
| 에코파 RFID 미생물발효식(2019) | IoT로 아파트/지자체 관리, A/S 원인 사전 파악. 온도·가스 센서 언급은 기사에 없음 | 미공개 | https://www.hankookilbo.com/news/article/201905021611072896 [직접] |

- 그래비티W 앱이 표시하는 항목의 **공식 스펙 원문(온도/가스 센서 유무 포함)은 못 봄**. 다나와 페이지(https://prod.danawa.com/info/?pcode=74005757)는 검색결과에만 있고 미열람 [미확인].
- 업소용 미생물 처리기/렌탈 제품군: [미확인(검색한도)].

### 1-2. 스마트카라·풀무원·헤이홈·루펜 (미생물이 아닌 방식)
- 스마트카라 블레이드X AI: 무게·온도·시간 분석, IoT 원격제어, 에너지 사용량 추적, 모터 10년 보증. 풀무원 그린더 자동 AI: 무게·온도 센서, 4모드. 헤이홈 스마트 AI: 무게·온도·습도, 전용 앱, UVC, 활성탄. 모두 분쇄·건조식. https://zdnet.co.kr/view/?no=20250714095045 [직접]
- 루펜 SLW-01: 열풍건조식(17~23만원대), 스마트카라 PCS-350: 분쇄건조(55~65만원대) https://nosearch.com/contents/encyclopedia/kitchen/garbage_disposer/59 [직접]. 스마트카라 최근 모델 가격 약 459,000원(400 Pro 2) https://gola4u.com/best-food-waste-disposer/ [직접]
- 스마트카라 공식몰(https://smartcara.com/) 및 다나와(https://prod.danawa.com/info/?pcode=11573513)는 검색결과에만 있고 미열람 [미확인].
- 온도+부하 감지 제어 특허(코웨이 KR101705132B1, 건조·분쇄식): https://patents.google.com/patent/KR101705132B1/ko [직접]

### 1-3. 소비자 불만
직접 읽은 것:
- **클리앙 "린클 약 2년 사용기"** [직접, 요약 경유] https://www.clien.net/service/board/use/18997145
  - 월 약 50kWh 소비(작성자 주장), 누진구간 가구엔 부담
  - 식물성/섬유질 분해 불량, 교반봉에 붙음("식물종류는 분해가 안됩니다")
  - 2년간 보증수리 2회(모두 교반봉 휨)
  - 미생물이 주기적으로 기능 저하되어 1~2주 사용 불가
  - 월 3~4만원 체감 유지비(전기+수리+미생물)
  - 장점: 탄수화물·살코기 분해 우수, A/S 우수, 초파리 문제 해결
- **클리앙 "린클 음쓰처리기 2주 사용기. 치명적 문제점 2개"** [직접, 요약 경유, 제품은 그래비티W] https://www.clien.net/service/board/park/19026450
  - 문제1: 필터 바구니 비우기 어려움(자동문이 계속 닫힘)
  - 문제2: **앱이 하루 지나면 오프라인으로 표시**, 재시작하면 잠시 복구. Wi-Fi 신호 약함
  - 댓글: 다수가 앱 문제를 확인했으나 "원격 기능은 안 쓴다"는 반응. 4개월 사용자는 연결 문제 없음
  - 미생물 배양 유지 미흡, 기름진 음식 시 모터 내구성 우려
- 벤더 공식 블로그(광고성 성격) [직접] https://reencle.co/blogs/news/reencle-troubleshooting-guide : 악취는 혐기 상태(과다 수분)에서 발생, 마늘·양파·고추 다량, 저온, 장기 무투입이 미생물 스트레스/휴면 유발. 
- 광고성 블로그 [직접] https://itreview.kr/rinkle-gravityw-microbial-food-waste-review/ : 2개월마다 처리물 비우기, 3일 초과 여행 시 전원 차단, 뚜껑 열 때 약한 흙냄새.

검색 요약으로만 본 것(원문 미열람) [검색]:
- 냄새는 식품 종류에 따라 다름, 기름진 음식 대량 투입 시 악취, 염분 높으면 분해 지연, 뼈·씨앗 제한, 처리 24시간 이상, 필터/미생물 관리 소홀 시 성능 저하. 출처 목록: https://lifenavi.co.kr/35 , https://www.ajd.co.kr/contents/basic-tip/detail/%EC%9D%8C%EC%8B%9D%EB%AC%BC_%EC%B2%98%EB%A6%AC%EA%B8%B0_%EC%B6%94%EC%B2%9C!_%EB%B6%84%EC%87%84%C2%B7%EA%B1%B4%EC%A1%B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
- 검색결과 문구: "월 전기세 약 2만원", "교반봉 모터·소음 유상 A/S"(출처 URL이 클리앙/블로그로 섞여 있어 개별 특정 못함).

못 본 것: 다나와/쿠팡 후기, 맘카페, 스마트카라 후기 = [미확인(미열람/검색한도)].

### 1-4. 전기요금·소비전력 (출처 간 상충, 사용 시 병기 필수)
- 린클 프라임: 평균 52W, 최대 130W [직접, 공식] https://reencle.co/products/reencle-prime-kr
- 미생물 방식 일반: 40~80W, 월 전기요금 4~8천원, 미생물 연 1회 교체 약 5만원 권장(1년 이상 사용도 가능) [직접] https://nosearch.com/contents/guide/kitchen/garbage_disposer
- 월 전기요금 주장이 출처마다 다름: 3,000~3,500원(cookpick, 프라임) / 1,800~2,200원(cookpick, 그래비티W) / 4~7천원(gola4u) / 사용자 체감 월 50kWh, 월 약 2만원(클리앙 및 검색 요약).
- [계산] 52W x 24h x 30일 = 약 37.4kWh/월. 사용자 "50kWh" 주장과 같은 자릿수이며, 월 3~8천원이라는 판매 사이트 수치와는 차이가 큼. 어느 쪽이 맞는지는 이번 조사로 판정 불가. 발표 시 반드시 자체 실측 필요.

---

## 2. 공모전·논문·특허 선행사례

### 2-1. 공모전/해커톤/메이커톤 수상작
- "미생물 음식물처리기 + IoT/AI 온도·가스" 수상작: **[미확인] 못 찾음** (WebSearch 3회 시도: 공모전 대상, 해커톤 수상, 캡스톤/RISS). 
- Creative Space G 역대 수상작 목록: **[미확인]**. 확인한 것은 13회 공지뿐: 예선 2025-10-25, 본선 2025-11-07~08(밤샘, 식사 제공), 3~5인 팀, 약 10팀 45명 https://www.gist.ac.kr/kr/html/sub06/060101.html?mode=V&no=219126&GotoPage=1 [직접]. 14회에도 예선이 있는지는 [미확인].
- 관련 대회 링크만 확인(내용 미열람): 제7회 GIST AI&IoT 해커톤 14팀 53명 https://m.etnews.com/20210623000092 [검색]

### 2-2. 학술 논문(해외) [검색; 원문은 ScienceDirect 403으로 미열람, 제목/요약만]
- Compost maturity prediction and gas emissions monitoring: sensor-based interpretable ML (2025) https://www.sciencedirect.com/science/article/abs/pii/S0045790625000588
- AI-driven and sensor-based composting in a connected bioreactor https://www.sciencedirect.com/science/article/pii/S2949750725000835
- Towards data-driven smart composting techniques and control systems (리뷰) https://www.sciencedirect.com/science/article/abs/pii/S0960852425014816
- Machine Learning-Based Compost Maturity Prediction Using Multisensor IoT Data (IJCIS) https://www.ijcis.net/index.php/ijcis/article/view/299
- 검색 요약: 프로토타입이 온도·상대습도·NH3·CO2를 15분 간격 측정, XGBoost/CatBoost R2 0.9912(어느 논문 수치인지 특정 못함), Arduino Mega + ESP32 무선 전송.
- **학생 프로젝트 수준** [직접] Smart Compost Guardian(Kangeyam Institute of Technology, 교수+학부생, IJERT 2025-06): DHT11 온습도 + Raspberry Pi + SMS 경보, 가스센서 없음, 목표 온도 35~65도, 습도 40~70% https://www.ijert.org/smart-compost-guardian-an-iot-based-real-time-compost-monitoring-and-alert-system
- Arduino 퇴비 모니터링 블로그 https://sustainablecatalyst.com/arduino-compost-monitoring-system/ [검색, 미열람]
- 국내 학생 논문/캡스톤(RISS 등): [미확인]

### 2-3. 특허(제어 방식 선행)
- 동명대 산학협력단 KR100848924B1(2006 출원, 2017 소멸): 배출 duct의 온습도, 악취가스 성분·농도 센싱 -> 냉동기 자동제어. 냉각·약품·소각식(미생물 아님) [직접] https://patents.google.com/patent/KR100848924B1/ko
- 코웨이 KR101705132B1: 건조로 온도+모터 부하로 회전속도 제어(건조·분쇄식) [직접] https://patents.google.com/patent/KR101705132B1/ko
- 미생물식에서 가스 센서로 제어하는 특허: [미확인](KR100861002B1, KR100893087B1 등은 열람 못 함).

---

## 3. 미생물 처리기 핵심 기술 근거 (출처 있는 수치만)

- **린클(벤더 공식 블로그)**: 미생물 최적 40~50도(104~122F), 실내온도 15도 미만이면 도달 곤란. 악취는 혐기 상태에서 황화수소 등 발생, 수분 과다/젖은 음식 과다가 원인, 교반으로 산소 재공급 [직접, 벤더 서술] https://reencle.co/blogs/news/reencle-troubleshooting-guide
- **"30~40도"라는 운전온도 가정은 근거를 못 찾음.** 상용품 공식 서술은 40~50도. 균주 특허 사례: Bacillus subtilis N0701-5(엔유씨전자, 2005) 생육 30~60도, **최적 45~50도**, 염분 최적 10% 이하(15%까지 생존), pH 최적 5.0~9.0 [직접] https://patents.google.com/patent/KR100503678B1/ko . (B. subtilis 일반 28~40도라는 검색 요약도 있으나 출처 불명 [검색]). 결론: 목표온도는 균주·제품별이며, 발표 시 "30~40도"를 쓰려면 별도 근거 필요.
- **퇴비화 일반 최적조건** [검색, 리뷰 요약]: 호열성기 45~55도, pH 5.0~7.0, 수분 50~60%, C/N 25~35 https://www.sciencedirect.com/science/article/abs/pii/S096085241731146X
- **암모니아** [검색, 원문 미열람]: 호열성(45도 초과)과 고pH(약 9)가 함께일 때 NH3 배출 시작, 질소 손실의 79~94%가 NH3(N2O 0.2~9.9%), NH3 배출은 온도 의존적(호열성 초기 지수적 증가, 중온기 선형 증가) https://www.sciencedirect.com/science/article/abs/pii/S0045653505008702 , 위 리뷰. 즉 "온도를 올리면 분해는 빨라지나 NH3 악취는 늘 수 있음"이라는 트레이드오프가 문헌에 있음(요약 수준).
- 냄새 저감(제품): 미생물 결합 -> UV 광촉매 -> 활성탄 3단(nosearch) [직접], 4중 스마트 탈취(그래비티W 블로그) [검색]. 구동 중 약간 시큼한 냄새, 종료 후 거의 없음(nosearch).
- 소비전력: 1-4절 참조(평균 52W/최대 130W, 월 37~50kWh 체감 vs 월 몇천원 주장).
- MQ-137 등 특정 센서의 암모니아 감도/교차민감 데이터: [미확인(조사 안 함)].

---

## 4. 결론

### 4-1. '새로움' 평가 ([판단]; 근거는 위 사실)
- 신규성 낮음 요소(이미 존재): 미생물식+Wi-Fi 앱+원격제어(그래비티W), 미생물 활성도/사망위험 알림 표방(2차 출처), 건조식 AI/IoT 처리기 다수, 퇴비 센서+ML 예측 논문, 학생 수준 IoT 퇴비 모니터링.
- 공백 후보(미확인이므로 "확인된 빈틈"이 아님): (a) 암모니아/가스 센서 기반 폐루프(온도·교반·환기) 제어, (b) 투입물 유형(염분/기름/마늘·양파) 기반 미생물 스트레스 예측·사전 경고, (c) 소비전력 최적화(월 37~50kWh 불만 대응), (d) 앱 오프라인/연결 불안정 대응(로컬 표시 우선). 이 중 상용품이 이미 하는지 여부는 공식 스펙 미열람이라 확정 못 함.
- 심사 관점 리스크: "온도·가스 센서 + 앱 + AI" 조합은 진부해 보일 수 있고, 20시간 안에 미생물 데이터를 쌓아 AI 효과를 입증하기 어려움(미생물 분해는 24시간 이상 소요, nosearch/검색 요약). 데모는 사전 수집 데이터 또는 시뮬레이션이 필요할 가능성 [판단].
- 종합: 개념 신규성 낮음~중간. 승부처는 "실제 소비자 불만 1~2개를 정량 해결"과 완성도.

### 4-2. 공익성 서사용 공식 통계 (최대 3개 + 참고)
1. 음식물쓰레기는 생활쓰레기 전체 발생량의 약 29%(환경부 자료 인용). 정책브리핑 국민기자 기사, 2022-12-12 [직접, 2차 인용] https://www.korea.kr/news/reporterView.do?newsId=148908913
2. 환경부 2010-12-02: 음식물쓰레기 하루 평균 1만 5000톤, 4인 가족 한 끼 온실가스 4.8kg, 4인 가구 연간 724kg, 가정 20% 감량 시 연 145kg 감축(소나무 30그루 흡수량 상응) [직접] https://www.korea.kr/news/issueQAView.do?newsId=148702729 (**2010년 자료: 최신이 아님을 명시할 것**)
3. 악취: 악취민원 2017년 22,851건, 제2차 악취방지종합시책(2019~2028)으로 2028년까지 57% 감축(약 9,825건 이하) 목표, 음식물쓰레기 RFID 종량제 의무화 포함. 환경부, 2019-01-08 [직접] https://www.korea.kr/briefing/policyBriefingView.do?newsId=148857172 (주 배출원은 축산이라는 검색 요약이 있음 [검색]; 음식물 악취만의 통계는 아님, 과장 금지)
- 참고(정책 서사): 환경부는 가정용 감량기 보급을 "한국형 순환경제 이행계획"(2021-12)에 포함, 음식물 감량·바이오가스 재활용 강화 [직접] https://www.korea.kr/news/actuallyView.do?newsId=148898147 (2022-01 환경부 설명)
- 참고(최신 수치 후보, 미검증): 2022년 음식물류 폐기물 약 500만 톤/년, 생활계 폐기물 2,304만 톤의 21.7%, 1인당 0.26kg/일 [검색 요약만; 원문 열람 실패]. 후보 출처: https://www.recycling-info.or.kr/rrs/stat/envStatDetail.do?bbsId=BBSMSTR_000000000002&nttId=1513 (2023 현황), https://www.data.go.kr/data/3070174/fileData.do. 위 29%와 분모 정의(생활폐기물 vs 생활계 폐기물)가 다를 가능성이 있으나 원문 미확인 [미확인]. 2024 생활폐기물 1,705만톤/년(전체 17,953만톤 중 9.5%) https://www.kwaste.or.kr/data/01.php [직접].
- **에너지 관련 공식 통계**: 가정용 처리기의 전력/온실가스 공식 통계는 못 찾음 [미확인]. 에너지 서사는 (1-4절의 상충 수치 때문에) 자체 실측으로 제시할 것. 역설 주의: 미생물 처리기는 상시 전력(52W x 24h)을 쓰므로 "에너지 절감"을 주장하려면 상시가열 최소화라는 개선점과 함께 말해야 함 [판단].
- 부처명은 현재 "기후에너지환경부"(mcee.go.kr)로 표기되는 페이지가 검색됨. 위 자료 게재 당시엔 환경부.

---

## 5. 한계
- WebFetch 요약 모델 경유, 광고성 후기 다수, ScienceDirect 403, 다나와/쿠팡/맘카페 후기 미열람, 대회 수상작 DB 미접근.
- 검색 한도(25회) 및 시간 제한으로 그래비티W 공식 스펙 원문, 업소용 제품, 최신 환경부 통계표(엑셀) 미확인.
