yco252444-blip/gamja/제안서작성/12_최종_신청서_제출본.md

# Oink 최종 대회 신청서 제출본 (Final Application Draft)

**대회명**: 제14회 Creative Space G (GIST)  
**과제명**: Oink (AI 기반 자율 미생물 관리 및 초절전 제어 시스템)  
**작성일**: 2026-10-09  

---

## [아이디어 설명]

최근 1인 가구의 증가에 따라 가사 노동 절감에 대한 수요가 증가하여 가정용 미생물 음식물 처리기는 하나의 필수 가전으로 자리 잡아가고 있습니다. 국내 시장 규모는 2025년 기준 약 1,850억 원으로, 전년 대비 78% 성장했습니다. 이는 약 2,000억 원 규모의 선풍기 시장과 비슷한 수준입니다.

하지만, 미생물 음식물 처리기는 가사 노동 절감을 내세운 제품임에도 불구하고 미생물 관리를 온전히 사용자에게 맡긴다는 한계가 있습니다. 또한, 내부 온도와 관계없이 미생물의 활성 온도를 유지하기 위해 히터가 24시간 내내 돌아가며 에너지를 과소비한다는 문제점이 있습니다.

저희는 이러한 문제점을 해결하기 위해 미생물의 상태를 스스로 관리해주는 "AI 기반 자율 미생물 관리 시스템"을 설계하였습니다. 이 시스템을 통해 미생물 음식물 처리기에 대한 사용자 부담을 줄이고 진입장벽을 낮추는 역할을 할 수 있을 것이라 생각합니다.

이 시스템은 미생물 관리와 음식물 처리기의 히터 발열을 어플과 연동하여 제어할 수 있도록 합니다. 

먼저, 미생물 관리 기능은 미생물이 음식물을 분해할 때 방출하는 이산화탄소의 양을 측정하여 분해 활성도를 분석합니다. 측정된 수치가 기준치를 벗어나면 사용자에게 알림을 보내고 센서값들을 분석하여 최적의 해결방법을 제시합니다. 이를 통해 사용자가 미생물의 상태 변화를 조기에 파악하고 대응하여, 미생물 사멸 위험을 줄일 수 있습니다.

다음으로, 히터 발열 제어 기능은 음식물 내부의 온도를 반영하여 히터 작동을 정밀하게 조절합니다. 기존의 공기 온도나 표면 온도만 측정하는 방식으로는 음식물 내부의 실제 온도를 파악하기 어렵기에, 필요한 수준 이상으로 히터가 가동될 수 있다는 단점이 있습니다. 이러한 문제점을 해결하기 위해 저희 시스템에서는 심부 온도 센서를 활용해 미생물 내부의 온도를 측정하여 보다 정밀한 제어를 가능하게 합니다. 이를 통해 미생물 활동에 적합한 온도를 유지하면서 과도한 가열과 불필요한 전력 소비를 줄이고자 합니다.

이 시스템에서는 AI가 복잡한 관리를 전담함으로써, 사용자의 미생물 관리에 대한 부담을 덜어주고 최적화된 전력 소비로 전기 요금 부담까지 낮출 수 있습니다.

---

## [프로젝트 설명]

최근 1인 가구의 증가에 따라 가사 노동 절감에 대한 수요가 급증하며, 가정용 미생물 음식물 처리기는 하나의 필수 가전으로 자리 잡아가고 있습니다. 국내 미생물 음식물 처리기 시장 규모는 2025년 기준 약 1,850억 원으로 전년 대비 78% 성장했으며, 이는 약 2,000억 원 규모의 선풍기 시장에 육박하는 수준입니다. 그러나 미생물 음식물 처리기는 가사 노동 절감을 표방함에도 불구하고, 내부 미생물 관리를 온전히 소비자의 경험과 감에만 전가한다는 치명적 한계가 있습니다. 

또한, 챔버 내부의 실제 발열 상태와 무관하게 미생물 활성 온도를 유지한다는 명목으로 히터가 24시간 내내 상시 가동되어 과도한 전기요금과 에너지 과소비를 유발합니다. 기존의 공기 온도나 표면 온도만 측정하는 방식은 음식물 내부의 실제 온도를 파악하기 어려워 불필요한 과가열을 일으키는 한계가 있었습니다. 저희는 이러한 문제점을 근본적으로 해결하기 위해 **"AI 기반 자율 미생물 관리 및 초절전 제어 시스템"**을 설계하였습니다. 

본 시스템은 미생물 관리와 히터 발열 제어를 모바일 앱과 연동하여, 사용자의 부담을 줄이고 미생물 가전으로의 진입장벽을 획기적으로 낮추는 역할을 합니다. 

**첫째, 미생물 자율 관리 기능**은 NDIR 방식 이산화탄소 센서(CM1106S4)와 악취 가스 센서(MQ-137/MQ-138)를 통해 미생물이 유기물을 분해할 때 방출하는 $CO_2$ 호흡 대사량과 부패 가스를 정밀 측정합니다. 수집된 센서 데이터는 ESP32-S3의 Hardware UART(Serial1)로 고속 수집된 후, 보드 간 Wi-Fi STA 기반 MQTT 통신 및 ArduinoJson 라이브러리를 통해 통합 전송되며, TensorFlowLite_ESP32 기반 온디바이스 AI 알고리즘으로 실시간 분해 활성도를 분석합니다. 또한 측정값이 기준치를 벗어나면 mqtt_client 통신 기반의 flutter_local_notifications 라이브러리를 통해 사용자에게 즉각 알림을 송신하고 최적의 해결책을 제시합니다. 이를 통해 사용자가 미생물의 상태 변화를 조기에 파악하고 대응하여 미생물 사멸 위험을 사전에 방지합니다. 동시에, 앱 내 rive 라이브러리로 구동되는 '반려 미생물 캐릭터 UI'가 생체 상태를 1:1 표정 모션으로 치환하여, 스마트 가전 취약계층도 직관적으로 기기 상태를 인지하도록 돕습니다.

**둘째, 히터 정밀 발열 제어 기능**은 미생물 내부에 삽입되는 심부 온도 센서(DS18B20)를 활용하여 단순히 표면 공기가 아닌 미생물 실효 영역의 심부 온도를 직접 측정합니다. OneWire 및 DallasTemperature 라이브러리로 수집한 심부 온도 변화율($dT/dt$)을 추적하고, Adafruit_INA219 라이브러리를 통해 히터와 모터의 실시간 전용 전력 소비량을 모니터링합니다. 미생물이 스스로 열을 내는 '자가발열' 구간이 감지되면 ESP32-S3의 Ticker 및 esp_timer 라이브러리를 활용해 히터 전력을 제어하는 절전 모드를 실행합니다. 이를 통해 미생물 활동에 최적화된 온도를 정밀하게 유지하면서 불필요한 히터 가동을 차단하여 기존 대비 소비 전력을 크게 절약할 수 있습니다.

**셋째, 네트워크 및 하드웨어 안정성을 위해 'ESP-NOW 직결망과 클라우드 게이트웨이'가 결합된 분산 엣지 아키텍처를 확립**하였습니다. 기기 내부의 보드 간(센서 노드 - 제어 노드 - UI 노드) 데이터 교환은 외부 공유기가 전혀 필요 없는 ESP32 전용 초저지연 무선 직결 프로토콜인 **『ESP-NOW』**를 적용하여, 1ms(0.001초) 이내의 초고속 반응성과 100% 독립적인 안전 제어를 보장합니다. 동시에 총괄 UI 노드가 **'단일 엣지 게이트웨이'** 역할을 수행하여, 백그라운드 Wi-Fi STA(Station) 모드로 외부 네트워크를 감지하고 상시 컨테이너 호스팅 플랫폼인 Railway(내장 MQTT 브로커 Aedes 및 Node.js 백엔드)로 내부 상태 데이터를 발행합니다. 이를 통해 Vercel 기반 React 웹 대시보드와 실시간 연동되어 별도 앱 설치 없이 전 세계 어디서든 모바일·PC 브라우저로 기기 상태를 모니터링할 수 있습니다. 특히 외부 인터넷이나 Wi-Fi가 단선되더라도 제어 루프가 통신과 완벽히 격리된 **'로컬 자율 제어(Edge Autonomy)'가 100% 유지**되어 미생물 사멸을 방지합니다. 아울러 소프트웨어 오류가 발생하더라도 차단기 역할을 하는 3가지 물리 안전 부품(과전류 퓨즈, 바이메탈 서모스탯, 온도 퓨즈)이 전원을 직접 끊어주어 과열과 화재 위험을 2중·3중으로 완벽하게 막아냅니다.

결과적으로 본 시스템은 보드, 히터, 센서를 포함한 약 5만 원 상당의 강력한 원가 경쟁력을 바탕으로, 복잡한 관리는 인공지능과 하드웨어가 스스로 수행하고 사용자는 직관적인 캐릭터 교감만으로 가사 노동의 자유를 누리게 합니다. 나아가 완제품 가전 제조사 대상 B2B 초절전 AI 제어 모듈 라이선싱 및 상용화 진입이 즉시 가능한 차세대 스마트 홈 에코 가전의 새로운 기준을 제시합니다.
