yco252444-blip/gamja/proposal/index.html

✨ 서비스 제안서 · AI 기반 스마트 홈 에코 가전

# 🦠 AI 기반 자율 미생물 관리 시스템

미생물 관리와 음식물 처리기의 히터 발열을 어플과 연동하여 제어합니다. AI가 미생물의 상태를 스스로 관리해 사용자의 부담을 줄이고, 심부 온도 기반 정밀 제어로 불필요한 전력 소비까지 줄여 미생물 음식물 처리기의 진입장벽을 낮춥니다.

💡 "AI가 복잡한 관리를 전담함으로써, 사용자의 미생물 관리에 대한 부담을 덜어주고 최적의 전력 제어로 전기 요금 부담까지 낮춥니다."

TEAM

오잉크 OINK

이은수 이민서 김혜주 오유찬 고은표

핵심 기술

📡 IoT 센서 · 원격 연동 🧠 온디바이스 AI 진단 🔥 자체 히터 정밀 제어 👾 반려 미생물 캐릭터 키우기

01

## 배경 및 시장 (Background & Market)

최근 1인 가구의 증가에 따라 가사 노동 절감에 대한 수요가 증가하여, 가정용 미생물 음식물 처리기는 하나의 필수 가전으로 자리 잡아가고 있습니다.

1,850억 원

2025년 국내 시장 규모

+78%

전년 대비 성장률

≈ 선풍기

약 2,000억 원 규모의 선풍기 시장과 비슷한 수준

미생물 음식물 처리기 (2024, 추정)약 1,040억

미생물 음식물 처리기 (2025)1,850억

선풍기 시장약 2,000억

※ 2024년 수치는 2025년 규모와 성장률(78%)로 역산한 추정값

02

## 문제 정의 (Problem Definition)

### 🧫 1) 미생물 관리를 온전히 사용자에게 의존

- 가사 노동 절감을 내세운 제품임에도 불구하고, 미생물 관리를 온전히 사용자에게 맡긴다는 한계가 있습니다.
- 사용자는 미생물의 상태 변화를 알기 어려워 대응이 늦어지고, 결국 미생물이 사멸하는 위험에 노출됩니다.

### ⚡ 2) 24시간 돌아가는 히터의 에너지 과소비

- 내부 온도와 관계없이 미생물의 활성 온도를 유지하기 위해 히터가 24시간 내내 돌아갑니다.
- 공기 온도나 표면 온도만 측정하는 방식으로는 음식물 내부의 실제 온도를 파악하기 어려워, 필요한 수준 이상으로 히터가 가동될 수 있습니다.

03

## 솔루션 개요 (Solution Overview)

이러한 문제점을 해결하기 위해 미생물의 상태를 스스로 관리해주는 "AI 기반 자율 미생물 관리 시스템"을 설계하였습니다. 이 시스템을 통해 미생물 음식물 처리기에 대한 사용자 부담을 줄이고 진입장벽을 낮추는 역할을 할 수 있습니다.

### 🌱 미생물 관리 기능

미생물이 음식물을 분해할 때 방출하는 이산화탄소의 양을 측정하여 분해 활성도를 분석합니다. 측정된 수치가 기준치를 벗어나면 사용자에게 알림을 보내고, 센서값들을 분석하여 최적의 해결방법을 제시합니다. 이로써 사용자가 미생물의 상태 변화를 조기에 파악하고 대응하여, 미생물의 사멸 위험을 줄일 수 있습니다.

### 🔥 히터 발열 제어 기능

음식물 내부의 온도를 반영하여 히터 작동을 정밀하게 조절합니다. 심부 온도 센서를 활용해 미생물 내부의 온도를 측정하여 보다 정밀한 제어를 가능하게 합니다. 이를 통해 미생물 활동에 적합한 온도를 유지하면서 과도한 가열과 불필요한 전력 소비를 줄입니다.

### 🫧 왜 CO₂로 미생물 활성도를 알 수 있나

음식물(유기물) + 산소 → CO₂ + 물 + 열 미생물이 음식물을 분해하는 과정은 곧 '호흡'입니다. 분해가 활발할수록 같은 시간에 더 많은 CO₂와 열이 나옵니다.

그래서 CO₂ 발생 속도는 퇴비화 분야에서도 미생물 호흡 활성도를 재는 대표 지표로 쓰입니다. Oink는 CO₂ 농도의 절댓값이 아니라 증가 속도(ppm/분)를 보고, 심부 온도와 가스 센서를 함께 읽어 아래처럼 상태를 구분합니다.

🟢 활발히 분해 중 음식물 투입 뒤 CO₂가 빠르게 오르고, 심부 온도도 스스로 오릅니다. CO₂ 상승 ↑ · 심부 온도 ↑ · 가스 낮음

🟡 활성 저하 먹이가 부족하거나 온도·수분이 맞지 않아 호흡이 줄어든 상태입니다. CO₂ 상승 거의 없음 · 심부 온도 ↓

🔴 부패(혐기화) 의심 산소가 부족해 미생물이 제대로 숨 쉬지 못하고 부패 가스가 생깁니다. CO₂ 정체 · 부패 가스 ↑

✅ 분해 완료 분해할 먹이가 줄어들면 CO₂가 다시 기준선으로 내려옵니다. CO₂ 기준선 복귀 · 히터 대기 전환

※ 상태별 기준값(ppm/분, ℃)은 시제품 실측 데이터로 정합니다. 현재 값은 확정 전입니다.

### 📱 어플에서 할 수 있는 것

📊 실시간 상태 확인

CO₂ · 부패 가스 · 심부 온도 · 소비 전력을 뚜껑을 열지 않고 언제 어디서든 확인

📝 한 줄 요약 진단 카드

LLM 없이, 센서값과 온디바이스 AI 판단 결과를 정해진 규칙으로 한 줄 진단 카드로 요약

"분해 활성도 정상 · 수분이 조금 많아요"

🔔 이상 알림 · 해결책 안내

기준치를 벗어나면 푸시 알림과 함께 "음식물 투입 줄이기" 같은 구체적인 해결 방법을 안내

👾 반려 미생물 키우기

미생물 상태에 따라 표정과 움직임이 바뀌는 캐릭터를 돌보며 자연스럽게 관리 습관 형성

⚡ 전력 사용량 확인

히터 가동 시간과 절전 모드로 아낀 전력을 한눈에 확인

### 📲 앱 화면 목업

9:41▂▄▆ ▮

OINK.⚙

미생물이
건강하게 활동하고 있어요!

정상 상태

🌡 심부 온도42.3℃

☁ CO₂ 농도820ppm

💧 부패 가스0.04ppm

⚡ 오늘 사용 전력0.12kWh

🏠📊🔔👤

① 홈 — 반려 미생물 + 실시간 센서값

9:41▂▄▆ ▮

알림⚙

숨쉬기가 조금 힘들어요

부패 의심 · 사전 경고

📝 한 줄 진단 CO₂ 상승이 멈추고 부패 가스가 늘고 있어요. 수분이 많고 산소가 부족한 것 같아요.

✅ 이렇게 해 주세요

1. 오늘은 음식물 투입을 쉬어 주세요
2. 물기 많은 음식은 짜서 넣어 주세요
3. 교반을 자동으로 늘렸어요

🏠📊🔔👤

② 이상 알림 — 사멸 전 경고 + 해결책

9:41▂▄▆ ▮

전력 리포트⚙

히터 가동5.1시간/일

절전 모드18.9시간/일

최근 7일 히터 전력 (Wh)

24시간 가동 시Oink 제어

⚡ 이번 주 아낀 전력 INA219로 실제 측정한 히터 전력 기준으로 계산해요.

🏠📊🔔👤

③ 전력 리포트 — 실측 전력 비교

※ 앱 화면은 디자인 목업이며, 표시된 숫자와 그래프는 화면 구성을 보여주기 위한 예시 값입니다.

04

## 프로젝트 상세 설명 (Project Details)

본 시스템은 미생물 자율 관리와 히터 정밀 발열 제어를 모바일 앱과 연동하여, 사용자의 관리에 대한 부담을 줄이고 미생물 가전으로의 진입장벽을 획기적으로 낮춥니다.

🛠️ 자체 제어 기능 — 앱은 상태 확인과 알림을 담당할 뿐, 실제 제어는 기기가 스스로 수행합니다. ESP32-S3가 센서값을 직접 판단해 히터 ON/OFF · 절전 모드 전환 · 교반 모터 구동 · 과열/과전류 시 전원 차단까지 자체적으로 제어하므로, 사용자가 조작하지 않아도 미생물에게 최적의 환경이 유지됩니다.

① 미생물 자율 관리 기능

Sensing · On-Device AI · App

정밀 센서로 미생물이 유기물을 분해할 때 방출하는 CO₂ 호흡 대사량과 부패 가스를 정밀 측정하고, 온디바이스 AI가 분해 활성도를 실시간으로 추정·분석합니다.

사용 부품 (하드웨어 · AI)

CM1106S4 (NDIR 방식 CO₂ 센서) 미생물의 CO₂ 호흡 대사량 정밀 측정

MQ-136 (부패 악취 센서) 유기물 부패 시 발생하는 부패 가스 측정

ESP32-S3 (메인 제어장치) 하드웨어 전용 통신 포트로 센서 데이터 고속 수집

TensorFlowLite_ESP32 기기 내부에서 작동하는 초경량 온디바이스 AI 모델

동작 순서

1. 측정CO₂ · 부패 가스 정밀 측정

→

2. 수집·전송ESP-NOW로 게이트웨이 보드에 수집, JSON 정돈 후 Wi-Fi STA·MQTT 통합 전송

→

3. AI 분석분해 활성도 실시간 추정·분석

→

4. 알림·해결책기준치 이탈 시 스마트폰 알림으로 최적 해결책 즉시 안내

사용자 앱 기능

🔔 사전 방지 알림

측정값이 기준치를 벗어나면 미생물 상태 이상으로 판단, 실시간 앱 통신으로 해결책을 안내하여 미생물 사멸 위험을 사전에 방지

👾 반려 미생물 캐릭터 UI

모션 애니메이션 엔진(Rive 라이브러리)으로 미생물 상태에 따른 표정과 움직임을 표현, 디지털 취약계층도 직관적으로 기기 상태 인지

📝 한 줄 요약 진단 카드

LLM을 사용하지 않고, 센서값과 AI 판단 결과를 규칙 기반 템플릿으로 조합해 현재 상태를 한 줄로 요약 — 가볍고 결과가 일관됨

② 히터 정밀 발열 제어 기능

Core Temp · Power Saving

미생물 내부에 삽입되는 심부 온도 센서(DS18B20)를 활용하여, 단순히 표면 공기가 아닌 미생물 실효 영역의 심부 온도를 직접 측정합니다.

사용 부품

DS18B20 (심부 온도 센서) 미생물 내부에 삽입해 실효 영역의 심부 온도 측정

INA219 (전력 측정 센서) 히터·모터에 흐르는 전류를 읽어 실시간 소비 전력 측정

ESP32-S3 (메인 제어장치) 온도 변화를 판단하고 히터 전원을 직접 켜고 끔

동작 순서 (단계별 사용 라이브러리)

1. 심부 온도 측정미생물 내부 온도를 주기적으로 읽고 변화율(dT/dt)을 계산 OneWire DallasTemperature DS18B20 센서값을 읽어오는 라이브러리

→

2. 소비 전력 확인히터·모터가 지금 실제로 쓰는 전력을 실시간 모니터링 Adafruit_INA219 INA219 센서로 전력값을 읽어오는 라이브러리

→

3. 자가발열 감지히터를 꺼도 온도가 유지·상승하면 미생물이 스스로 열을 내는 '자가발열' 구간으로 판단

→

4. 절전 모드 실행정해진 시간 간격으로 히터를 켜고 끄며 가동 시간을 줄여 히터 전력을 제어 Ticker esp_timer 히터 ON/OFF 주기를 정확히 맞춰주는 타이머 라이브러리

이를 통해 미생물 활동에 최적화된 온도를 정밀하게 유지하면서 불필요한 히터 가동을 차단하여 기존 대비 소비 전력을 크게 절약할 수 있습니다.

③ 분산 엣지-클라우드 연동 구조

Network · Hardware Stability

외부 인터넷이 끊겨도 히터 제어가 멈추지 않도록 보드 간 내부 통신과 외부 클라우드 통신을 분리한 분산 엣지-클라우드 연동 구조를 확립하였습니다.

📡 보드 간 통신 (ESP-NOW)

기기 내부 보드끼리는 ESP-NOW 무선 직결 프로토콜로 교신. 공유기나 Wi-Fi 비밀번호 없이 1:1로 1ms(0.001초) 만에 초고속 데이터 교환

🔗 단일 엣지 게이트웨이

보드 3대 중 1대만 게이트웨이 역할 수행. 외부 Wi-Fi 감지 시 Wi-Fi STA(Station) 모드로 접속하여 MQTT 프로토콜로 데이터 발행

☁️ Railway · Vercel 클라우드

상시 호스팅 플랫폼 Railway의 Aedes MQTT 브로커와 Node.js 백엔드를 거쳐 Vercel React 웹 대시보드로 실시간 스트리밍, 어디서든 모바일·PC로 모니터링

🛡️ 로컬 자율 제어 (Edge Autonomy)

집 공유기 전원이 꺼지거나 인터넷이 단선되어도 ESP-NOW 기반 내부 센서-히터 제어 루프는 100% 정상 작동하여 미생물 사멸 방지

데이터 흐름

ESP-NOW보드 간 1ms 무선 직결 (기기 내부)

→

Wi-Fi STA · MQTT단일 엣지 게이트웨이가 데이터 발행

→

RailwayAedes MQTT 브로커 + Node.js

→

VercelReact 웹 대시보드 (모바일·PC)

05

## 통합 제어 알고리즘 (Control Algorithm)

센서 수집 · AI 분석 · 정밀 제어 · 물리 안전 · 앱/클라우드 연동의 4단계 Task가 하나의 피드백 루프로 반복됩니다. 물리 안전 제어는 앱·클라우드 연결 여부와 무관하게 항상 우선 실행됩니다.

### ① 센서 수집 및 데이터 검증

CO₂ · 악취 가스 · 심부 온도 · 소비전력을 수집하고 필터링·누락·고정값·비정상 범위를 검사한 뒤 JSON으로 생성합니다.

### ② AI 미생물 분석 및 히터·모터 제어

온디바이스 AI가 분해 활성도와 부패 위험을 판단하고, 목표 온도와 심부 온도를 비교해 자가발열 시 절전 모드로 전환합니다.

### ③ 물리 안전 상태 점검

과전류·과열 시 즉시 전원 차단, 센서 이상 시 격리 후 추정 제어, 구동부 이상 시 정지·복구, 통신 단절 시 NVS 기반 로컬 자율 제어를 유지하며, 모든 점검 결과를 기록해 로컬 제어에 반영합니다.

### ④ 앱·클라우드 연동

점검 결과를 1~5분 주기로 서버·웹 대시보드에 전송하고, 캐릭터 상태 반영 및 필요 시 푸시 알림을 보냅니다.

AI 기반 자율 미생물 관리 시스템 통합 제어 알고리즘 순서도

AI 기반 자율 미생물 관리 시스템 — 통합 제어 알고리즘 순서도

### 🧠 AI가 실제로 하는 일

AI의 역할은 "지금 미생물이 어떤 상태인가"를 판정하는 것입니다. 센서값 하나만 보면 헷갈리는 상황(예: CO₂가 낮은 게 분해 완료인지, 미생물이 약해진 건지)을 여러 센서의 최근 흐름을 함께 보고 구분합니다.

#### 입력 (최근 30~60분 흐름)

- CO₂ 증가 속도 (ppm/분)
- 심부 온도와 변화율 (dT/dt)
- 부패 가스 농도 추세
- 히터 ON 비율 · 소비 전력
- 마지막 투입 후 경과 시간

→

#### 모델 (ESP32-S3 안에서 실행)

- TensorFlow Lite 초경량 분류 모델
- 시제품 운전 로그로 학습 (투입·과습·과열 상황 라벨링)
- 인터넷 없이 기기 안에서 수 밀리초 안에 추론

→

#### 출력 → 동작

- 활발 → 자가발열 활용, 히터 듀티 낮춤
- 활성 저하 → 목표 온도 유지 + 알림
- 부패 의심 → 교반 늘림 + 해결책 알림
- 분해 완료 → 절전 대기

🛡️ AI가 하지 않는 것 — 과열·과전류 차단 같은 안전 판단은 AI에 맡기지 않습니다. 정해진 규칙과 하드웨어 차단 장치(서모스탯·퓨즈)가 항상 우선하며, AI 판정이 틀려도 위험한 상황으로 이어지지 않게 설계합니다.
📏 AI를 쓰는 이유를 숫자로 확인 — 같은 데이터로 단순 규칙(기준치 비교)과 AI 모델의 상태 판정 정확도를 비교하고, AI가 더 나을 때만 채택합니다.

06

## 절전 효과 검증 실험 (Verification Plan)

"전력을 아낀다"는 주장을 추정이 아닌 실측으로 보여주기 위해, 전력 측정 센서(INA219)로 히터가 실제로 쓴 전력을 기록하고 기존 방식과 나란히 비교합니다.

#### A. 기존 방식 (비교군)

공기 온도 기준으로 설정 온도를 유지하며 히터를 24시간 운전합니다. 시중 제품의 동작 방식을 재현합니다.

#### B. Oink 제어 (실험군)

심부 온도·CO₂ 기반으로 자가발열 구간과 분해 완료를 감지해 히터를 줄입니다.

### 🔬 실험 방법

- 같은 크기의 단열 챔버 2개에 같은 미생물 배양토와 같은 양의 음식물을 넣습니다.
- 두 챔버 모두 INA219로 히터 전압·전류를 1초마다 읽어 전력을 누적(Wh)합니다.
- 같은 시간 동안 동시에 운전하고, 투입 시점도 맞춥니다.
- INA219 값은 별도 전력계(멀티미터)로 교차 확인해 측정 오차를 함께 표기합니다.

### 📊 비교 지표

- 누적 히터 전력량 (Wh) — 절전 효과의 핵심 지표
- 히터 가동률 (%) — 하루 중 히터가 켜져 있던 시간
- 심부 온도 유지 — 적정 온도 범위를 벗어난 시간
- 분해 활성도(CO₂) — 전기를 아끼느라 미생물 활동이 떨어지지 않았는지 확인

📈 결과는 앱의 전력 리포트 화면과 대회 현장 대시보드에서 두 챔버의 누적 전력 그래프로 실시간 공개합니다. 실험 예정 · 결과 미측정

07

## 기대 효과 & 차별성 (Impact & Differentiation)

사용자 가치

### 관리 부담 제로

복잡한 관리는 인공지능과 하드웨어가 스스로 수행하고, 사용자는 직관적인 캐릭터 교감만으로 가사 노동의 자유를 누립니다.

원가 경쟁력

### 최소 5만 원 상당

보드, 히터, 센서를 포함한 최소 5만 원 상당의 강력한 원가 경쟁력을 갖추었습니다.

사업화

### B2B 초절전 AI 제어 모듈

완제품 가전 제조사 대상 B2B 초절전 AI 제어 모듈 라이선싱 및 상용화 진입이 즉시 가능합니다.

### 🆚 기존 제품과의 차별성

### 기존 제품

- 단순 무게 감지 센서로 투입된 음식물의 양만 계산
- 미생물 내부가 아닌 공기 온도만 측정해 실제 상태와 차이가 큼
- 미생물 상태를 알 수 있는 방법이 없어, 미생물이 죽은 뒤에야 문제를 알게 됨

### Oink 시스템

- 심부 온도 센서로 미생물이 실제로 있는 곳의 온도를 측정
- CO₂ 센서로 미생물의 호흡(분해 활성도)을 직접 확인
- 가스 센서로 부패 징후를 잡아, 미생물이 죽기 전에 상태를 파악하고 해결책 안내

구분 | 기존 미생물 음식물 처리기 | AI 기반 자율 미생물 관리 시스템
미생물 관리 | 사용자에게 온전히 의존 | CO₂·부패 가스 기반 온디바이스 AI 진단, 기준치 이탈 시 해결책 알림
투입·분해 파악 | 무게 감지 센서로 투입량만 계산 | CO₂ 발생 속도로 실제 분해 진행과 완료 시점 파악
미생물 상태 | 알 방법 없음, 사멸 후에야 인지 | 활발 · 활성 저하 · 부패 의심 · 분해 완료를 구분해 사멸 전 경고
온도 측정 | 공기 온도·표면 온도 | DS18B20 심부 온도 및 변화율(dT/dt) 추적
히터 제어 | 내부 온도와 무관한 24시간 가동 | 자가발열 구간 감지 시 절전 모드, INA219 실시간 전력 모니터링
상태 확인 | 뚜껑을 열어 직접 확인 | 반려 미생물 캐릭터 UI(Rive) + 웹 대시보드(어디서든 접속)
통신 장애 | — | 로컬 자율 제어(Edge Autonomy) 100% 유지

🏠 본 시스템은 차세대 스마트 홈 에코 가전의 새로운 기준을 제시합니다.

AI 기반 자율 미생물 관리 시스템 · 서비스 제안서 · 팀 오잉크

미생물 자율 관리 × 히터 정밀 발열 제어 × 분산 엣지-클라우드 연동
