yco252444-blip/gamja/Oink_분해도_부품명.pdf

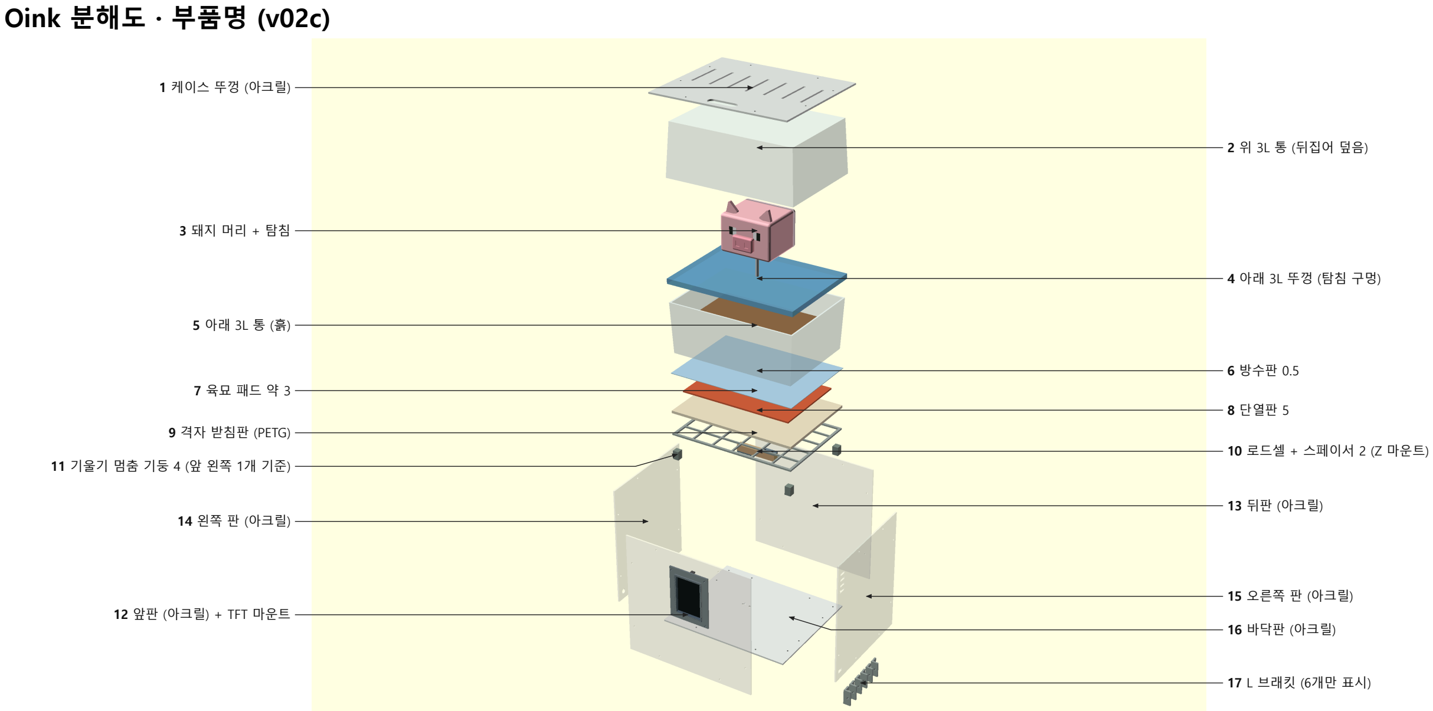
[picture p2: figure]
Oink 분해도 · 부품명 (v02c); 1 케이스 뚜껑 (아크릴); 9 격자 받침판 (PETG); 11 기울기 멈춤 기둥 4 (앞 왼쪽 1개 기준); 14 왼쪽 판 (아크릴); 12 앞판 (아크릴) + TFT 마운트; 2 위 3L 통 (뒤집어 덮음); 6 방수판 0.5; 8 단열판 5; 10 로드셀 + 스페이서 2 (Z 마운트); 13 뒤판 (아크릴); 15 오른쪽 판 (아크릴); 16 바닥판 (아크릴); 17 L 브래킷 (6개만 표시)
