yco252444-blip/gamja/cad/previews/hires/v02_분해도_hi.png

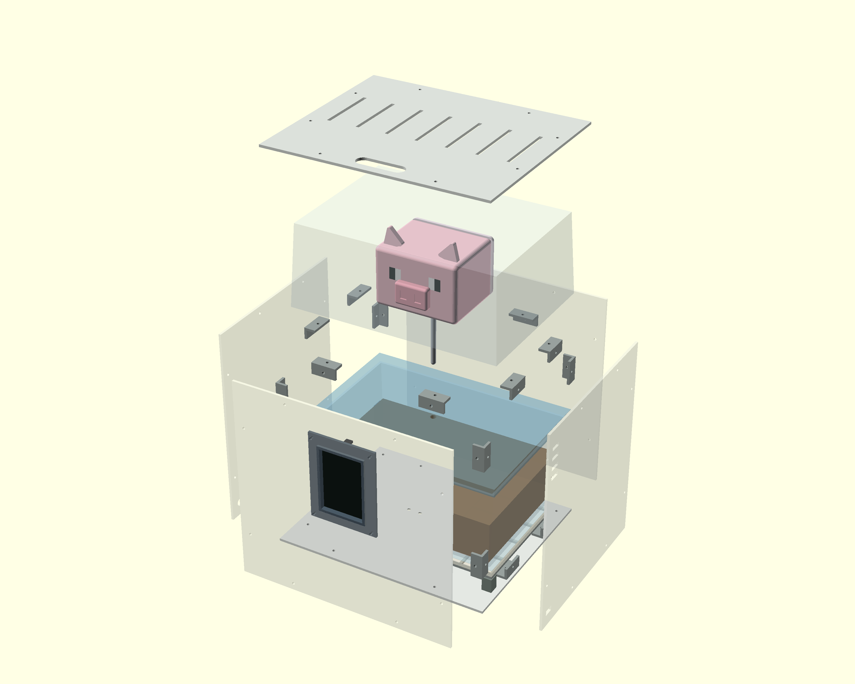
cad/previews/hires/v02_분해도_hi.png
