yco252444-blip/gamja/cad/previews/hires/v02c_분해도_부품명_hi.png

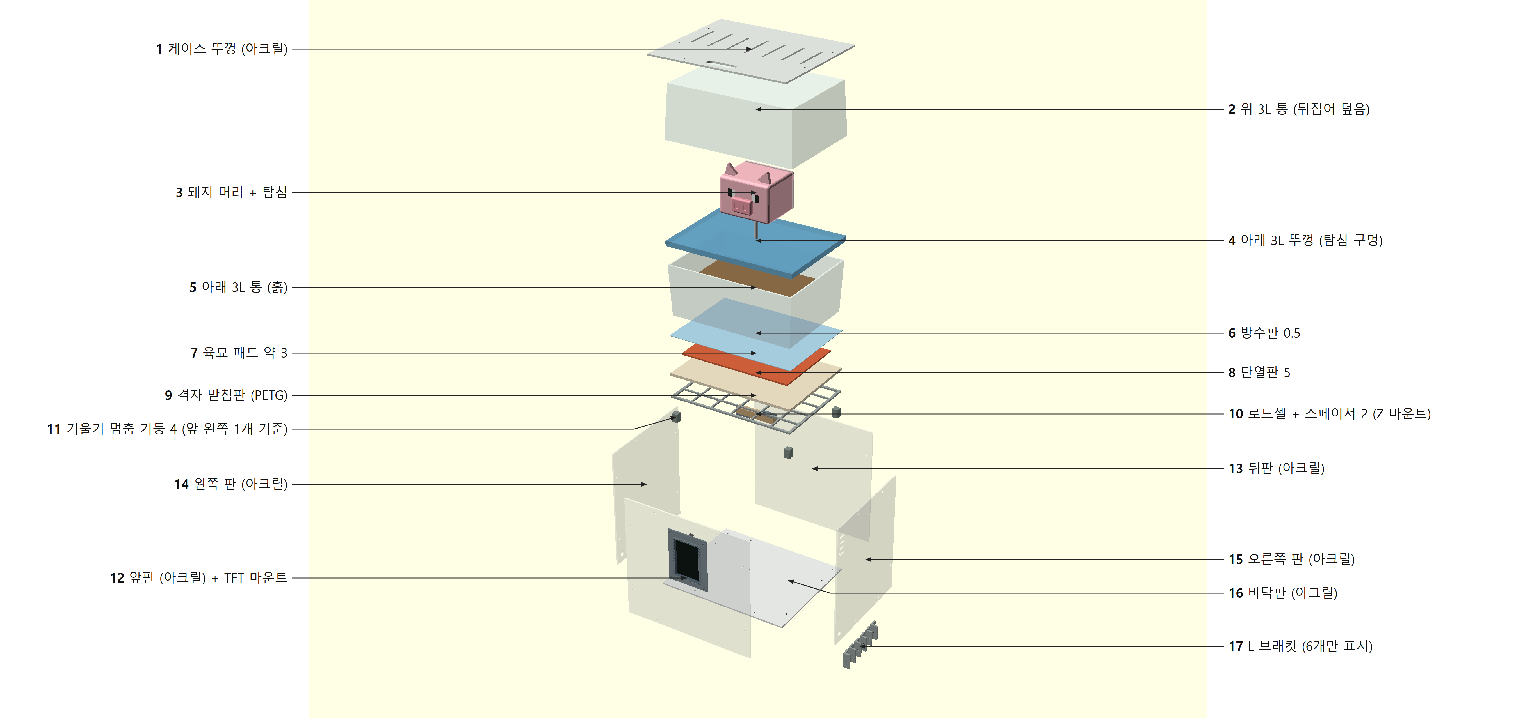
cad/previews/hires/v02c_분해도_부품명_hi.png
