yco252444-blip/gamja/cad/previews/v03_앞판.png

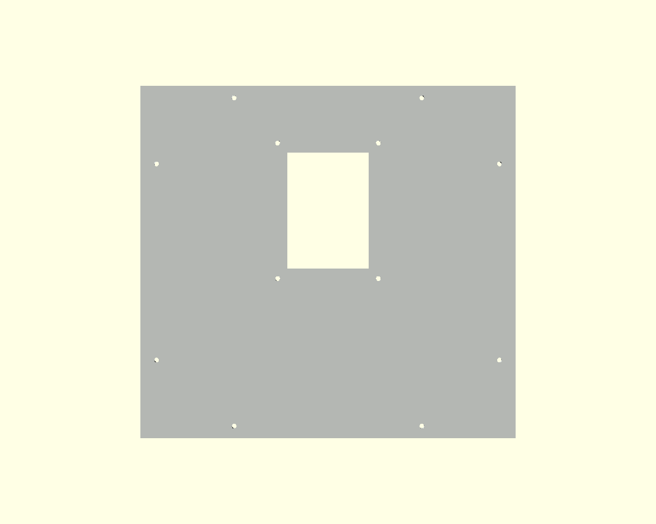
cad/previews/v03_앞판.png
