yco252444-blip/gamja/cad/previews/v04_뒤판.png

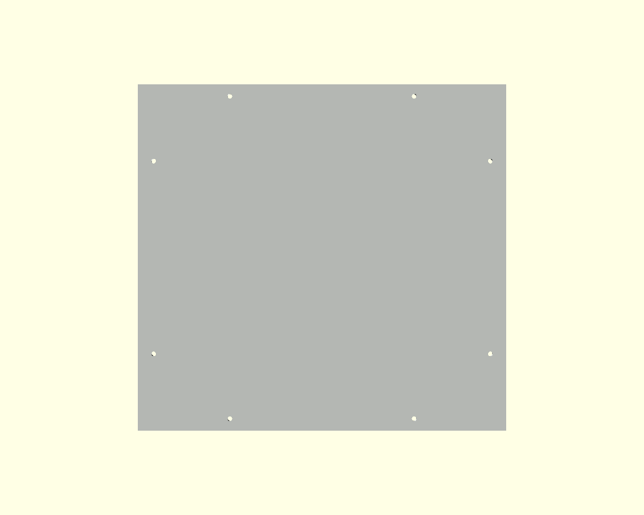
cad/previews/v04_뒤판.png
