yco252444-blip/gamja/cad/previews/v05_왼쪽판.png

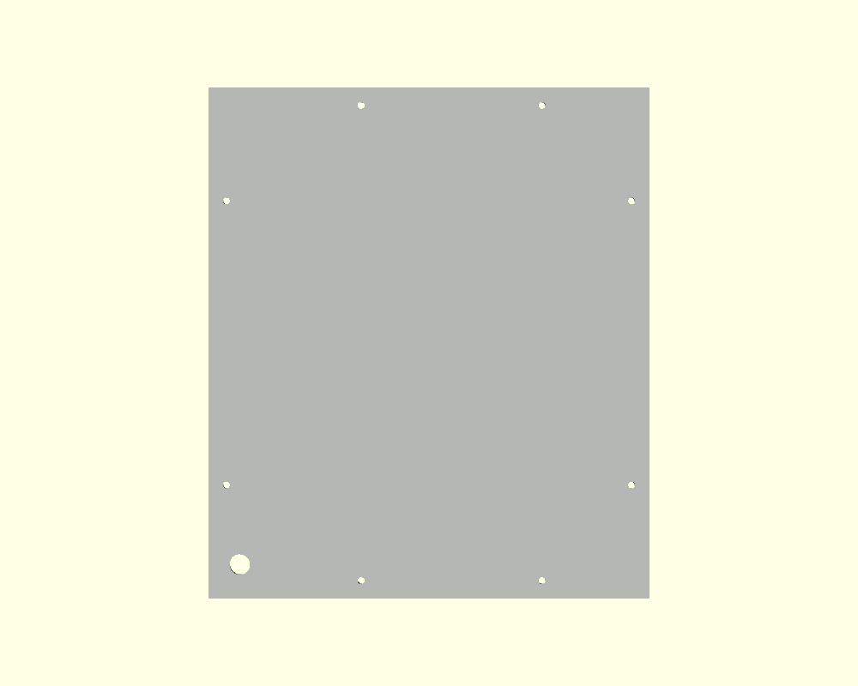
cad/previews/v05_왼쪽판.png
