yco252444-blip/gamja/cad/previews/v08_뚜껑.png

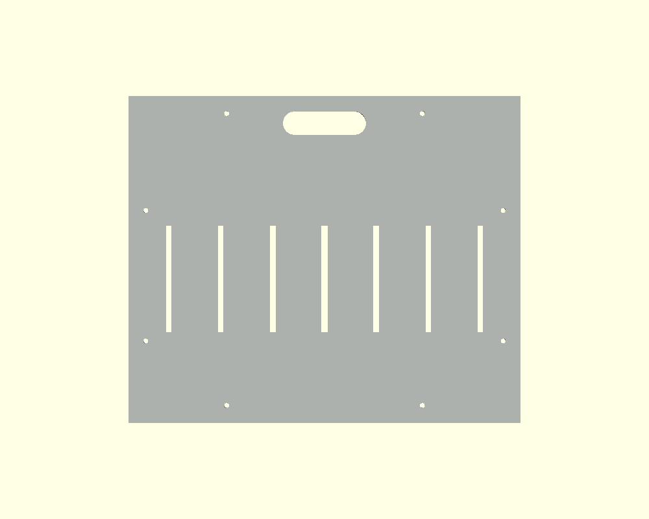
cad/previews/v08_뚜껑.png
