yco252444-blip/gamja/cad/previews/v09_브래킷.png

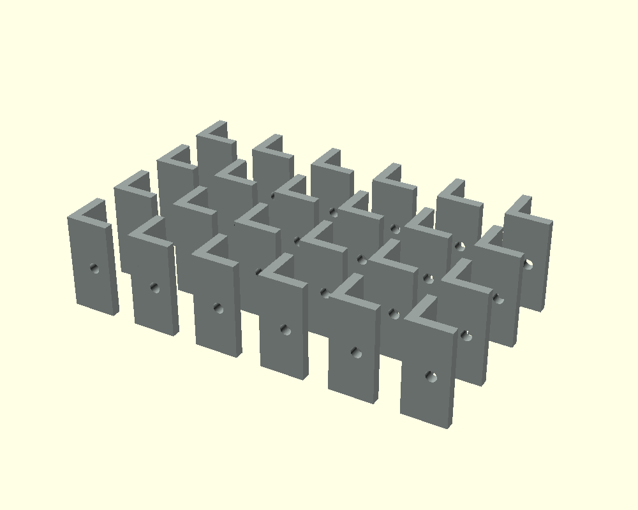
cad/previews/v09_브래킷.png
