yco252444-blip/gamja/cad/previews/v10_돼지머리_앞.png

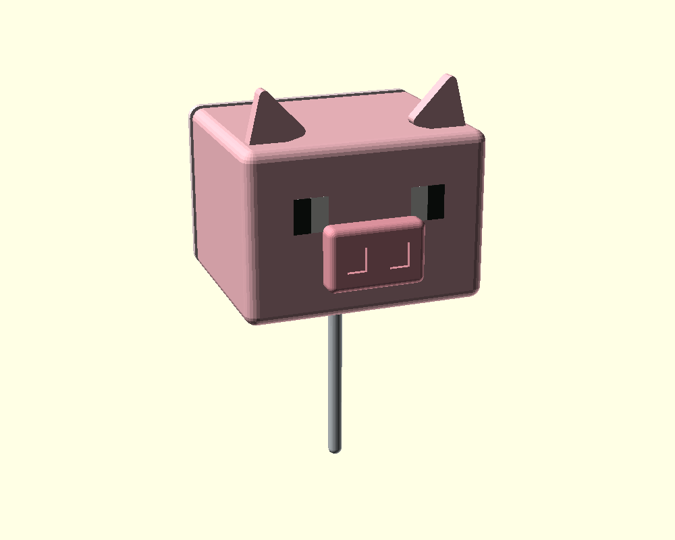
cad/previews/v10_돼지머리_앞.png
