yco252444-blip/gamja/cad/previews/v11_돼지_머리몸통.png

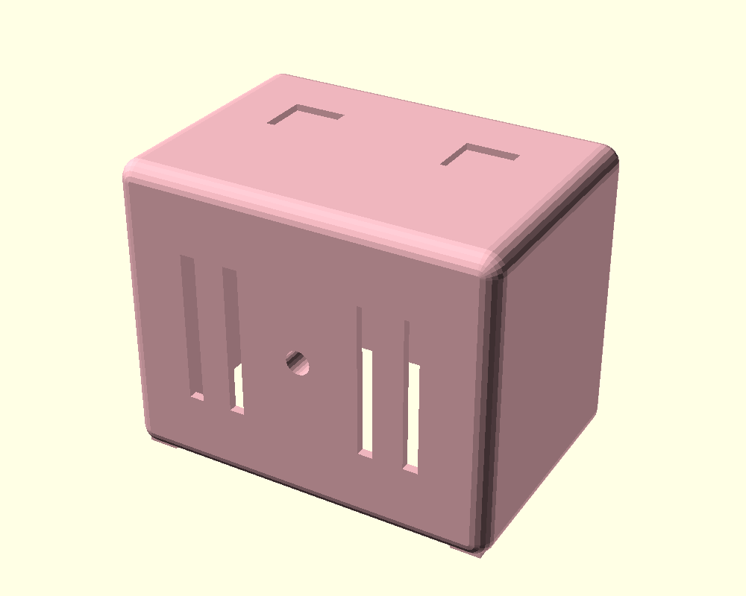
cad/previews/v11_돼지_머리몸통.png
