yco252444-blip/gamja/cad/previews/v12_돼지_뒤판.png

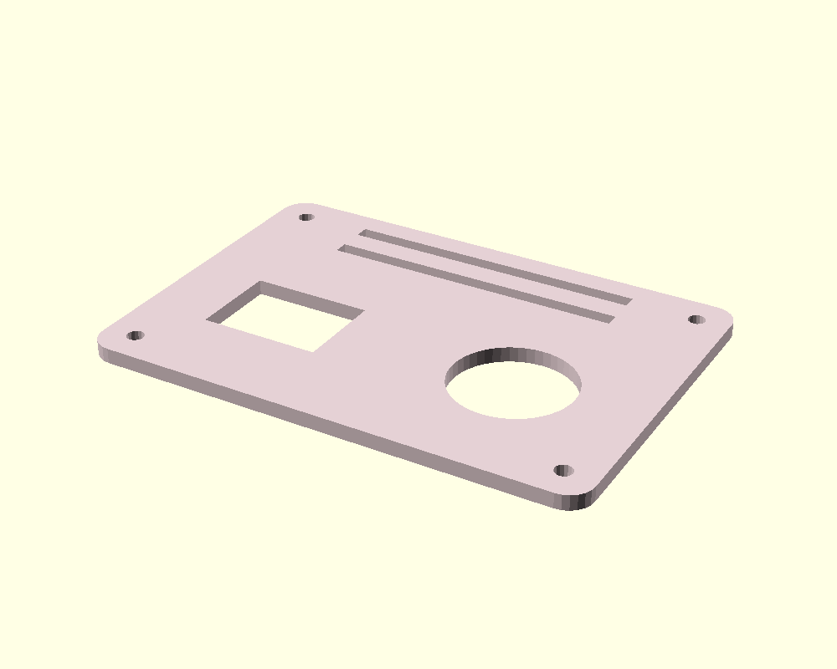
cad/previews/v12_돼지_뒤판.png
