yco252444-blip/gamja/cad/previews/v13_돼지_코귀.png

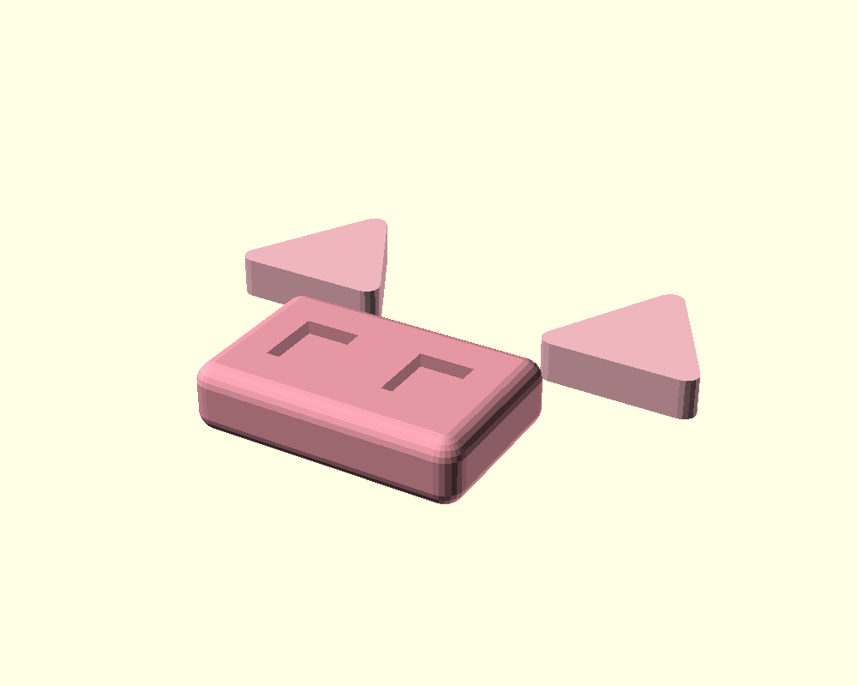
cad/previews/v13_돼지_코귀.png
