yco252444-blip/gamja/cad/previews/v15_돼지_뒤판뗀모습.png

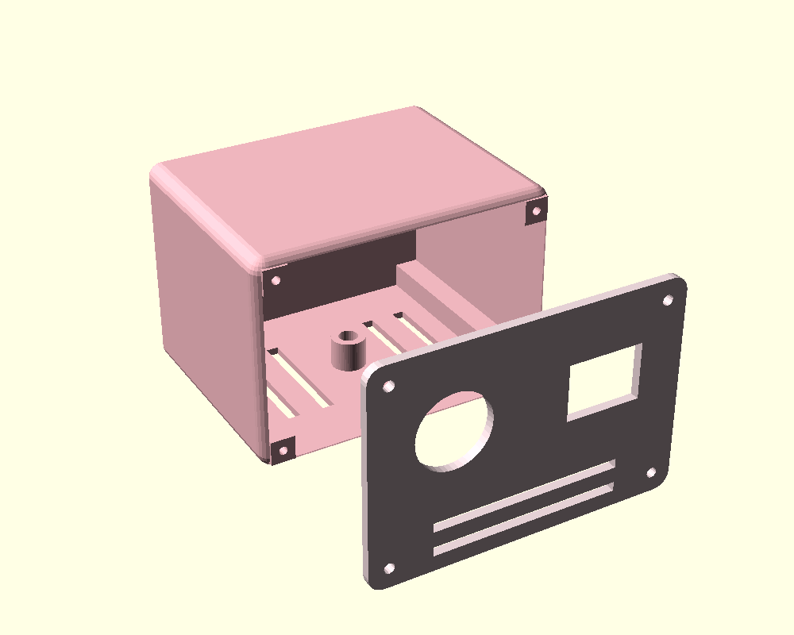
cad/previews/v15_돼지_뒤판뗀모습.png
