yco252444-blip/gamja/cad/previews/v16_평면치수도.png

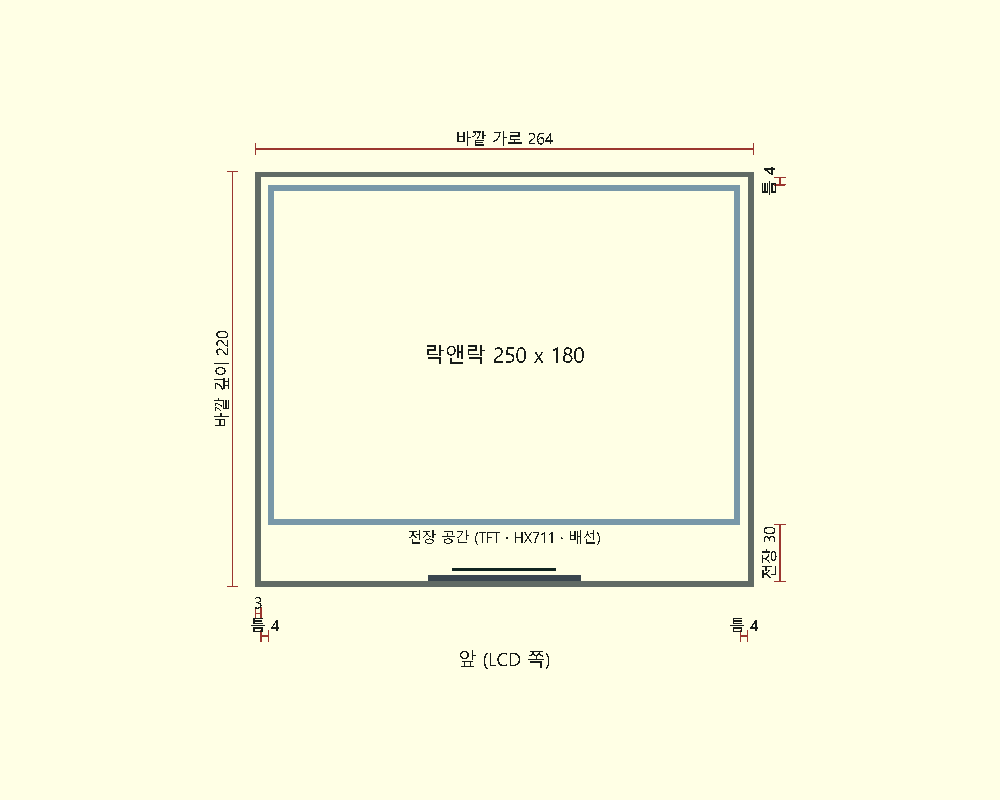
cad/previews/v16_평면치수도.png
