yco252444-blip/gamja/cad/previews/v17_측면치수도.png

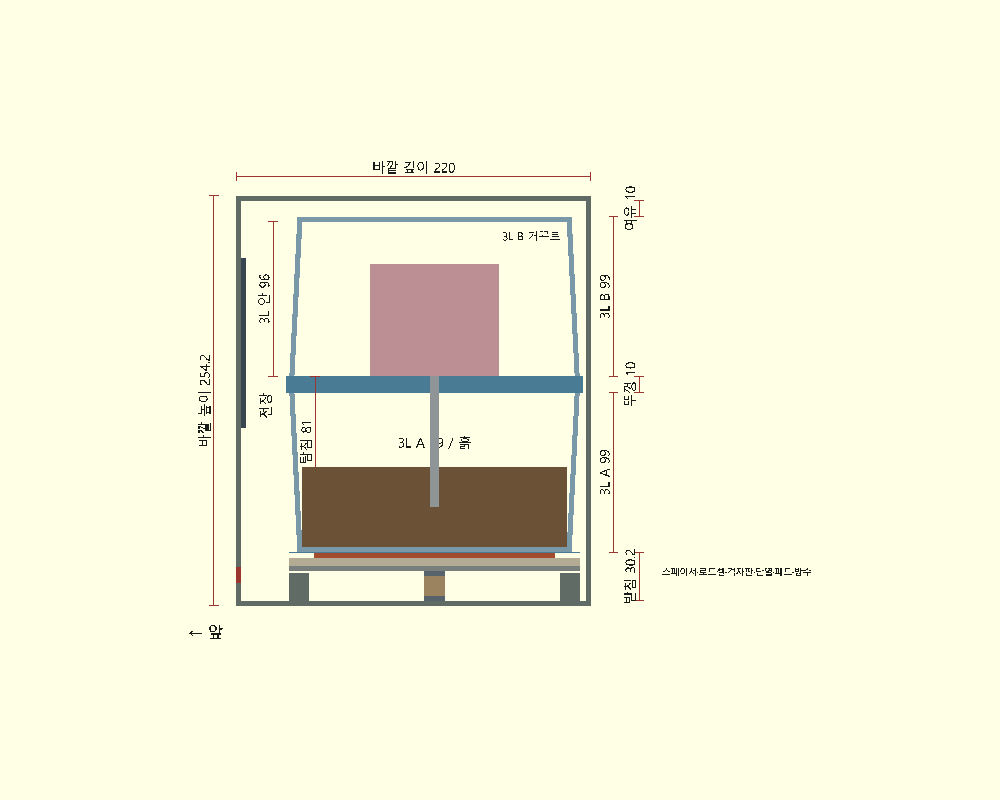
cad/previews/v17_측면치수도.png
