yco252444-blip/gamja/cad/previews/v20_스페이서.png

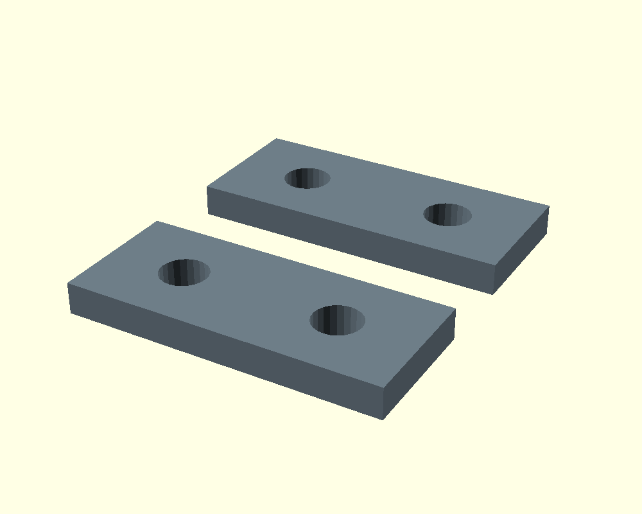
cad/previews/v20_스페이서.png
