yco252444-blip/gamja/cad/previews/v21b_격자판_고정부_근접.png

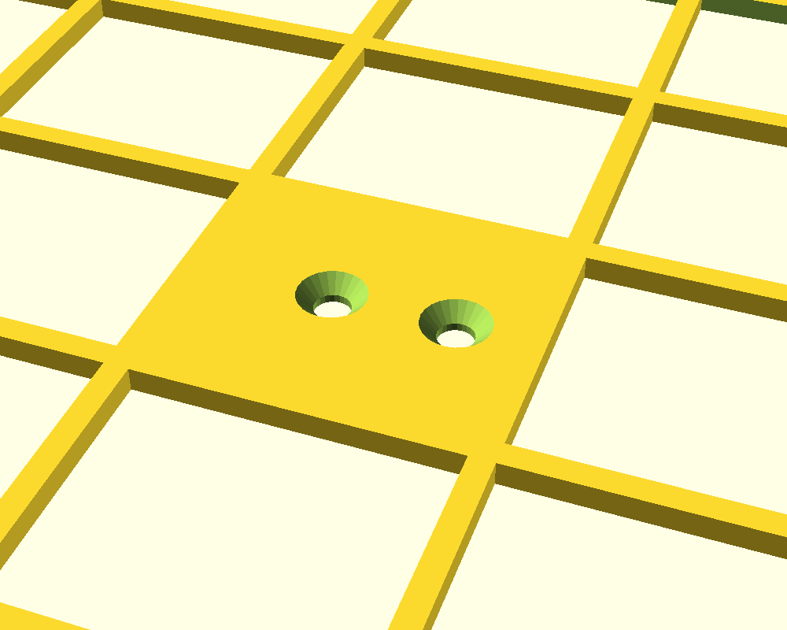
cad/previews/v21b_격자판_고정부_근접.png
