yco252444-blip/gamja/cad/previews/v22_멈춤기둥.png

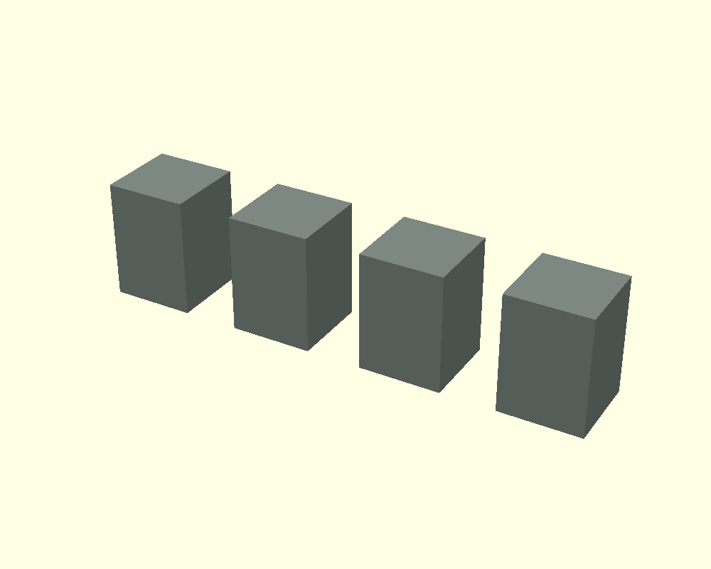
cad/previews/v22_멈춤기둥.png
