yco252444-blip/gamja/cad/previews/v23_TFT마운트.png

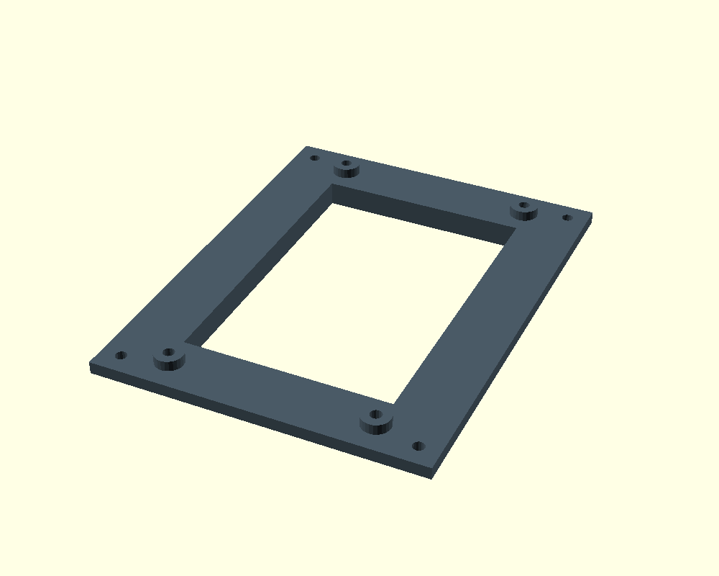
cad/previews/v23_TFT마운트.png
