yco252444-blip/gamja/cad/previews/v25_로드셀_근접옆.png

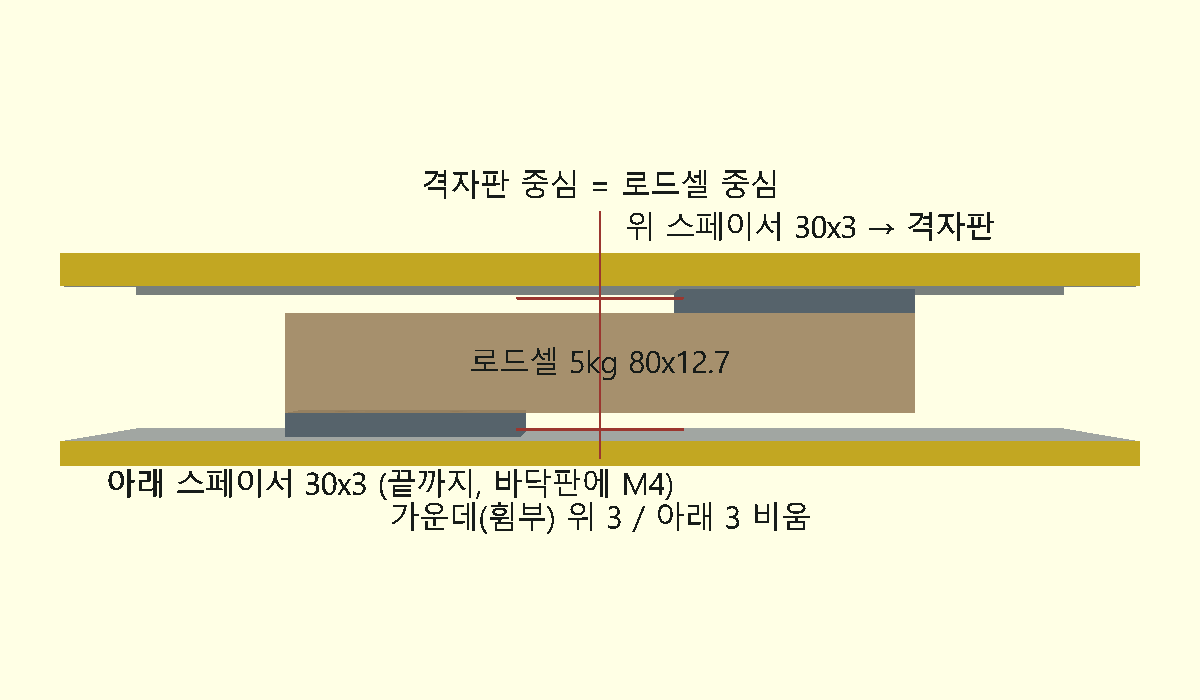
cad/previews/v25_로드셀_근접옆.png
