yco252444-blip/gamja/proposal/assets/algorithm-flow.png

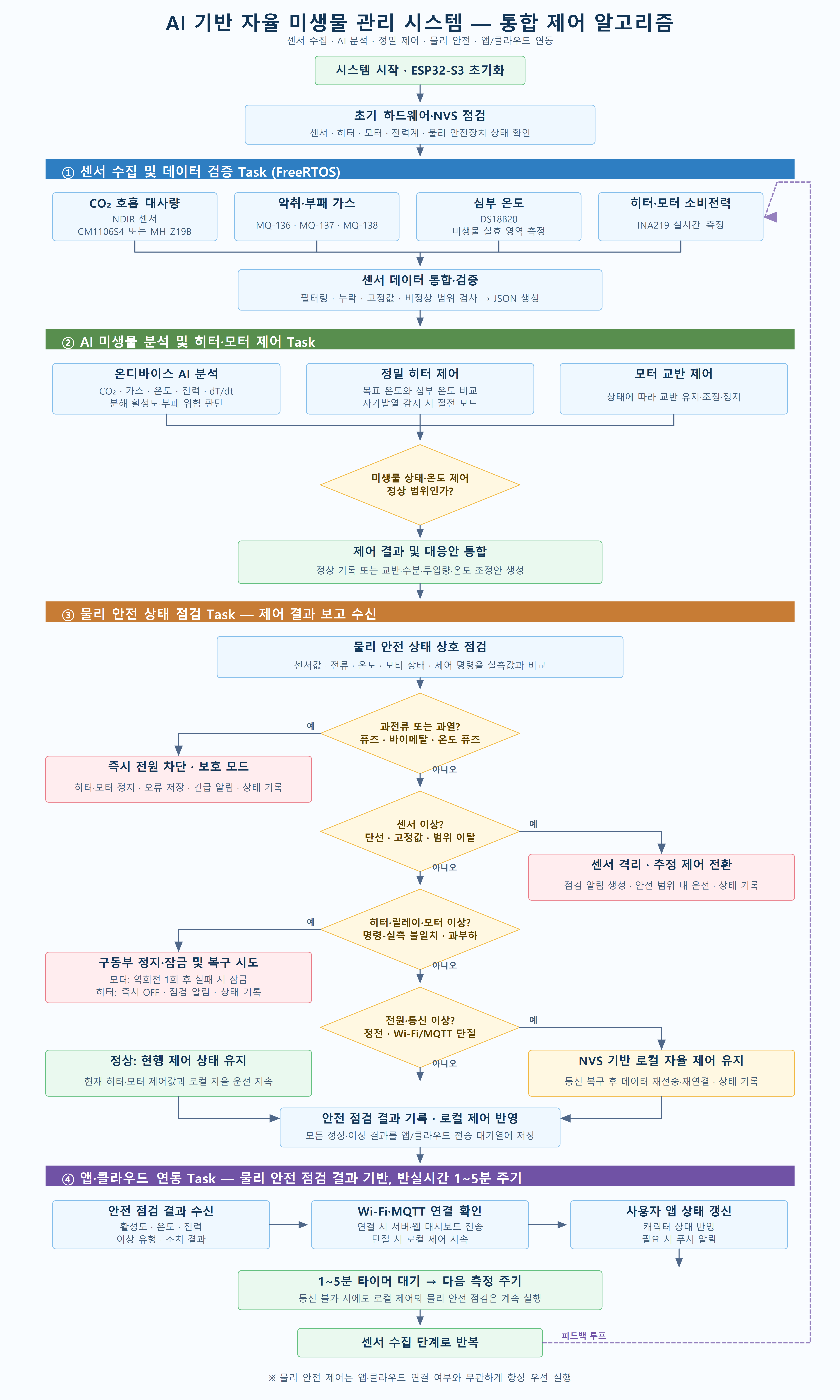
proposal/assets/algorithm-flow.png
