yco252444-blip/gamja/디스플레이/스크린샷 2026-10-29 030315.png

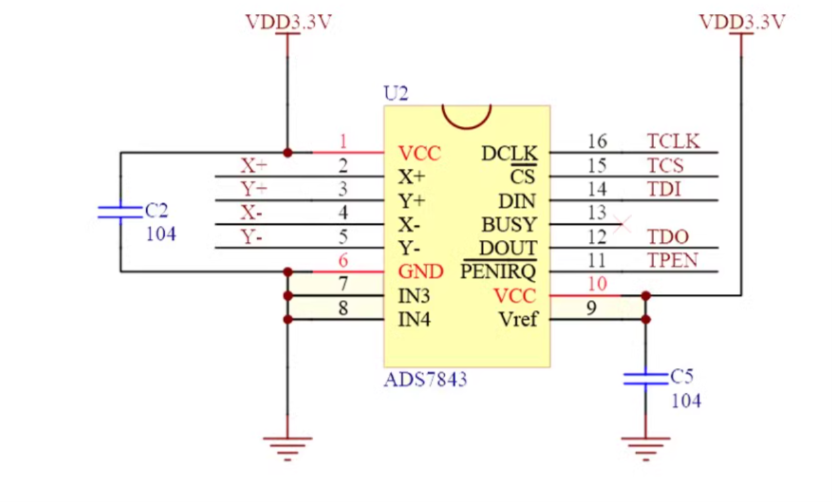
디스플레이/스크린샷 2026-10-29 030315.png
