yco252444-blip/gamja/Oink_사용소자_목록_v11.xlsx

Oink 사용 소자 목록 v11 (2026-10-25) — 히터: USB 육묘 패드 / 전력 측정 제외 / MQ-136 모듈
구분 | 품목 | Oink에서 역할 | 사용 수량 | 보유 수량 | 단가(원, VAT포함) | 금액(사용 수량×단가) | 구매 필요 금액(원) | 링크 | 비고
보유 | XIAO ESP32S3 | 메인 보드: ①제어 ②화면 ③게이트웨이 | 3 | 4 | 13640 | 40920 | 0 | 링크 (https://www.devicemart.co.kr/goods/view?no=14981265) | 4개 보유, 1개 예비
보유 | DS18B20 | 음식물 심부 온도 (히터 ON/OFF 기준) | 2 | 2 | 4730 | 9460 | 0 | 링크 (https://www.devicemart.co.kr/goods/view?no=1287129) | 젖은 음식물용 방수 프로브형인지 확인 필요
보유 | CM1106S4 | CO₂ = 미생물 호흡(분해 활성도) | 2 | 3 | 39600 | 79200 | 0 | 링크 (https://www.devicemart.co.kr/goods/view?no=12147828) | 1개 예비. 자동보정(ABC) 끄고 사용, 상시 환기구 필요
보유 | 온습도·기압 센서(BME280) | 챔버 안 습도·온도 (과습 진단) | 1 | 1 | 15950 | 15950 | 0 | 링크 (https://www.devicemart.co.kr/goods/view?no=12733519) | 외기용 → 챔버 내부용으로 변경
보유 | IRLZ44NPBF | 육묘 패드 ON/OFF 스위칭 | 1 | 1 | 1430 | 1430 | 0 | 링크 (https://www.devicemart.co.kr/goods/view?no=15947109) | 게이트 100Ω + 풀다운 10kΩ (저항 현장 제공)
보유 | OLED 0.96" 디스플레이 | 현장 상태 표시 (소형) | 1 | 11 | 6930 | 6930 | 0 | 링크 (https://www.icbanq.com/P008340623) | 3.5" TFT 사면 생략 가능
보유 | KY-006 | 이상 경보음 | 1 | 4 | 1980 | 1980 | 0 | 링크 (https://www.devicemart.co.kr/goods/view?no=1383969) | 선택
보유 | USB-C 케이블 | XIAO 연결·전원 | 3 | 1 | 6600 | 19800 | 13200 | 링크 (https://www.icbanq.com/P012113962) | 보유 1개 → 2개 부족
보유 | 브레드보드(하프) | 시제품 배선 | 2 | 5 | 2200 | 4400 | 0 | 링크 (https://www.icbanq.com/P005627998)
보유 | 핀헤더 소켓 세트 | XIAO 핀 납땜 | 1 | 1 | 165 | 165 | 0 | 링크 (https://www.icbanq.com/P000139064)
구매 필요 | USB 육묘 패드 15×22cm (5V 2A 8.5W) | 히터 (확정) | 1 | 0 | 30160 | 30160 | 30160 | 링크 (https://item.gmarket.co.kr/Item?goodscode=4746520583) | G마켓. 표면 45~50℃ 자체 제한, PVC 방수. 내장 조절기 우회는 실물 확인
구매 필요 | 5V 4A 어댑터 [WT-5V4A-C] | 육묘 패드 + 센서 전원 | 1 | 0 | 7700 | 7700 | 7700 | 링크 (https://www.devicemart.co.kr/goods/view?no=12544959) | USB-C 출력 → USB-C 브레이크아웃(또는 USB-A 변환) 필요
구매 필요 | 퓨즈홀더 F-520 + 유리관 퓨즈 3A [N51] | 패드 라인 과전류 차단 | 2 | 0 | 319 | 638 | 638 | 링크 (https://www.devicemart.co.kr/goods/view?no=4573) | 세트 단가(홀더 121 + 퓨즈 198). 퓨즈: https://www.devicemart.co.kr/goods/view?no=13132186
구매 필요 | 서모스탯 MS-1-60N (B접점=NC, 60℃) | SW와 무관한 과열 차단 (KSD301 대체) | 2 | 0 | 1309 | 2618 | 2618 | 링크 (https://www.devicemart.co.kr/goods/view?no=9724) | 자동복구, ±5℃. 패드와 직렬
구매 필요 | 5V 미니 냉각팬 30mm [ada-3368] | 환기 (CO₂ 포화 방지) | 2 | 0 | 7040 | 14080 | 14080 | 링크 (https://www.devicemart.co.kr/goods/view?no=14600629) | 상시 환기구로 대체하면 0원
구매 필요 | ILI9488 3.5" SPI TFT 터치 [THL-CD08] | 반려 미생물 캐릭터 화면 (XIAO ②) | 1 | 0 | 20900 | 20900 | 20900 | 링크 (https://www.devicemart.co.kr/goods/view?no=15454171) | 480×320 IPS, SPI → XIAO 핀으로 구동 가능
구매 필요 | 로드셀 5kg (4선식) + HX711 모듈 | 투입량·분해 무게 보조 (팀원 제안) | 1 | 0 | 16500 | 16500 | 16500 | 링크 (https://www.devicemart.co.kr/goods/view?no=1360976) | 세트 단가(로드셀 14,300 + HX711 2,200). HX711: https://www.devicemart.co.kr/goods/view?no=1327397
구매 필요 | 밀폐 용기 1.5L (락앤락 비스프리 모듈러 직사각) | 챔버 본체 | 2 | 0 | 8300 | 16600 | 16600 | 링크 (https://m.locknlockmall.com/goods/catalog?code=000100010001) | 락앤락몰 이벤트가(검색 결과 기준, 미검증). 환기구·센서 구멍 가공
구매 필요 | 단열재 (스티로폼/은박 보온재) | 열 손실 줄이기 | 1 | 0 | 3000 | 3000 | 3000 |  | 추정(미검증). 다이소 매장 구매 권장
구매 필요 | 미생물 배지 | 분해 미생물 | 2 | 0 |  |  | 가격 조회 필요 |  | 적합한 상품 미선정 → 추가 조사 필요
구매 필요 | MQ-136 황화수소 센서 모듈 (보드 포함) | 부패 가스(H₂S) 추세 경보 | 1 | 0 | 22800 | 22800 | 22800 | 링크 (https://smartstore.naver.com/sksktmdi/products/12137961876) | 네이버 스마트스토어(DONG), 22,800원 무료배송, 국내 발송(10/26 발송 예정). 옵션: 색상(기본). 5V 아날로그 → 10k/12k 분압, 예열 필요
 |  |  |  |  | 합계 | 315231 | 148196
 |  |  |  |  | 예산 상한 |  | 300000
 |  |  |  |  | 남은 예산 |  | 151804
