yco252444-blip/gamja/cad/previews/hires/v02b_parts.txt

# v02b_분해도_hi.png (3200x2560) 부품 중심 픽셀 (x, y), 원점 = 왼쪽 위. 카메라 --camera=150,100,480,62,0,32,3200 (원근, fov 22.5)
# 모델 좌표를 같은 카메라로 투영한 값 (표식 렌더로 확인, 오차 약 1px). 가려진 부품은 그 자리 기준
1	케이스 뚜껑 (아크릴)	1578, 175
2	위 3L 통 (뒤집어 덮음)	1593, 390
3	돼지 머리 + 탐침	1593, 687
4	아래 3L 뚜껑 (탐침 구멍)	1593, 858
5	아래 3L 통 (흙)	1593, 1025
6	방수판 0.5	1593, 1188
7	육묘 패드 약 3	1593, 1259
8	단열판 5	1593, 1329
9	격자 받침판 (PETG)	1593, 1410
10	로드셀 + 스페이서 2 (Z 마운트)	1593, 1476
11	기울기 멈춤 기둥 4 (앞 왼쪽 1개 기준)	1308, 1487
12	앞판 (아크릴) + TFT 마운트	1346, 2061
13	뒤판 (아크릴)	1793, 1671
14	왼쪽 판 (아크릴)	1203, 1727
15	오른쪽 판 (아크릴)	1984, 1995
16	바닥판 (아크릴)	1708, 2069
17	L 브래킷 (6개만 표시)	1963, 2305
