yco252444-blip/gamja/cad/dxf/뚜껑_acryl.dxf

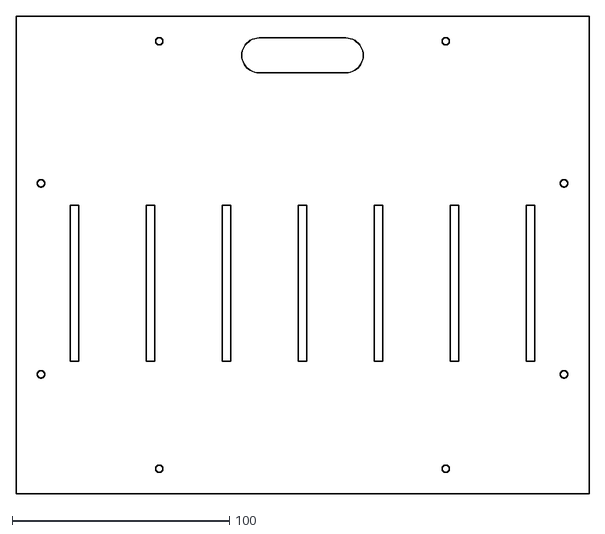
[picture p29: CAD file, 2026-10-31]
cad/dxf/뚜껑_acryl.dxf
264.0 x 220.0
