yco252444-blip/gamja/cad/stl/앞판_acryl_3t.stl

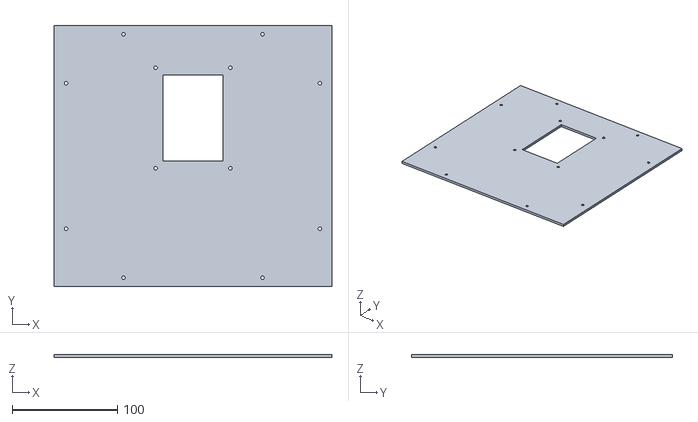
[picture p30: CAD file, 2026-10-31]
cad/stl/앞판_acryl_3t.stl
264.0 x 248.2 x 3.00
