yco252444-blip/gamja/설계_1031/stl/돼지_머리몸통.stl

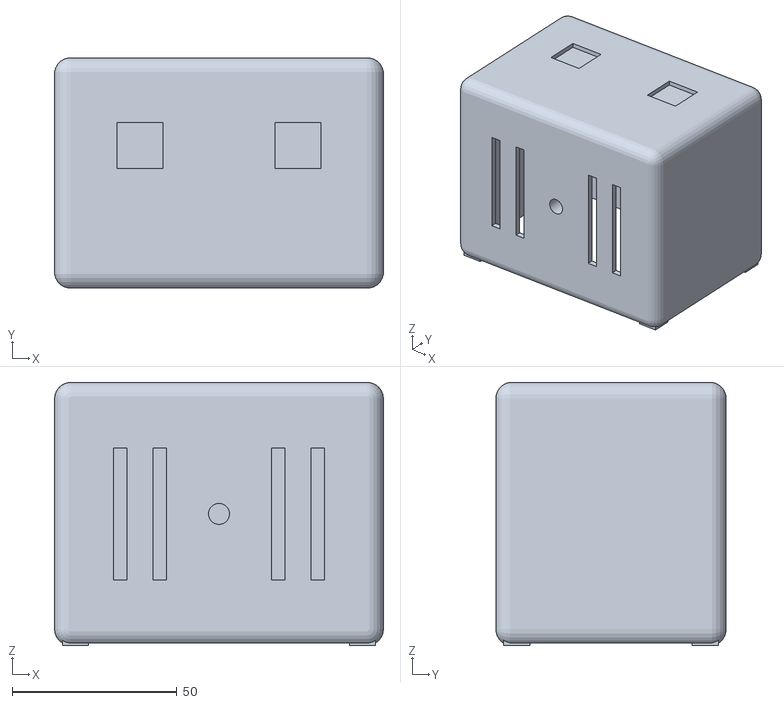
[picture p31: CAD file, 2026-10-31]
설계_1031/stl/돼지_머리몸통.stl
99.9 x 69.9 x 80.0
