yco252444-blip/gamja/cad/dxf/뒤판_acryl.dxf

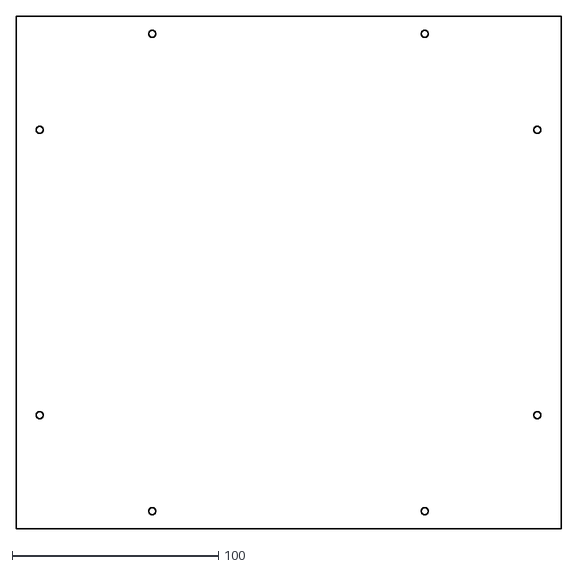
[picture p32: CAD file, 2026-10-31]
cad/dxf/뒤판_acryl.dxf
264.0 x 248.2
