yco252444-blip/gamja/cad/stl/바닥판_acryl_3t.stl

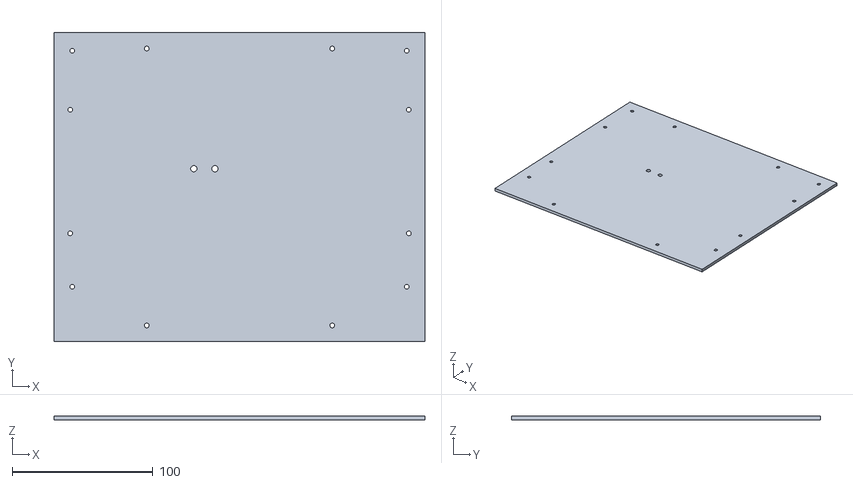
[picture p33: CAD file, 2026-10-31]
cad/stl/바닥판_acryl_3t.stl
264.0 x 220.0 x 3.00
