yco252444-blip/gamja/설계_1031/stl/L브래킷_24개.stl

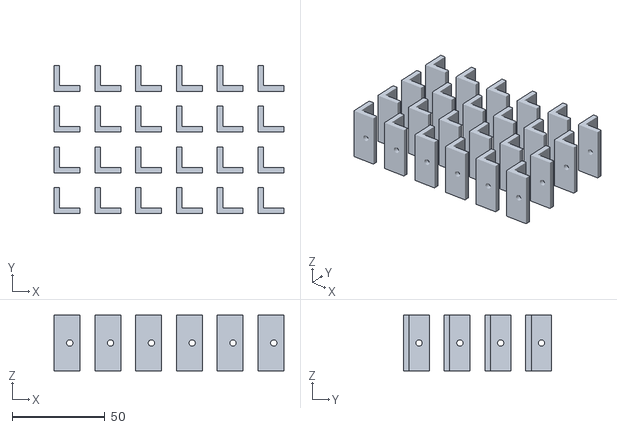
[picture p34: CAD file, 2026-10-31]
설계_1031/stl/L브래킷_24개.stl
124.0 x 80.0 x 30.0
