yco252444-blip/gamja/cad/dxf/왼쪽판_acryl.dxf

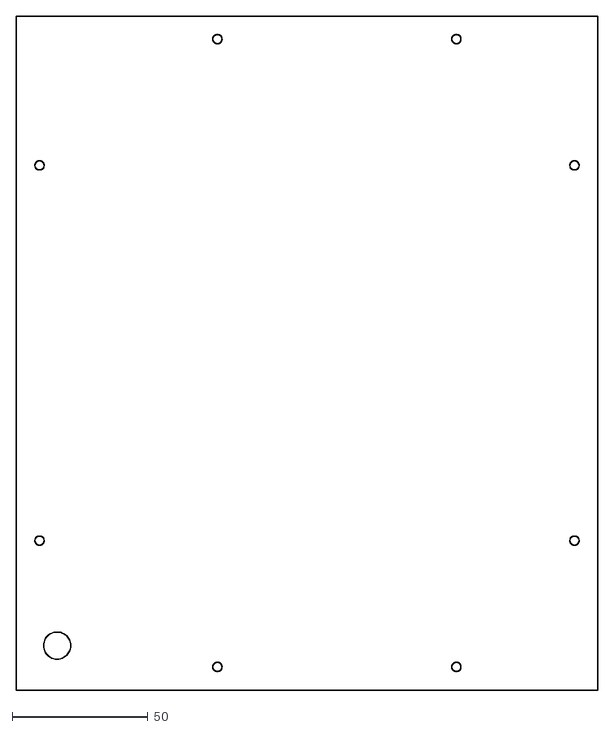
[picture p35: CAD file, 2026-10-31]
cad/dxf/왼쪽판_acryl.dxf
214.0 x 248.2
