yco252444-blip/gamja/cad/stl/격자받침판_PETG.stl

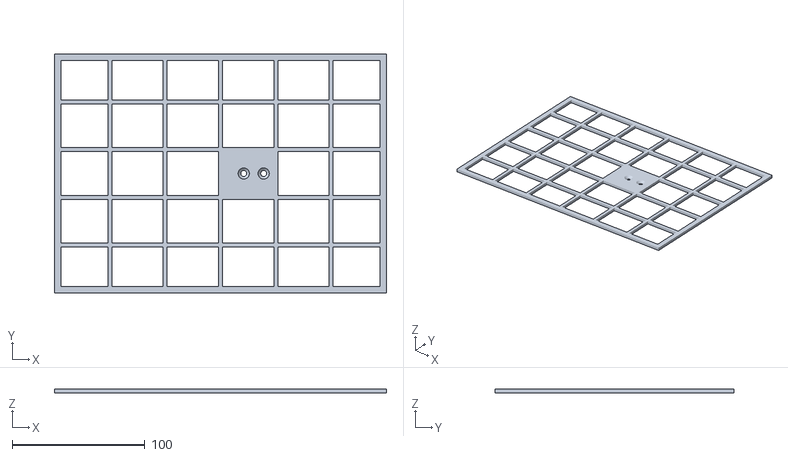
[picture p36: CAD file, 2026-10-31]
cad/stl/격자받침판_PETG.stl
250.0 x 180.0 x 3.00
