yco252444-blip/gamja/설계_1031/stl/멈춤기둥4개.stl

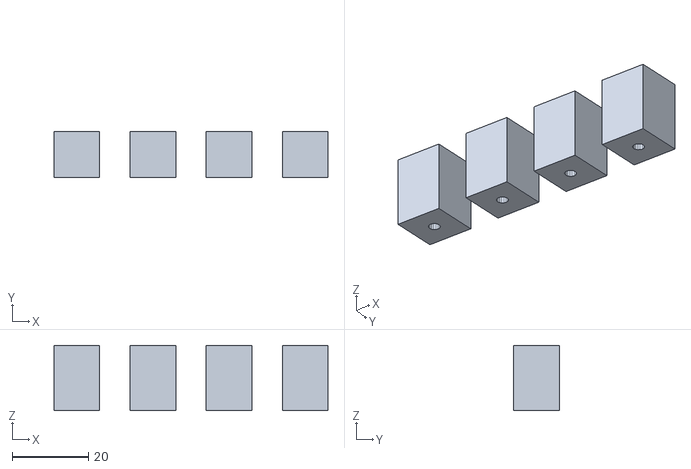
[picture p37: CAD file, 2026-10-31]
설계_1031/stl/멈춤기둥4개.stl
72.0 x 12.0 x 17.2
