yco252444-blip/gamja/cad/dxf/바닥판_acryl.dxf

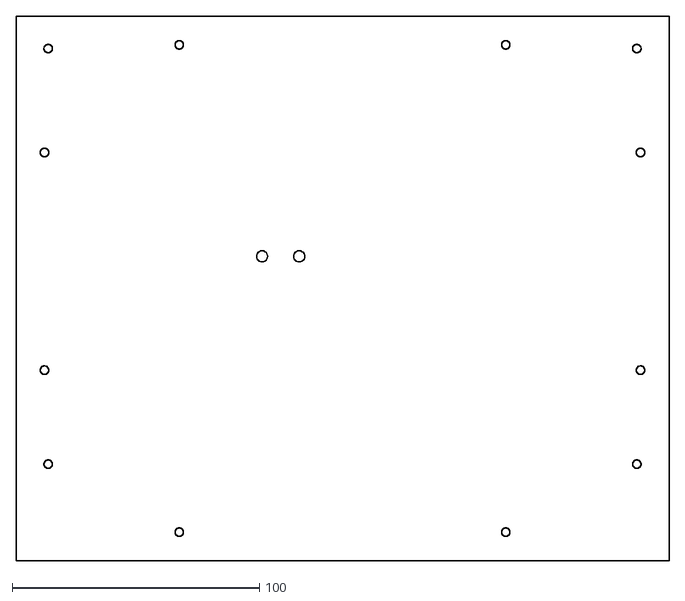
[picture p38: CAD file, 2026-10-31]
cad/dxf/바닥판_acryl.dxf
264.0 x 220.0
