yco252444-blip/gamja/cad/stl/왼쪽판_acryl_3t.stl

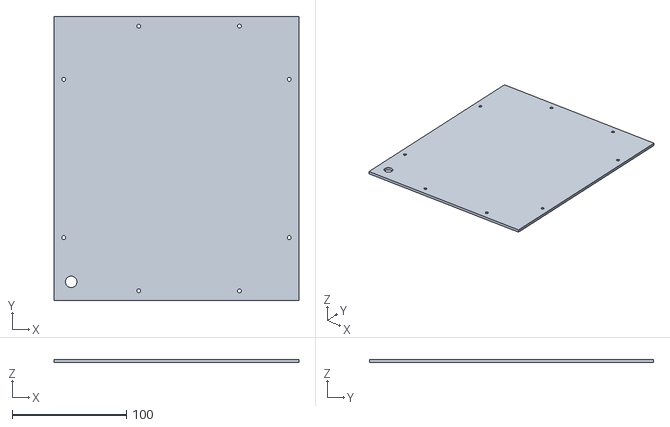
[picture p39: CAD file, 2026-10-31]
cad/stl/왼쪽판_acryl_3t.stl
214.0 x 248.2 x 3.00
