yco252444-blip/gamja/설계_1031/stl/돼지_뒤판.stl

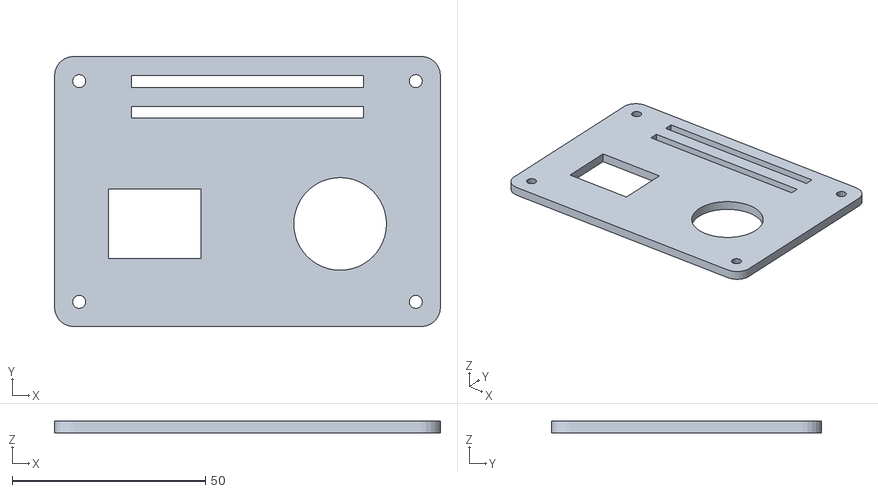
[picture p40: CAD file, 2026-10-31]
설계_1031/stl/돼지_뒤판.stl
100.0 x 70.0 x 3.00
