yco252444-blip/gamja/cad/dxf/앞판_acryl.dxf

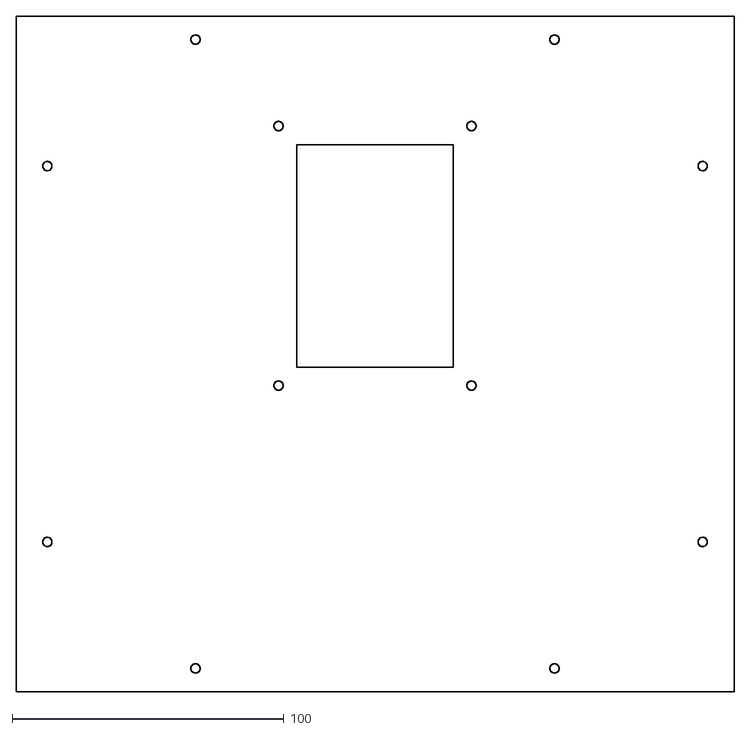
[picture p41: CAD file, 2026-10-31]
cad/dxf/앞판_acryl.dxf
264.0 x 248.2
