yco252444-blip/gamja/설계_1031/stl/스페이서2개.stl

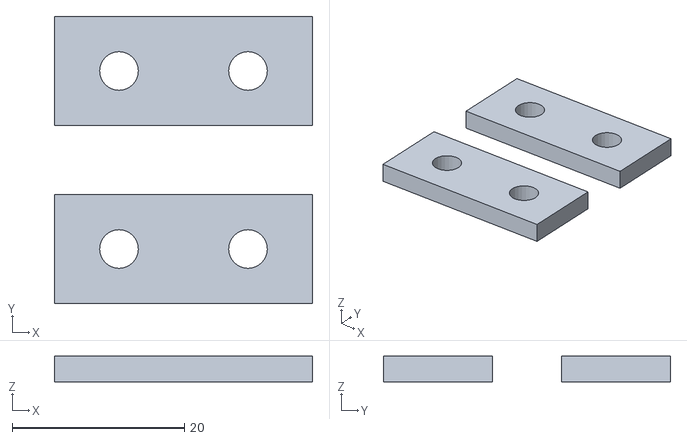
[picture p42: CAD file, 2026-10-31]
설계_1031/stl/스페이서2개.stl
30.0 x 33.4 x 3.00
