yco252444-blip/gamja/cad/dxf/오른쪽판_acryl.dxf

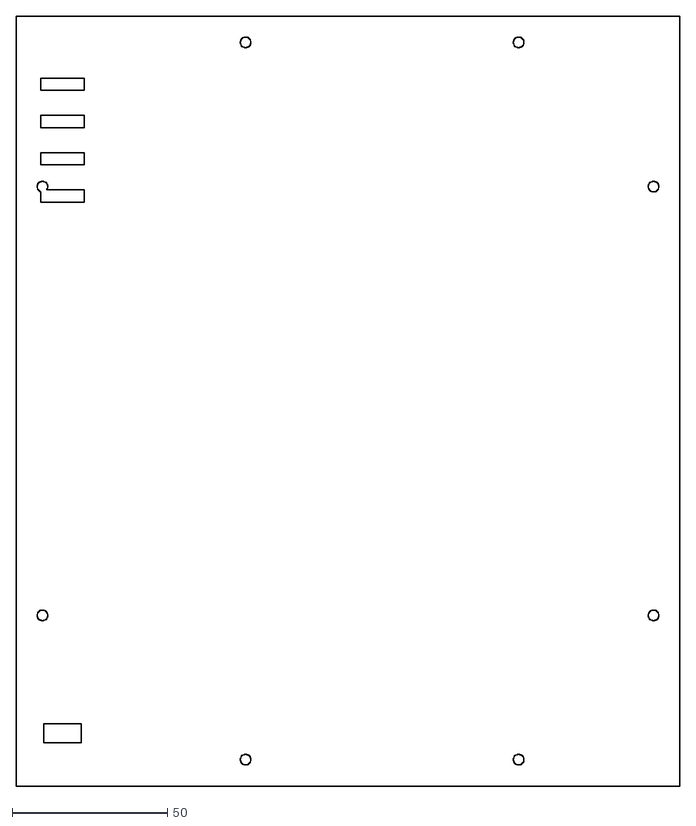
[picture p43: CAD file, 2026-10-31]
cad/dxf/오른쪽판_acryl.dxf
214.0 x 248.2
