yco252444-blip/gamja/설계_1031/stl/TFT마운트.stl

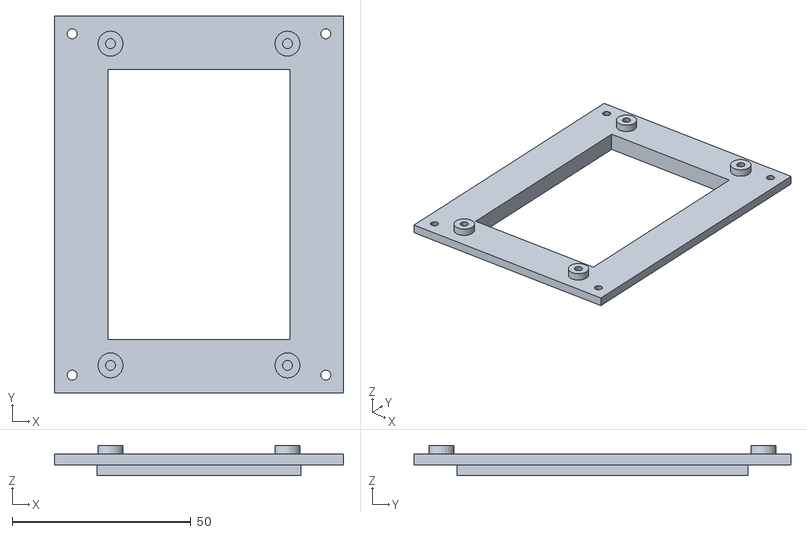
[picture p44: CAD file, 2026-10-31]
설계_1031/stl/TFT마운트.stl
81.0 x 105.4 x 8.50
