yco252444-blip/gamja/설계_1031/stl/돼지_코귀.stl

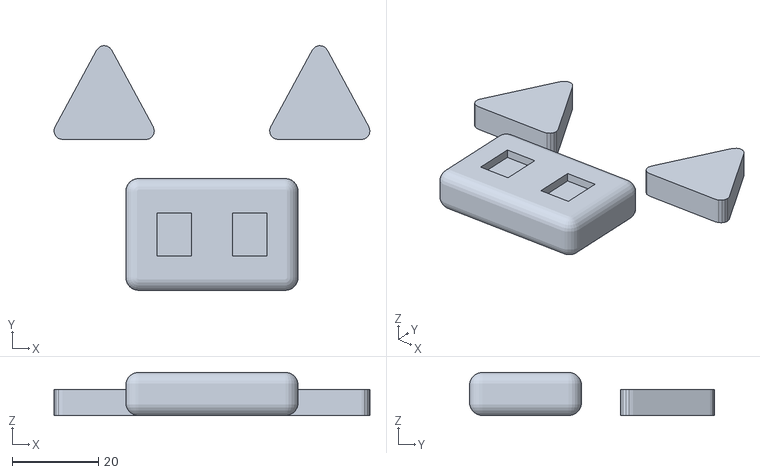
[picture p45: CAD file, 2026-10-31]
설계_1031/stl/돼지_코귀.stl
73.3 x 56.8 x 9.97
