yco252444-blip/gamja/(list of files, cad)

Other CAD files:
cad/stl/뒤판_acryl_3t.stl
cad/stl/뚜껑_acryl_3t.stl
cad/stl/오른쪽판_acryl_3t.stl
cad/oink_exterior.scad
cad/_old_1029/stl/뒤판_acryl_3t.stl
cad/_old_1029/stl/뚜껑_acryl_3t.stl
cad/_old_1029/stl/오른쪽판_acryl_3t.stl
