yco252444-blip/gamja/cad/previews/v01_전체조립.png

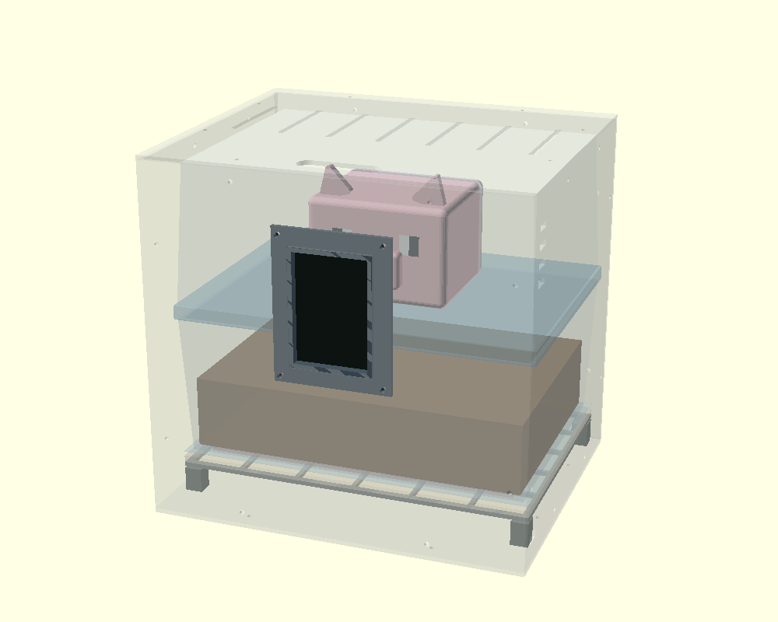
cad/previews/v01_전체조립.png
