yco252444-blip/gamja/cad/previews/v19_받침_조립.png

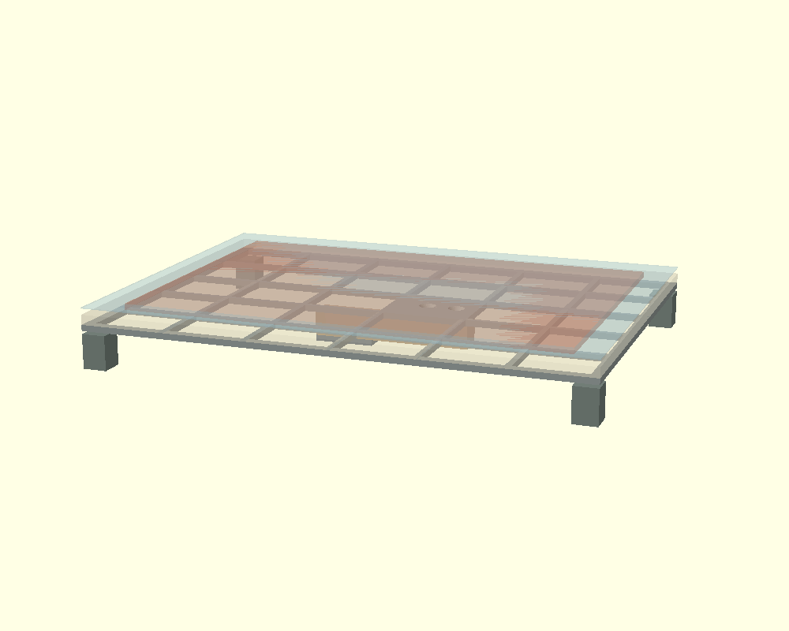
cad/previews/v19_받침_조립.png
