yco252444-blip/gamja/cad/previews/v24_TFT마운트_조립_뒤.png

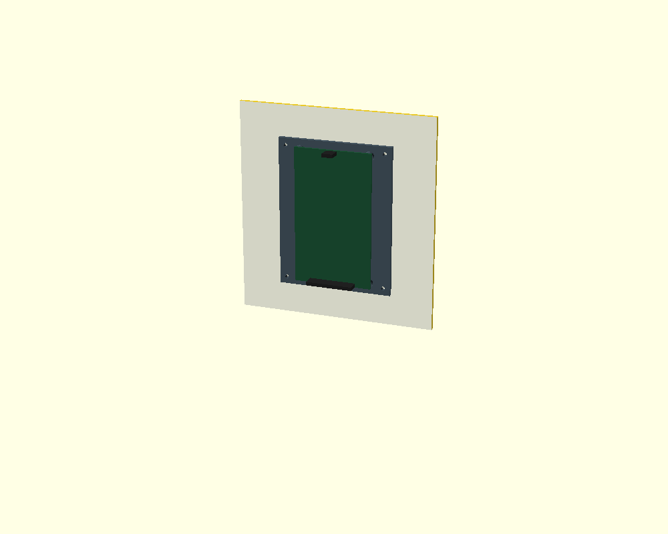
cad/previews/v24_TFT마운트_조립_뒤.png
