yco252444-blip/gamja/(commit log)

2026-10-31 Import Oink (gamja1610/Oink main, 10/29 snapshot)
    Claude-Session: https://claude.ai/code/session_0118JuG6ZfmFjUZm3esDKfG6
    [L브래킷_24개.stl, Oink_사용소자_목록_v11.xlsx, TFT마운트.stl, oink_exterior.scad, 격자받침판_PETG.stl, 돼지_뒤판.stl, 돼지_머리몸통.stl, 돼지_코귀.stl]
2026-10-31 CAD 재설계: 통 12x12x12 x2, 히팅패드·방열판 Ø90
    - 받침층 30.2, 돼지 머리 유지
    - 격자판 120x120, 멈춤 기둥 네 변 가운데로 이동
    - 케이스 134x160x296.2 (top_gap 10)
    - 이전 DXF/STL/미리보기는 cad/_old_1029 로 이동, render_1031.bat 추가
    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
    [oink_exterior.scad, 격자받침판_PETG.stl, 뒤판_acryl.dxf, 뒤판_acryl_3t.stl, 뚜껑_acryl.dxf, 뚜껑_acryl_3t.stl, 바닥판_acryl.dxf, 바닥판_acryl_3t.stl]
2026-10-31 10/31 설계를 설계_1031/ 폴더로 분리, cad/는 10/29 원본으로 복원
    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
    [L브래킷_24개.stl, TFT마운트.stl, oink_exterior.scad, 격자받침판_PETG.stl, 돼지_뒤판.stl, 돼지_머리몸통.stl, 돼지_코귀.stl, 뒤판_acryl.dxf]
